nakhonthai/ESP32APRS_Audio/README.md

## Arduino core for the ESP32, ESP32-C3, ESP32-C6 and ESP32-S3

# ESP32APRS Audio(Speaker/Mic) Project

ESP32APRS Audio is a Internet Gateway(IGate)/Digital Repeater(DiGi)/Tracker/Weather(WX)/Telemetry(TLM) with AFSK/GFSK TNC Built in that is implemented for Espressif ESP32 processor.

## Feature

* Supported hardware: ESP32DR Simple,ESP32DR,D.I.Y Other
* Supported RF Module: SA8x8/FRS VHF/UHF/350 model
* Support APRS internet gateway (IGATE)
* Support APRS digital repeater (DIGI)
* Support APRS tracker (TRACKER)
* Support APRS Weather (WX)
* Support APRS telemetry (TLM)
* Support APRS Message (MSG)
* Support GNSS External mod select UART0-2 and TCP Client
* Support TNC External mod select UART0-2 and Yaesu packet
* Support APRS IGATE/DIGI/WX/Telemetry with fix position for move position from GNSS
* Using ESP-Arduino development on Visual studio code + Platform IO
* Implementing software modem, decoding and encoding
* Support monitor display information and statistices
* Support Wi-Fi multi station or WiFi Access point
* support Web Service config and control system
* support filter packet rx/tx on igate,digi,display
* support audio filter BPF,HPF
* support VPN wireguard
* support global time zone
* support web service auth login
* support BLUETOOTH SPP/BLE
* support PPPoS (PPP Over Serial GSM network)
* support MQTT
* support AT-Command config/ctl by channel UART,MSG,Bluetooth
* support Automatic REBOOT by interval time
* display received and transmit packet on the LED and display OLED or led color strip
* Multiple modems: credit coding from project [vp-digi](https://github.com/sq8vps/vp-digi)
  * 1200bps AFSK Bell 202 1200/2200Hz (VHF standard)
  * 300bps AFSK Bell 103 1600/1800Hz (HF standard)
  * 9600bps GFSK G3RUH (For ESP32-S3)
  * 1200bps AFSK V.23
* Analog-digital busy channel detection (data carrier detection)
* AX.25 coder/decoder
* FX.25 (AX.25 with error correction) coder/decoder, fully compatible with [Direwolf](https://github.com/wb2osz/direwolf) and [UZ7HO Soundmodem](http://uz7.ho.ua/packetradio.htm)

## Hardware screen short
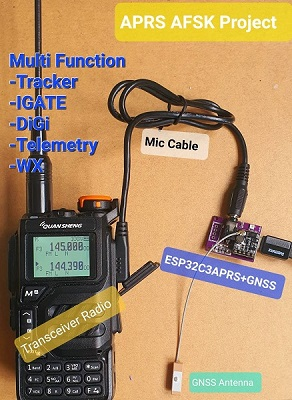
[picture p1: image/ESP32C3APRS_Radio.jpg]
esp32c3aprs_radio
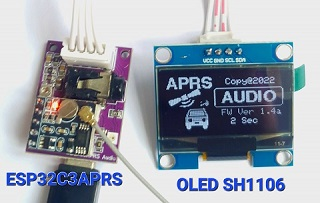
[picture p2: image/ESP32C3APRS_OLED.jpg]
esp32c3aprs_oled
 
esp32dr_simple esp32dr_sa868
esp32dr_sa868_pcb

## Hardware mod
esp32dr_sql 

## Web service screen short
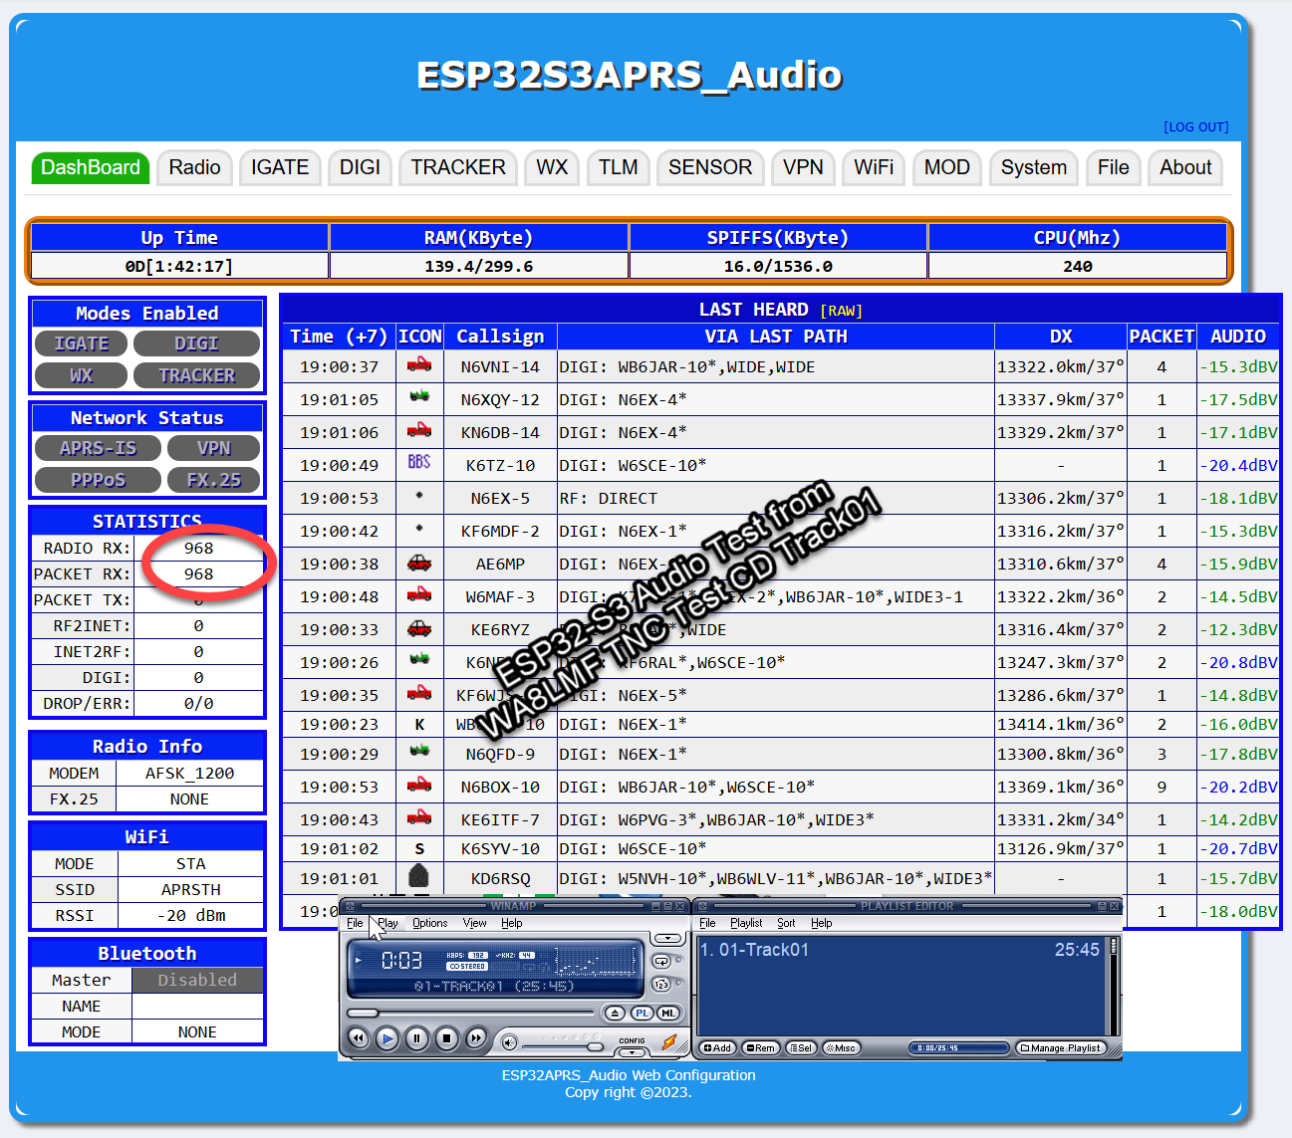
[picture p3: image/ESP32S3_CDTest.png]
ESP32S3_CDTest
 screen_dashboard screen_igate \
screen_mod

## ESP32DR_SA868
Share project [here](https://oshwlab.com/APRSTH/esp32sa818) \
Schematic [here](doc/ESP32DR_SA868/ESP32DR_SA868_sch.pdf) \
PCB Gerber [hare](doc/ESP32DR_SA868/ESP32DR_SA868_Gerber.zip)

## ESP32DR Simple

esp32dr_simple_3d

ESP32DR Simple Circut is small interface board for connecting to a transceiver.

* PCB size is 64x58mm
* PCB Single size
* RJ11 6 Pin out to Radio

### Fix Audio input/output port
|ESP32 Core|ADC(Speaker)|DAC(Mic)|
|---|:---:|---|
|ESP32|GPIO36|GPIO26|
|ESP32-C3|GPIO0|GPIO1|
|ESP32-S3|GPIO1|GPIO2|

### Schematic
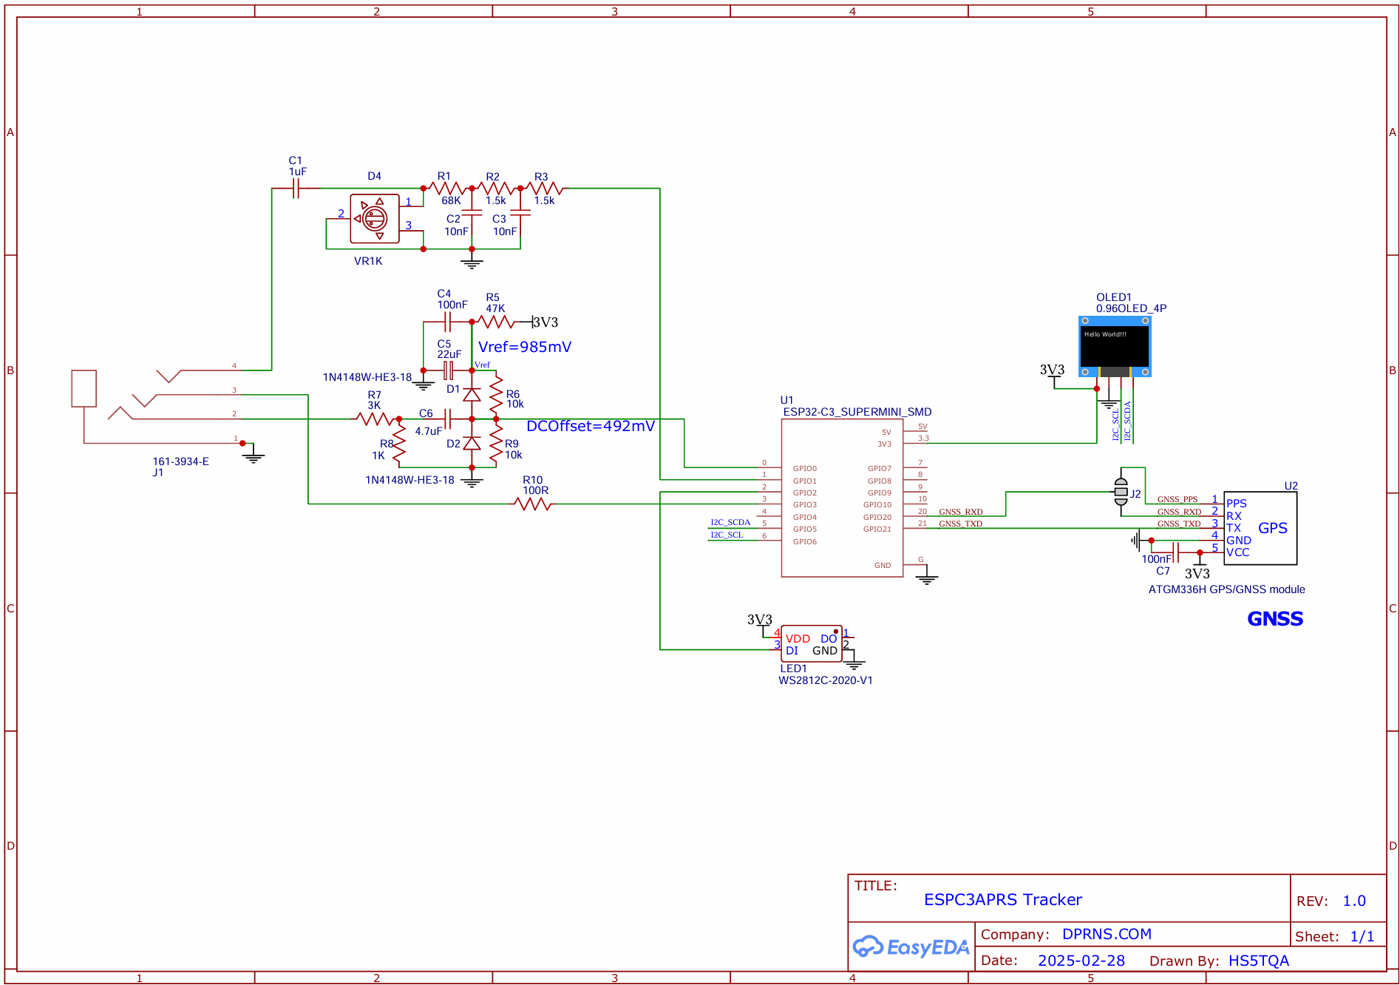
[picture p4: image/Schematic_ESPC3_APRS.png]
ESP32C3APRS


ESP32DR_Simple

### CAD data
 
The gerber data is [here](doc/Gerber_ESP32DR_Simple.zip)

The PCB film positive is [here](doc/PCB_Bottom.pdf)

The PCB film negative is [here](doc/PCB_Bottom_Invert.pdf)

The PCB Layout is [here](doc/PCB_Layout.pdf)

The ESP32DR_Simple Schematic PDF is [here](doc/ESP32DR_Simple_Schematic.pdf)

The ESP32C3APRS Schematic PDF is [here](doc/Schematic_ESPC3_APRS.pdf)

### BOM list  

|Reference|Value|Description|
|---|:---:|---|
|U1|ESP32 DEVKIT|DOIT ESP32 DEVKIT (โมดูล ESP32)|
|RP2|1K|VR 3362W (R ปรับค่าเสียงออก)|
|RP1|10K|VR 3362W (R ปรับค่าเสียงเข้า)|
|RJ11|RJ11-6P6C|แจ๊คโมดูล RJ11 แบบ 6ขา|
|R13,R12,R11,R5,R3,R9|1K|R 1K 1/4W (ค่าสี: น้ำตาล ดำ แดง)|
|R7,R18,R19|100R|R 100R  1/4W (ค่าสี: น้ำตาล ดำ ดำ)|
|R6,R2,R1|10K|R 10k  1/4W  (ค่าสี: น้ำตาล ดำ ส้ม)|
|R4|3K|R 3k 1/4W (ค่าสี: ส้ม ดำ แดง)|
|R10|33K|R 33K 1/4W (ค่าสี: ส้ม ส้ม ส้ม)|
|Q1|2N3904|ทรานซิสเตอร์ NPN (TO-92)|
|LED3|LED 3.5mm|สีเหลือง แสดงส่งสัญญาณ TX|
|LED2|LED 3.5mm|สีเขียว แสดงรับสัญญาณ RX|
|LED1|LED 3.5mm|สีแดง แสดงไฟเข้าทำงาน|
|L1|L or JMP|L Isolate or Jumper|
|C11|100uF/6.3V|ตัวเก็บประจุแบบอิเล็กโทรไลติก|
|C4,C5|100nF|ตัวเก็บประจุแบบเซรามิกมัลติเลเยอร์|
|C6|470uF/10V|ตัวเก็บประจุแบบอิเล็กโทรไลติก|
|C1,C3,C10|100nF หรือ 0.1uF|ตัวเก็บประจุแบบโพลีโพรไพลีน|
|C2|10nF หรือ 0.01uF|ตัวเก็บประจุแบบโพลีโพรไพลีน|
|D2,D1|1N4148|ไดโอด หรือใช้ C 0.01uF แทนได้|

*R18 and R19 ไม่ใส่ก็ได้.  
*D2,D1 เปลี่ยนเป็นตัวเก็บประจุแบบเซรามิกมัลติเลเยอร์ค่า 10nF แทนได้ 
*หากใช้ต่อกับวิทยุรับส่งเข้าขาไมค์นอก ให้เปลี่ยน R4 เป็น 100K

จัดซื้อชุดคิทผ่าน Shopee ได้ที่ [คลิ๊ก](https://shopee.co.th/product/45191268/13373396785)

The Howto DIY is [here](doc/ESP32DR_DIY-Thai.pdf)

### Mounting drawing

mounting

### Transceiver connection

Solder jumper is needed depending on a transceiver.

ESP32DR_Pinout

|Manufacture|RJ11-1 (+VIN)|RJ11-2 (SPK)|RJ11-3 (PTT)|RJ11-4 (GND)|RJ11-5 (MIC)|RJ11-6 (SQL)|
|---|---|---|---|---|---|---|
|Alinco DR-135(DB9)|-|2|7|5|9|1|
|IC2200(RJ45)|-|SP|4|5|6|-|
|FT-2800(RJ11)|-|SP|1|3|2|-|
|HT Mic Cable|-|SPK|PTT|GND|MIC|-|

for Alinco DR-135(DB9)

Alinco

for ICOM IC2200(RJ45)

IC2200

for Yaesu FT-2800(RJ11)

FT2800

for Handheld

Handheld

HT-RX

## ESP32APRS_Audio firmware installation (do it first time, next time via the web browser)
- 1.Connect the USB cable to the ESP32 Module.
- 2.Download firmware and open the program ESP32 DOWNLOAD TOOL, set it in the firmware upload program, set the firmware to ESP32_Vxx.bin, location 0x10000 and partitions.bin at 0x8000 and bootloader.bin at 0x1000 and boot.bin at 0xe000, if not loaded, connect GPIO0 cable to GND, press START button finished, press power button or reset (red) again.
- 3.Then go to WiFi AP SSID: ESP32APRS_Audio and open a browser to the website. http://192.168.4.1 password: aprsthnetwork Can be fixed Or turn on your Wi-Fi router.
- 4.Push **BOOT** button long >100ms to TX Position and >10Sec to Factory Default

ESP32Tool

## ESP32 Flash Download Tools
https://www.espressif.com/en/support/download/other-tools

## PlatformIO Quick Start

1. Install [Visual Studio Code](https://code.visualstudio.com/) and [Python](https://www.python.org/)
2. Search for the `PlatformIO` plugin in the `VisualStudioCode` extension and install it.
3. After the installation is complete, you need to restart `VisualStudioCode`
4. After restarting `VisualStudioCode`, select `File` in the upper left corner of `VisualStudioCode` -> `Open Folder` -> select the `ESP32APRS` directory
5. Click on the `platformio.ini` file, and in the `platformio` column, cancel the sample line that needs to be used, please make sure that only one line is valid
6. Click the (✔) symbol in the lower left corner to compile
7. Connect the board to the computer USB
8. Click (→) to upload firmware and reboot again
9. After reboot display monitor and reconfig

## APRS Server service

- APRS SERVER of T2THAI at [aprs.dprns.com:14580](http://aprs.dprns.com:14501), CBAPRS at [aprs.dprns.com:24580](http://aprs.dprns.com:24501)
- APRS SERVER of T2THAI ampr host at [aprs.hs5tqa.ampr.org:14580](http://aprs.hs5tqa.ampr.org:14501)
- APRS MAP SERVICE [http://aprs.dprns.com](http://aprs.dprns.com)

## Developer/Support Information

- Author:	Mr.Somkiat Nakhonthai
- Callsign:	HS5TQA,Atten,Nakhonthai
- Country:	Bangkok,Thailand
- Github:	[https://github.com/nakhonthai](https://github.com/nakhonthai)
- Youtube:	[https://www.youtube.com/@HS5TQA](https://www.youtube.com/@HS5TQA)
- TikTok:   [https://www.tiktok.com/@hs5tqa](https://www.tiktok.com/@hs5tqa)
- Facebook:	[https://www.facebook.com/atten](https://www.facebook.com/atten)
- Telegram: [https://t.me/APRSTH](https://t.me/APRSTH)
- TelegramID: @HS5TQA
- WeChatID: HS5TQA

## Donate

To support the development of ESP32APRS you can make us a donation using [github sponsors](https://github.com/sponsors/nakhonthai). \
If you want to donate some hardware to facilitate APRS porting and development, [contact us](https://www.facebook.com/atten). \
 

## ESP32 Flash Download Tools
https://www.espressif.com/en/support/download/other-tools

## Credits & Reference

- ESP32TNC project by amedes [ESP32TNC](https://github.com/amedes/ESP32TNC)
- APRS Library by markqvist [LibAPRS](https://github.com/markqvist/LibAPRS)
- vp-digi project by sq8vps [vp-digi](https://github.com/sq8vps/vp-digi)

## HITH
This project implement by APRS text (TNC2 Raw) only,It not support null string(0x00) in the package.
