nakhonthai/ESP32APRS_Audio/(threads)

Thread 3 (2023-09-07):

Multi-line packets are forwarded by the igate, allowing command injection attacks

hessu, 2023-09-07:
https://github.com/nakhonthai/ESP32IGate/blob/b1386e0716aec2434063c5d0689d838af088dd84/src/igate.cpp#L83

APRS packets are only supposed to contain a single line of data. If a packet containing multiple lines of data (with some CR LF sequences in there), this igate now forwards all of those lines to the APRS-IS server. It generates the packet header for the first line it sends, but the additional lines will be forwarded unmodified, without header of any sort, and may contain additional headers, or anything else.

The second line in the received packet could just as well be an APRS-IS server command, such as `#filter p/N ` which would suddenly cause the igate to receive a lot of packets from the APRS-IS server.

From https://github.com/hessu/aprsc/blob/main/doc/IGATE-HINTS.md:

> Please do not modify packet data. Do not trim spaces from the end, do not remove non-ASCII bytes such as 0x1C or 0x00. Just send everything on the first line, up to the newline (either first CR or LF character seen in packet).

Stop sending at the first CR **or** LF character in the packet, and send a CR LF sequence at the end of that line.

Thanks!

nakhonthai, 2023-10-12:
Thanks you.

hessu, 2023-10-16:
Hello,

This ticket has been closed without fixing the issue? The bug needs to be fixed to make the igate work correctly. Thanks1

erstec, 2023-10-16:
@nakhonthai
It should be same fix as here https://github.com/erstec/APRS-ESP/pull/49/files

nakhonthai, 2023-10-17:
I understand the problem as Hessu said, regarding CR, LF and Binary in frames.
But I don't think it's due to my project.Please provide information about problems in aprsc log caused by this project.

Because the TNC and igate code are combined together, the TNC section has CRC checks in the AX.25 protocol and the APRS info data is text only, with no assci or binary.
Therefore, no CR,LF or Binary occurs in the frame package received from RF. It still follows the rules of AX.25 and APRS protocol.

The problems mentioned I found this a lot in other igate projects.
In practice, no erroneous packets should be sent onto the Internet network.
There is a serial communication uart error between TNC and IGATE.
The TNC is made using an Arduino board (ATmega328), because the arduiono uses a crystal frequency of 8Mhz/16Mhz,This causes serial communication uart errors, where 9600bps has an error of 0.2% or 115200bps has an error of 8.5% ,See other errors You can find it in the data sheet in the table 19-12 of ATmega328.

However, I will include this bug in my code. To prevent mistakes and to provide a basis for others to develop further.

nakhonthai, 2023-10-17:
> Hello,
>
> This ticket has been closed without fixing the issue? The bug needs to be fixed to make the igate work correctly. Thanks!

I will upload again affter open shared ESP32APRS _T-TWR Plus project.

hessu, 2023-10-17:
@nakhonthai Please reopen the bug until the bug is fixed, so that it's easier to track it? Also, so that it is clearer to everyone that the bug is still present.

hessu, 2023-10-17:
> But I don't think it's due to my project.Please provide information about problems in aprsc log caused by this project.
>
> Because the TNC and igate code are combined together, the TNC section has CRC checks in the AX.25 protocol and the APRS info data is text only, with no assci or binary. Therefore, no CR,LF or Binary occurs in the frame package received from RF. It still follows the rules of AX.25 and APRS protocol.

The underlying problem is that the AX.25 protocol allows any station to transmit a packet which contains many lines of data, with CR / LF sequences in them.

On the other hand, the APRS protocol (not a great protocol as such) consists of one-line packets. Likewise the APRS-IS network deals with one-line packets.

If an igate forwards a packet of multiple lines from RF to APRS-IS, any station on RF may inject commands to the APRS-IS server, effectively making a DOS attack, or other confusion. This may be done intentionally or accidentally, or due to packet corruption (which is quite common, actually).

For example, a station may send the following two-line packet on RF:

```
N0CALL-9>APRS:>valid APRS packet here<CR><LF>
#filter p/A/N/K/W
```

Your igate will forward the second line, unmodified, to the APRS-IS server. The server will  treat it as an individual packet or command, and will not know it is somehow attached or related to the first line, because the CR LF sequence is the delimiter between two packets, according to the APRS-IS.  The APRS-IS server will start sending all packets sourced by US callsigns to your igate, which might be choked or confused by the large amount of traffic.

The fix is to not send anything beyond the first CR or LF, and to always terminate with a CR LF when sending to APRS-IS.

https://github.com/hessu/aprsc/blob/main/doc/IGATE-HINTS.md#packets-modified-by-igates

Thread 5 (2023-11-01):

Feature Request: daughter card or optional space for an sa818

derekmurawsky, 2023-11-01:
This is a great project. I think it would be awesome to extend the board or create a daughter card for it which could take an [SA818](https://www.nicerf.com/item/1w-embedded-walkie-talkie-module-sa818) (or similar) to make an all-in-one APRS digipeter/igate. I could also see a similar daughter card for a LoRa radio, which seems to be gaining popularity in amateur radio circles.
I'd love to help with something like this, but my embedded hardware/software skills are limited. Happy to support with testing, though.

nakhonthai, 2023-11-03:
I'm thinking of creating a new project ESP32APRS for All-in-One.

derekmurawsky, 2023-11-04:
I'd be happy to provide input and testing... Even code, though I'm not the best there. I believe there is a need for a true, simple, open source hardware APRS tracker/digi/igate and I suspect the esp32 would be able to handle it all.

erstec, 2023-11-04:
> I'd be happy to provide input and testing... Even code, though I'm not the best there. I believe there is a need for a true, simple, open source hardware APRS tracker/digi/igate and I suspect the esp32 would be able to handle it all.

Ir handles already, several devices are constantly online with ESP32 for last year+ https://github.com/erstec/APRS-ESP
More, it have official APRS TOCALL

nakhonthai, 2023-11-13:
I'm update in the Version 1.0 ,you can add and mod GPIO of RF Modules.

derekmurawsky, 2023-11-13:
Awesome!

Closed 2023-11-13.

Thread 7 (2023-12-26):

Decoding level info on esp32

f4goh, 2023-12-26:
Hello,
I have the simple circuit connected to a yaesu Ft-7900 on data packet din 6.
the fsk signal on GPIO36 VP are 50mVpp. It seems too low.
When i put the speaker output, that's works.
What is the minimum level in Gpio36 to decode FSK ?
the txing are working well.
73

nakhonthai, 2024-01-01:
You can see ADC Attenuation.
Mininum 0dB at 100mV-950mV(50mVpp-457mVpp) and DC Offset at 950mV/2 (Vdc at GPIO36)
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

Thread 8 (2024-01-05):

Using external TNC

9M2IBR, 2024-01-05:
Im using VPdigi external TNC and connected to ESP32 uart2 but its doest work.

nakhonthai, 2024-01-16:
I'll test kiss mode it again.

SQ7MHX, 2024-02-11:
Hello,
I facing the same issue with vp digi. I would ask if there is any update about it.
Best regards,

Thread 10 (2024-01-11):

Parts list

Szetya, 2024-01-11:
Hi!

Very nice project. I would like to build it. If possible, could you put a parts list of the SA868 version in the documentation?
Thank you very much!

nakhonthai, 2024-01-16:
look at in the schematic.
https://github.com/nakhonthai/ESP32IGate/tree/master/doc/ESP32DR_SA868

Closed 2024-01-16.

Thread 12 (2024-01-21):

1.1D tx ptt problem

TA1FM, 2024-01-21:
I was using v0.9, I installed v1.1D, the TX LED does not light up and it does not switch the radio to TX. There was no such problem in v0.9.

cabralcr, 2024-01-24:
Here the ptt is working normally

nakhonthai, 2024-01-26:
Check in MOD Tab of GPIO and active pinout.

TA1FM, 2024-01-26:
I made the esp32 igate circuit in v08, I connected it to an external handheld radio, I did not use a module like SA668, tx led and ptt were working fine, when I installed v1.1D on the same system, tx led and ptt did not work.
Even though I made the PTT GPIO settings in the MOD tab in the interface, it does not work. I tried many of the settings in the RADIO tab, but it still did not work. I could not figure out why. When I go back to the old v08 or v09 software, it works without any problems.
I follow your work with pleasure, thank you for your interest.
TA1FM
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

nakhonthai, 2024-01-30:
If SQL pin signal not used, it to  fix  SQL  GPIO = -1

TA1FM, 2024-01-30:
I'm sorry to take your valuable time, but when I set SQL GPIO to "-1", esp32 keeps resetting during TX.
https://photos.app.goo.gl/8rRFmnzmNKU61nzv5

nakhonthai, 2024-01-31:
I've fixed this in the version 1.2b, please update firmware again.

TA1FM, 2024-01-31:
I installed V1.2b, but during TX, ESP resets again. If I turn off the INET2RF switch, there is no problem as only igate.

TA1FM, 2024-03-04:
There is no problem in the software without an OLED screen, but in the software with an OLED screen, the problem was solved when I added 2 pull-up 4k7 resistors to the data paths of the screen.

Closed 2024-03-04.

Thread 13 (2024-01-24):

Losing TX packet

cabralcr, 2024-01-24:
I noticed that the eps32 transmits but at times my radio does not decode the frames, and sometimes it normally decodes someone else. Is there a way to calibrate it to adjust the tx?

nakhonthai, 2024-01-26:
In the tab Dashboard you can see table LAST HEARD [RAW], and click [RAW]
You customize volume audio at -15dBv
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

cabralcr, 2024-01-28:
I'm losing TX packets on my Radio Yaesu FT5D, it shows on the esp32igate panel but on my radio I'm experiencing loss. There are some that decode others that don't.

nakhonthai, 2024-01-30:
Update firmware version 1.2a again.

Thread 14 (2024-01-28):

Delayed packet deliver

Ciumaros, 2024-01-28:
At Fw 1.2, in my case, I notice an problem when transmitting packets, the esp32-s puts transceiver in tx but doez not deliver packets until  20 to 30 seconds have passed. this behaver flods the network and stresses the transceiver alot.

cabralcr, 2024-01-29:
This is also happening to me, I end up losing packages.

nakhonthai, 2024-01-30:
OK, It is expected that there will be a TX delay.
Fix in next version.

Thread 17 (2024-02-01):

Feature Request: transmit an emergency beacon

nicolassolop, 2024-02-01:
Hello, let me tell you that I think your project is great and very useful.

With a group of friends we go out to the mountains frequently and it would be ideal to be able to carry an APRS tracker.

Something important for us would be to have the possibility of transmitting an emergency beacon in case of having a problem.

We thought it would be an option to be able to press a button for a few seconds and have this trigger an emergency beacon.

What do you think about the idea?

nakhonthai, 2024-02-01:
Thank you for the advice.
I already have this idea. It is sending urgent information for emergencies. or notify various statuses in real time.

nicolassolop, 2024-02-07:
Yes, that would be very usefull for a lot of people. Would be great to have this in future releases

Thread 19 (2024-02-02):

Bug: V1.2b - IGate -> RF causes ESP32 to reset.

M0XZS, 2024-02-02:
Since moving from V1.1 to 1.2, I have noticed that the ESP starts to reset when the INET to RF is turned on in the IGGate.

I am using an external radio (with RF shielding) - nothing changed other than the firmware, and it looks like the transmitter does into an extended transmission with no APRS modulation, and then the ESP32 resets.

I did a Diff on the V1.1 and V1.4b changes, and I can not see any reason this would happen.

M0XZS, 2024-02-02:
I put the debugging on and found this just before the reset:

[I][esp32-hal-i2c.c:1138] i2cProcQueue(): Bus busy, reinit
[W][esp32-hal-i2c.c:1419] i2cCheckLineState(): invalid state sda(21)=0, scl(22)=1
[D][esp32-hal-i2c.c:1427] i2cCheckLineState(): Recovered after 1 Cycles
[I][esp32-hal-i2c.c:1138] i2cProcQueue(): Bus busy, reinit
[W][esp32-hal-i2c.c:1419] i2cCheckLineState(): invalid state sda(21)=0, scl(22)=1
[D][esp32-hal-i2c.c:1427] i2cCheckLineState(): Recovered after 1 Cycles
[I][esp32-hal-i2c.c:1138] i2cProcQueue(): Bus busy, reinit
E (176382) task_wdt: Task watchdog got triggered. The following tasks did not reset the watchdog in time:
E (176382) task_wdt:  - IDLE0 (CPU 0)
E (176382) task_wdt: Tasks currently running:
E (176382) task_wdt: CPU 0: taskAPRS
E (176382) task_wdt: CPU 1: IDLE1
E (176382) task_wdt: Aborting.
abort() was called at PC 0x4018d32c on core 0

M0XZS, 2024-02-02:
Returning Task 1 to priority 1 seems to fix the problem:

    // Task 1
    xTaskCreatePinnedToCore(
        taskAPRS,        /* Function to implement the task */
        "taskAPRS",      /* Name of the task */
        8192,            /* Stack size in words */
        NULL,            /* Task input parameter */
        1,               /* Priority of the task */
        &taskAPRSHandle, /* Task handle. */
        0);              /* Core where the task should run */

M0XZS, 2024-02-02:
This did improve it but did not fix it.

M0XZS, 2024-02-05:
This seems to be the problem, but not sure why yet:

[I][esp32-hal-i2c.c:1138] i2cProcQueue(): Bus busy, reinit
[I][esp32-hal-i2c.c:1138] i2cProcQueue(): Bus busy, reinit
[I][esp32-hal-i2c.c:1138] i2cProcQueue(): Bus busy, reinit
[I][esp32-hal-i2c.c:1138] i2cProcQueue(): Bus busy, reinit
[I][esp32-hal-i2c.c:1138] i2cProcQueue(): Bus busy, reinit
[I][esp32-hal-i2c.c:1138] i2cProcQueue(): Bus busy, reinit

and it gets into a loop.

TA1FM, 2024-02-29:
Hello, can you explain how you solved the problem in more detail, we would like to benefit from it. Can you also add the corrected fiemware.bin file, thank you.
TA1FM

Thread 20 (2024-02-06):

ESP32 keep resseting after configuring GPS TCP

mariano80, 2024-02-06:
Hi my friend! I installed this fw on my esp32 to test and is a great development. Thanks a lot for share with the community.

I tryed to configure my phone to thethe gps signal so esp32igate but when i configure the app and the esp32 connect it keeps rebooting. I tryed to enter in the /gnss or int he dashboard but didnt see anything. In my phone I see theip os esp trying to connect and then see it rebooting.

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

If you need any more info or testing let me know.

Regards,
LW2DHT

Thread 21 (2024-02-17):

Version 1.2d restarting

cabralcr, 2024-02-17:
I updated to version 1.2d and when it connects to wifi it starts doing a reboot loop.
Note: I already tested it on two esp32s and the same problem continued.
Any solution?

cabralcr, 2024-02-18:
Version 1.1 is ok, does not restart.

cabralcr, 2024-03-09:
Anyone else having this problem?

I'm installing version 1.2d directly through the software, do I have to install a previous version and then install it via the web? Any tips please! Grateful

Thread 22 (2024-03-18):

version 12d becomes unresponsive after a few days

nicolassolop, 2024-03-18:
The current version becomes unresponsive after a few days and needs to be restarted. It would be interesting to add a functionality that allows it to restart automatically every few hours and thus avoid these situations.

F4HUO, 2024-04-04:
I faced the same issue with version 1.2. With version 1.3 it is the same with but with a higher occurency.
I can try to provide more info if required, just let me know.

F4HUO, 2024-04-09:
@nicolassolop I noticed that removing the oled screen is improving a lot the stability.

Thread 23 (2024-03-21):

Crashed after open openning "System" web-page try

circool, 2024-03-21:
hi once (first time) i open system page, but newer again.

rewrite, reboot, eeprom erasing not help.
```
E (68892) task_wdt: Task watchdog got triggered. The following tasks did not reset the watchdog in time:
E (68892) task_wdt:  - async_tcp (CPU 1)
E (68892) task_wdt: Tasks currently running:
E (68892) task_wdt: CPU 0: IDLE0
E (68892) task_wdt: CPU 1: IDLE1
E (68892) task_wdt: Aborting.
abort() was called at PC 0x4017ca74 on core 0

ELF file SHA256: 0000000000000000

Backtrace: 0x40088da0:0x3ffbf9f0 0x4008901d:0x3ffbfa10 0x4017ca74:0x3ffbfa30 0x40087449:0x3ffbfa50 0x40199d4f:0x3ffbca50 0x4017e403:0x3ffbca70 0x4008b8f5:0x3ffbca90 0x4008a06e:0x3ffbcab0
  #0  0x40088da0:0x3ffbf9f0 in invoke_abort at /home/runner/work/esp32-arduino-lib-builder/esp32-arduino-lib-builder/esp-idf/components/esp32/panic.c:715
  #1  0x4008901d:0x3ffbfa10 in abort at /home/runner/work/esp32-arduino-lib-builder/esp32-arduino-lib-builder/esp-idf/components/esp32/panic.c:715
  #2  0x4017ca74:0x3ffbfa30 in task_wdt_isr at /home/runner/work/esp32-arduino-lib-builder/esp32-arduino-lib-builder/esp-idf/components/esp32/task_wdt.c:252
  #3  0x40087449:0x3ffbfa50 in _xt_lowint1 at /home/runner/work/esp32-arduino-lib-builder/esp32-arduino-lib-builder/esp-idf/components/freertos/xtensa_vectors.S:1154
  #4  0x40199d4f:0x3ffbca50 in esp_pm_impl_waiti at /home/runner/work/esp32-arduino-lib-builder/esp32-arduino-lib-builder/esp-idf/components/esp32/pm_esp32.c:492
  #5  0x4017e403:0x3ffbca70 in esp_vApplicationIdleHook at /home/runner/work/esp32-arduino-lib-builder/esp32-arduino-lib-builder/esp-idf/components/esp32/freertos_hooks.c:108
  #6  0x4008b8f5:0x3ffbca90 in prvIdleTask at /home/runner/work/esp32-arduino-lib-builder/esp32-arduino-lib-builder/esp-idf/components/freertos/tasks.c:3507
  #7  0x4008a06e:0x3ffbcab0 in vPortTaskWrapper at /home/runner/work/esp32-arduino-lib-builder/esp32-arduino-lib-builder/esp-idf/components/freertos/port.c:355 (discriminator 1)

Rebooting...
ets Jul 29 2019 12:21:46

rst:0xc (SW_CPU_RESET),boot:0x13 (SPI_FAST_FLASH_BOOT)
configsip: 0, SPIWP:0xee
clk_drv:0x00,q_drv:0x00,d_drv:0x00,cs0_drv:0x00,hd_drv:0x00,wp_drv:0x00
mode:DIO, clock div:1
load:0x3fff0018,len:4
load:0x3fff001c,len:1044
load:0x40078000,len:10124
load:0x40080400,len:5856
entry 0x400806a8

Start ESP32IGate V1.2
```

circool, 2024-03-23:
after several re-flashing the problem disappeared

Thread 25 (2024-03-29):

input pin

alejandro-atala, 2024-03-29:
Where in the program is it to define the audio input pin? I have an esp 32 that on pin 2 VP, it's the Enable and it doesn't work for me, I need to change it

Closed 2024-03-31.

Thread 26 (2024-03-31):

No decode

alejandro-atala, 2024-03-31:
The Igate works.  But it only decodes the packets that I send from aprsdroid via radio or directly to the board.  All the other trackers I have with Arduino (indyTrack) and even a Vaisala RS41 probe do not decode them, turn on the RX LED but do not show them on the board.  What could it be that it doesn't decode certain trackers?  I tried different audio levels and it's still the same.  Since I have an Igate with a Raspberry and it decodes any type of trackers.

Thread 28 (2024-05-01):

Nuclear Radiation

Vitaliy86, 2024-05-01:
Nuclear Radiation levels if available. The X is the type indicator. We chose "X" for radiation.

http://aprs.org/aprs12/weather-new.txt

nakhonthai, 2024-05-19:
Thank for infomation.
Re design protocol for weather.

// c...s...g...t...r...p...P...h..b.....L...S..m...M...w...W....v...o...O...x....F....T....
#define WX_NONE 0
#define WX_WIND_DIR (1 << 0)       // c Wind Direction (in degrees)
#define WX_WIND_SPD (1 << 1)       // s Wind Speed (mhp)
#define WX_WIND_GUST (1 << 2)      // g Wind Gust	(peak wind speed in mph in the last 5 minutes)
#define WX_TEMP (1 << 3)           // t Temperature (Fahenheit)
#define WX_RAIN (1 << 4)           // r Rain collector (in hundredths of an inch) last hour
#define WX_RAIN24HR (1 << 5)       // p Rain collector (in hundredths of an inch) Last 24 Hr
#define WX_RAIN_GMT (1 << 6)       // P Rain collector (in hundredths of an inch) Sine Midnight (GMT+0)
#define WX_HUMIDITY (1 << 7)       // h Humidity
#define WX_BARO (1 << 8)           // b Barometric Pressure (in thenths of millibars/tenths of hPascal)
#define WX_LUMINOSITY (1 << 9)     // L,l Luminosity (in watts per square meter) L=0-999,l=1000-9999
#define WX_SNOW (1 << 10)          // S Snowfall (in inches) in the last 24 hours
#define WX_SOIL_TEMP (1 << 11)     // m Soil temperature (Fahenheit)
#define WX_SOIL_MOISTURE (1 << 12) // M Soil Moisture (0-40%VWC)
#define WX_WATER_TEMP (1 << 13)    // w Water (Fahenheit)
#define WX_WATER_TDS (1 << 14)     // W Water TDS(Total Dissolved Solids) 0-1000ppm
#define WX_WATER_LEVEL (1 << 15)   // v Water Level (in hundredths of an inch)
#define WX_PM25 (1 << 16)          // o Ordure PM 2.5 0~1000μg/m³
#define WX_PM100 (1 << 17)         // O Ordure PM 10 ,0~1000μg/m³
#define WX_CO2 (1 << 18)           // X,x Co2 (PPM) x=0-9999,X=010000-999999
#define WX_CH2O (1<<19)             //F,f Formaldehyde(CH2O) F=0-9999,f,1000-2000 μg/m³
#define WX_TVOC (1<<20)             // T

Thread 36 (2024-10-30):

Add log to serial output of the esp32

mprilepok, 2024-10-30:
Please add log  to serial output of the esp32. the log should help to detect problems o decoding messages.

5Breeze, 2025-01-07:
```
#ifdef CORE_DEBUG_LEVEL
    config.uart0_enable = true;
    config.uart0_baudrate = 921600;
    config.uart0_rx_gpio = 3;
    config.uart0_tx_gpio = 1;
    config.uart0_rts_gpio = -1;
```
I found a macro definition for enabling debug, which might be useful to you.

Thread 37 (2024-11-10):

Core  1 panic'ed (LoadProhibited)

workino, 2024-11-10:
Hello,
when i'm trying to use the igate and enable the int2rf the esp is resetting after some spots with the error:

[D][main.cpp:1338] pkgListUpdate(): New: pkgList_idx=15
Guru Meditation Error: Core  1 panic'ed (LoadProhibited). Exception was unhandled.
Core 1 register dump:
PC      : 0x4000c547  PS      : 0x00060730  A0      : 0x800e21c4  A1      : 0x3ffd0090
A2      : 0x00000000  A3      : 0x0000006c  A4      : 0x00000007  A5      : 0x00000003
A6      : 0x00000009  A7      : 0x3ffd00cc  A8      : 0x00000001  A9      : 0x00000001
A10     : 0x00000000  A11     : 0x3ffd016b  A12     : 0x00000001  A13     : 0x00000001
A14     : 0x3ffd0030  A15     : 0x3ffd013f  SAR     : 0x0000001d  EXCCAUSE: 0x0000001c
EXCVADDR: 0x00000000  LBEG    : 0x4000c2e0  LEND    : 0x4000c2f6  LCOUNT  : 0xffffffff

ELF file SHA256: 0000000000000000

Backtrace: 0x4000c547:0x3ffd0090 0x400e21c1:0x3ffd00b0 0x400e2bd6:0x3ffd00f0 0x400e3292:0x3ffd0190 0x400e6642:0x3ffd01c0 0x400d5a2d:0x3ffd0860 0x400db00a:0x3ffd08a0 0x4008a91a:0x3ffd0be0

Rebooting...

I deployed the image via visualstudiocode and via esp32 flash tool. Both case same error.

Is it possible to fix it?
I'm the only one having this error?

Regards

workino, 2024-11-12:
Problem Found and fixed.
Is in the management of the WX part in the parse_aprs.cpp file

Closed 2024-11-12.

Thread 39 (2025-02-03):

Hello! Now Baofeng has released a new walkie talkie model called 5RH POR with APRS function, but this gateway cannot resolve it. May I ask how I can search for coding rules or find the reason? Thank you!

574379523, 2025-02-03:
Hello! Now Baofeng has released a new walkie talkie model called 5RH POR with APRS function, but this gateway cannot resolve it. May I ask how I can search for coding rules or find the reason? Thank you!

nakhonthai, 2025-03-23:
Baofeng 5RH is APRS function, compatible with YAESU (transmit only)

574379523, 2025-03-23:
 
 
您好，我最近正在休假中，无法亲自回复您的邮件。我将在假期结束后，尽快给您回复。

Thread 43 (2025-04-01):

Time reset issue after power failure

maoxiansen, 2025-04-01:
Each time you disconnect the power supply, the time in the system settings will return to the default

nakhonthai, 2025-08-25:
Time automatic set from GPS or internet.

Closed 2025-08-25.

Thread 44 (2025-04-15):

ESP32IGate V1.3 compile errors

stefann63, 2025-04-15:
Downloaded the latest V1.3 and got only 4 errors.

[platformio]
;default_envs = esp32c3
;default_envs = esp32c6
default_envs = esp32-sh1106
;default_envs = esp32s3-sh1106

[env]
;[env:esp32doit-devkit-v1]
;platform = https://github.com/pioarduino/platform-espressif32/releases/download/51.03.07/platform-espressif32.zip
;platform = https://github.com/pioarduino/platform-espressif32/releases/download/stable/platform-espressif32.zip
platform = https://github.com/pioarduino/platform-espressif32/releases/download/54.03.20-rc1/platform-espressif32.zip
;platform = espressif32@6.9.0

C:/Users/stefan/.platformio/packages/framework-arduinoespressif32/libraries/NetworkClientSecure/src/ssl_client.cpp:281:31: error: too many arguments to function 'int mbedtls_pk_parse_key(mbedtls_pk_context*, const unsigned char*, size_t, const unsigned char*, size_t)'
C:/Users/stefan/.platformio/packages/framework-arduinoespressif32/libraries/NetworkClientSecure/src/ssl_client.cpp:585:3: error: 'mbedtls_sha256_starts' was not declared in this scope; did you mean 'mbedtls_sha256_starts_ret'?
C:/Users/stefan/.platformio/packages/framework-arduinoespressif32/libraries/NetworkClientSecure/src/ssl_client.cpp:586:3: error: 'mbedtls_sha256_update' was not declared in this scope; did you mean 'mbedtls_sha256_update_ret'?
C:/Users/stefan/.platformio/packages/framework-arduinoespressif32/libraries/NetworkClientSecure/src/ssl_client.cpp:587:3: error: 'mbedtls_sha256_finish' was not declared in this scope; did you mean 'mbedtls_sha256_init'?

zkf0100007, 2025-06-30:
you need to change 4 places in ssl_client.cpp
1.
ret = mbedtls_pk_parse_key(&ssl_client->client_key, (const unsigned char *)cli_key, strlen(cli_key) + 1, NULL, 0, mbedtls_ctr_drbg_random, &ctr_drbg);
to
ret = mbedtls_pk_parse_key(&ssl_client->client_key, (const unsigned char *)cli_key, strlen(cli_key) + 1, NULL, 0);
2.
mbedtls_sha256_starts
to
mbedtls_sha256_starts_ret
3.
mbedtls_sha256_update
to
mbedtls_sha256_update_ret
4.
mbedtls_sha256_finish
to
mbedtls_sha256_finish_ret

Thread 45 (2025-04-19):

Unable to receive normally, is pull-down resistance necessary?

verymoe, 2025-04-19:
I saw in the management backend that the ADC dc offset target value is 625mV, but the actual value is 830mV. I set the ADC attenuation to 11dB, which theoretically covers my input range, but the receive still doesn't work.

I saw a pull-down resistor used for the spk pin in the wiring tutorial. Is this necessary?

(I am not an electronics major, please forgive me if there is any misunderstanding)

verymoe, 2025-04-19:
Supplement: I use Baofeng UV 5R as transceiver
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

Closed 2025-04-22.

Thread 46 (2025-05-09):

v1.4 missing ax25.h and crc.h

Sinager, 2025-05-09:
Hi,
I'm trying to compile 1.4 running VSCode on Linux with target ESP32-C3.

Compile fails with the following error:

_lib/LibAPRS_ESP32/AX25.cpp:22:10: fatal error: ax25.h: No such file or directory
   22 | #include "ax25.h"
      |          ^~~~~~~~
compilation terminated._

This one is due to Linux being case sensitive: included files are in capital letters (AX25 iso ax25) and you can get around by creating copies / renaming / symlinking with the correct name.

32 | #include "esp32/rom/crc.h"
      |          ^~~~~~~~~~~~~~~~~
compilation terminated.

But didn't find a proper file for this one.

73
Stefano IZ0MJE
JN61fu - Rome Italy

Closed 2025-08-25.

Thread 47 (2025-05-10):

Reboot after login

nicolassolop, 2025-05-10:
Hello! When I log into the console and touch one or two screens, the DigiPeater restarts. If it's left running without logging into the console, this can go days without happening.

When I log in and interact with the menu, it restarts. I'm using the latest version of the software.

nakhonthai, 2025-07-04:
Check the power supply and Wi-Fi signal strength.

Thread 48 (2025-06-30):

How to set passcode

zkf0100007, 2025-06-30:
I could not find where to set the passcode during web GUI.
Could anyone help me ?
Thanks!

zkf0100007, 2025-06-30:
solved.
The passcode was generated in ESP32.

nakhonthai, 2025-07-04:
Automatic generated passcode.

zkf0100007, 2025-07-07:
Got it.
Thanks for your reply!

Thread 52 (2025-08-27):

version 15.a dont save setting after few reboots.

roca-linux, 2025-08-27:
process of settings goes well and it work for a time until you have to reboot it libe using the reboot butto, in the GUI or a factory reboot like unplug the cable. suddenly it lost all the settings. using wroom

nakhonthai, 2025-09-08:
Fix update V1.5b

Thread 54 (2025-09-08):

ESP32C3 release firmware has problems

YuYanDev, 2025-09-08:
The standard firmware package doesn't include the ESP32C3 firmware. So I chose the 8MB firmware package (it seems there's no 8MB version for the ESP32C3?).

After the flash was complete (the flashing tool indicated success), I didn't find any APRS Wi-Fi hotspots.

To this end, I tried checking the serial port information, which was printed as follows:

```
ESP-ROM:esp32c3-api1-20210207
Build:Feb  7 2021
rst:0x7 (TG0WDT_SYS_RST),boot:0xd (SPI_FAST_FLASH_BOOT)
Saved PC:0x40047ed2
Invalid chip id. Expected 5 read 9. Bootloader for wrong chip?
ets_main.c 333
Build:Feb  7 2021
rst:0x15 (USB_UART_CHIP_RESET),boot:0xd (SPI_FAST_FLASH_BOOT)
Saved PC:0x40047ed2
Invalid chip id. Expected 5 read 9. Bootloader for wrong chip?
ets_main.c 333
```

There seems to be a problem with the released firmware. Maybe the bootloader is not universal?
Hope you can solve this problem. Thank you.

YuYanDev, 2025-09-08:
After I successfully flashed using Platformio, I could access the wifi and enter the configuration backend. However, there was a problem with the firmware and the configuration could not be updated successfully. The interface reported an error.

nakhonthai, 2025-09-08:
Firmware ESP32-C3 at https://github.com/nakhonthai/ESP32APRS_Audio/releases/download/V1.5/ESP32C3_V15b.zip
Check address for bootloader,boot_app,partition and firmware

YuYanDev, 2025-09-08:
It works ! thank you

Closed 2025-09-08.

Thread 55 (2025-09-09):

SA868 VHF // ESP-WROOM-32 setup mod

ltiisidii, 2025-09-09:
What would be the correct configuration for an SA868 VHF with an ESP-WROOM-32, using the board from this project (https://oshwlab.com/APRSTH/esp32sa818)? In one of the images I see (but I’m not sure how to determine which is the correct value I should configure):

RX GPIO: 14

TX GPIO: 13

PD GPIO: 27 active: HIGH

H/L GPIO: 12 active: LOW

SQL GPIO: 33 active: LOW

PTT GPIO: 32 active: HIGH

I am using the ESP32_V15b.zip firmware.

eb2bra-crypto, 2025-10-06:
> The DC-Offset voltage must be half of the ADC attenuation range.

@nakhonthai Thank yo uvery much for your reply, but that is the topic.....
