nakhonthai/ESP32APRS_Audio/doc/Schematic_ESPC3_APRS.pdf

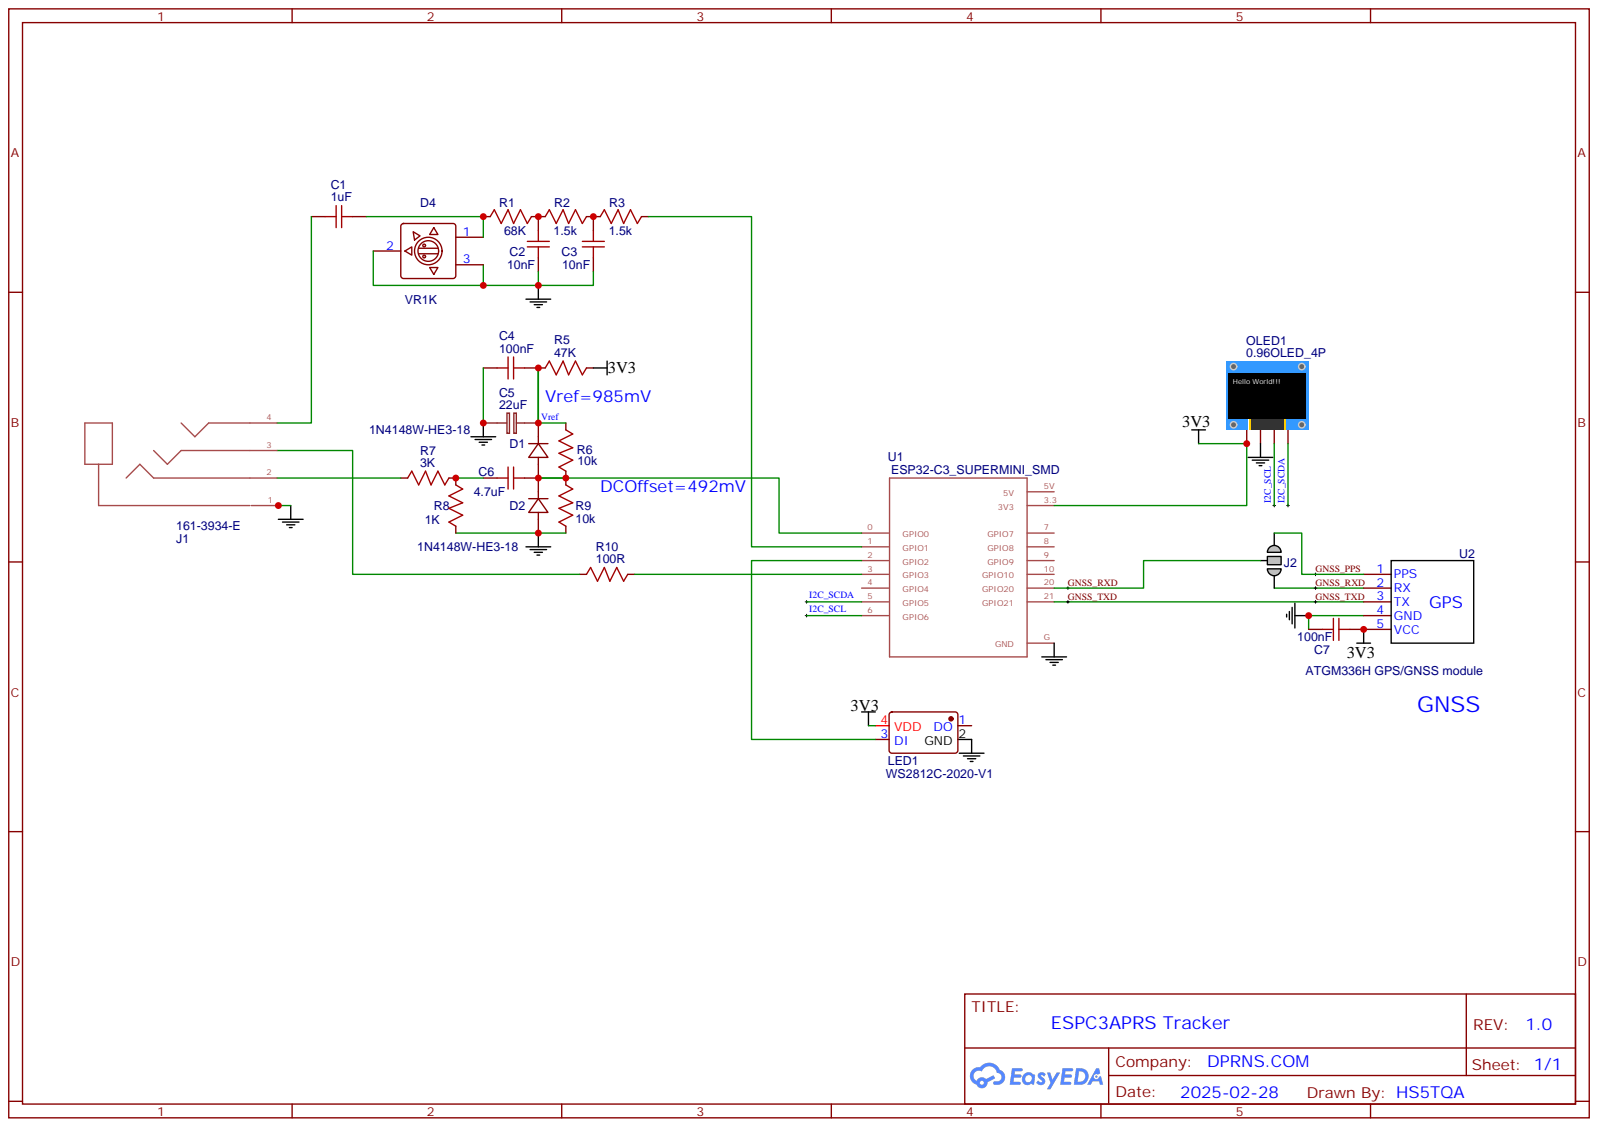
[picture p5: page 1]
