nakhonthai/ESP32APRS_Audio/src/main.cpp

/*
 Name:		ESP32 APRS Internet Gateway
 Created:	1-Nov-2021 14:27:23
 Author:	HS5TQA/Atten
 Support IS: host:aprs.dprns.com port:14580
 Support IS monitor: http://aprs.dprns.com:14501
 Support in LINE Group APRS Only
*/

#include <Arduino.h>
#include <AsyncTCP.h>
#include <esp_task_wdt.h>
#include "main.h"
#include <LibAPRSesp.h>
#include <limits.h>
#include <KISS.h>
#include "webservice.h"
#include <WiFiUdp.h>
#include "ESP32Ping.h"
#include <WiFi.h>
#include <WiFiMulti.h>
#include <WiFiClient.h>
#include "cppQueue.h"
#include "digirepeater.h"
#include "igate.h"
#include "message.h"
#include "wireguardif.h"
#include "wireguard.h"
#include "driver/pcnt.h"
#include "esp_wifi.h"

#include <TinyGPS++.h>
#include <pbuf.h>
#include <parse_aprs.h>

#include <Fonts/FreeSansBold9pt7b.h>
#include <Fonts/FreeSerifItalic9pt7b.h>
#ifndef GUI_LCD
#include <Fonts/Seven_Segment24pt7b.h>
#endif

#include "wireguard_vpn.h"
#include <WiFiUdp.h>

#include <WiFiClientSecure.h>

#include <SoftwareSerial.h>
// SoftwareSerial ss(-1, -1);

#include <ModbusMaster.h>

#include "handleATCommand.h"

#include "sensor.h"

#include <rom/spi_flash.h>
#include "FS.h"
#include <LITTLEFS.h>

#include <time.h>

#ifdef MQTT
#include <PubSubClient.h>
#endif

#include "AFSK.h"

#ifdef PPPOS
#include <PPP.h>
#define PPP_MODEM_APN "internet"
#define PPP_MODEM_PIN "0000" // or NULL
#define PPP_MODEM_RST_DELAY 500
#define PPP_MODEM_RST 13
#define PPP_MODEM_RST_LOW true // active LOW
#define PPP_MODEM_TX 12
#define PPP_MODEM_RX 11
#define PPP_MODEM_RTS -1
#define PPP_MODEM_CTS -1
#define PPP_MODEM_FC ESP_MODEM_FLOW_CONTROL_NONE
#define PPP_MODEM_MODEL PPP_MODEM_SIM800
#endif

#ifdef TTGO_TWR
#include <XPowersLib.h>
#define PMU_I2C_SDA (42)
#define PMU_I2C_SCL (41)
#define PMU_IRQ (40)
XPowersAXP2101 PMU;
#endif

#ifdef GUI_LCD
#include <gui_lcd.h>
#include <Adafruit_GFX.h>
#include <Adafruit_I2CDevice.h>

#define SCREEN_WIDTH 128 // OLED display width, in pixels
#define SCREEN_HEIGHT 64 // OLED display height, in pixels

// Declaration for an SSD1306 display connected to I2C (SDA, SCL pins)
#include <Adafruit_SH1106.h>
#define OLED_RESET -1
#define SCREEN_ADDRESS 0x3C ///< See datasheet for Address; 0x3D for 128x64, 0x3C for 128x32
Adafruit_SH1106 display(OLED_RESET);
TaskHandle_t mainDisplayHandle;
#endif

#define CONFIG_I2C_ENABLE_DEBUG_LOG 0
#define EEPROM_SIZE 4096

#if ESP_IDF_VERSION < ESP_IDF_VERSION_VAL(5, 2, 0)
#ifdef __XTENSA__
#define BOOT_PIN 9
#else
#define BOOT_PIN 0
#endif
#endif

#include <Wire.h>
#ifndef __XTENSA__
TwoWire Wire1 = TwoWire(1);
#endif
#ifdef OLED
#include <Adafruit_GFX.h>
#include <Adafruit_I2CDevice.h>

#if defined(SSD1306_72x40)
#define SCREEN_WIDTH 72  // OLED display width, in pixels
#define SCREEN_HEIGHT 40 // OLED display height, in pixels
#else
#define SCREEN_WIDTH 128 // OLED display width, in pixels
#define SCREEN_HEIGHT 64 // OLED display height, in pixels
#endif

// Declaration for an SSD1306 display connected to I2C (SDA, SCL pins)
#ifdef SH1106
#include <Adafruit_SH1106.h>
#define OLED_RESET -1
#define SCREEN_ADDRESS 0x3C ///< See datasheet for Address; 0x3D for 128x64, 0x3C for 128x32
Adafruit_SH1106 display(OLED_RESET);
#else
#include <Adafruit_SSD1306.h>
#define OLED_RESET -1
#ifdef SSD1306_72x40
#define SSD1306_NO_SPLASH
#define SCREEN_ADDRESS 0x3C
Adafruit_SSD1306 display(SCREEN_WIDTH, SCREEN_HEIGHT, &Wire, OLED_RESET);
#else
#define SCREEN_ADDRESS 0x3C //(0x3C for 32-pixel-tall displays, 0x3D for all others).
Adafruit_SSD1306 display(SCREEN_WIDTH, SCREEN_HEIGHT, &Wire, OLED_RESET);
#endif

#endif

#endif

#define FORMAT_LITTLEFS_IF_FAILED true
extern fs::LITTLEFSFS LITTLEFS;

bool i2c_busy = false;

struct pbuf_t aprs;
ParseAPRS aprsParse;

TinyGPSPlus gps;

// instantiate ModbusMaster object
ModbusMaster modbus;

// #ifdef __XTENSA__
// #define BOOT_PIN 0
// #else
// #define BOOT_PIN 9
// #endif

#define VBAT_PIN 35
// #define WIRE 4
//  #define POWER_PIN 12
//  #define PULLDOWN_PIN 27
//  #define SQL_PIN 33

// #define MODEM_PWRKEY 5
// #define MODEM_TX 17
// #define MODEM_RX 16
#include <Adafruit_NeoPixel.h>
Adafruit_NeoPixel *strip = NULL;

#ifdef STRIP_PIN
#define LED_TX -1
#define LED_RX -1
// portMUX_TYPE ledMux = portMUX_INITIALIZER_UNLOCKED;
void IRAM_ATTR LED_Status(uint8_t r, uint8_t g, uint8_t b)
{
    // portENTER_CRITICAL_ISR(&ledMux);          // ISR start
    strip->setPixelColor(0, strip->Color(r, g, b));
    strip->show();
    // portEXIT_CRITICAL_ISR(&ledMux);
}
#else
#define LED_TX 4
#define LED_RX 2
void LED_Status(uint8_t r, uint8_t g, uint8_t b)
{
    // portENTER_CRITICAL_ISR(&ledMux);          // ISR start
    if (LED_TX > -1)
    {
        if (r > 0)
            digitalWrite(LED_TX, HIGH);
        else
            digitalWrite(LED_TX, LOW);
    }
    if (LED_RX > -1)
    {
        if (g > 0)
            digitalWrite(LED_RX, HIGH);
        else
            digitalWrite(LED_RX, LOW);
    }
    // portEXIT_CRITICAL_ISR(&ledMux);
}
#endif

#define PPP_APN "internet"
#define PPP_USER ""
#define PPP_PASS ""

const char *str_status[] = {
    "IDLE_STATUS",
    "NO_SSID_AVAIL",
    "SCAN_COMPLETED",
    "CONNECTED",
    "CONNECT_FAILED",
    "CONNECTION_LOST",
    "DISCONNECTED"};

WiFiMulti wifiMulti;

time_t systemUptime = 0;
time_t wifiUptime = 0;

uint8_t Sleep_Activate = 0;
unsigned long StandByTick = 0;

bool lastHeard_Flag = 0;

boolean KISS = false;
bool aprsUpdate = false;

long timeSleep = 0;

boolean gotPacket = false;
AX25Msg incomingPacket;

bool lastPkg = false;
bool afskSync = false;
float dBV = 0;
int mVrms = 0;
float rssi = 0;
float snr = 0;
float freqErr = 0;

extern volatile int8_t adcEn;
extern volatile int8_t dacEn;
extern volatile bool pttOff;
extern volatile uint32_t adcIsrCount;
extern volatile int fifoSampleCount;
//extern volatile uint32_t frameDecodeCount;

long timeNetwork, timeAprs, timeGui;
long autoResetTimeout = 0;

// cppQueue PacketBuffer(sizeof(AX25Msg), 5, IMPLEMENTATION); // Instantiate queue
#ifdef OLED
cppQueue dispBuffer(300, 5, IMPLEMENTATION);
cppQueue queTxDisp(sizeof(txDisp), 5, IMPLEMENTATION); // Instantiate queue

void pushTxDisp(uint8_t ch, const char *name, char *info)
{
    if (!config.tx_display)
        return;

    txDisp pkg;

    pkg.tx_ch = ch;
    strcpy(pkg.name, name);
    strcpy(pkg.info, info);
    queTxDisp.push(&pkg); // ใส่แพ็จเก็จจาก TNC ลงคิวบัพเฟอร์
}
#endif

statusType status;
RTC_DATA_ATTR igateTLMType igateTLM;
RTC_DATA_ATTR dataTLMType systemTLM;
txQueueType *txQueue;

RTC_DATA_ATTR double LastLat, LastLng;
RTC_DATA_ATTR time_t lastTimeStamp;
RTC_DATA_ATTR uint32_t COUNTER0_RAW;
RTC_DATA_ATTR uint32_t COUNTER1_RAW;

extern RTC_DATA_ATTR uint8_t digiCount;

String RF_VERSION;

Configuration config;

pkgListType *pkgList;

TelemetryType *Telemetry;

RTC_DATA_ATTR double VBat;
RTC_DATA_ATTR bool VBat_Flag = false;
RTC_DATA_ATTR double TempNTC;

RTC_NOINIT_ATTR uint16_t TLM_SEQ;
RTC_NOINIT_ATTR uint16_t IGATE_TLM_SEQ;
RTC_NOINIT_ATTR uint16_t DIGI_TLM_SEQ;

TaskHandle_t taskNetworkHandle;
TaskHandle_t taskAPRSHandle;
TaskHandle_t taskAPRSPollHandle;
TaskHandle_t taskSerialHandle;
TaskHandle_t taskGPSHandle;
TaskHandle_t taskSensorHandle;

unsigned long timerNetwork, timerNetwork_old;
unsigned long timerAPRS, timerAPRS_old;
unsigned long timerGPS, timerGPS_old;
unsigned long timerSerial, timerSerial_old;

// SoftwareSerial SerialRF;
EspSoftwareSerial::UART SerialRF;

bool firstGpsTime = true;
time_t startTime = 0;

#ifdef BLUETOOTH
#if !defined(CONFIG_IDF_TARGET_ESP32)
#define CONFIG_BT_NIMBLE_MEM_ALLOC_MODE_EXTERNAL 1
#include <NuSerial.hpp>
#include <NimBLEDevice.h>
#else
#include "BluetoothSerial.h"
BluetoothSerial SerialBT;
#endif
#endif

// Set your Static IP address for wifi AP
IPAddress local_IP(192, 168, 4, 1);
IPAddress gateway(192, 168, 4, 254);
IPAddress subnet(255, 255, 255, 0);

IPAddress vpn_IP(192, 168, 44, 195);

int pkgTNC_count = 0;

xQueueHandle pcnt_evt_queue;              // A queue to handle pulse counter events
pcnt_isr_handle_t user_isr_handle = NULL; // user's ISR service handle

/* A sample structure to pass events from the PCNT
 * interrupt handler to the main program.
 */
typedef struct
{
    int unit;                // the PCNT unit that originated an interrupt
    uint32_t status;         // information on the event type that caused the interrupt
    unsigned long timeStamp; // The time the event occured
} pcnt_evt_t;

unsigned long upTimeStamp = 0;
void convertSecondsToDHMS(char *dmhs, unsigned long totalSeconds)
{
    // Calculate days, hours, minutes, and seconds
    unsigned int days = totalSeconds / 86400;           // 86400 seconds in a day
    unsigned int hours = (totalSeconds % 86400) / 3600; // 3600 seconds in an hour
    unsigned int minutes = (totalSeconds % 3600) / 60;  // 60 seconds in a minute
    unsigned int seconds = totalSeconds % 60;

    sprintf(dmhs, "%dD[%d:%d:%d]", days, hours, minutes, seconds);
    // Print the result in D:H:M:S format
    // Serial.print("Time: ");
    // Serial.print(days);
    // Serial.print("D ");
    // Serial.print(hours);
    // Serial.print("H ");
    // Serial.print(minutes);
    // Serial.print("M ");
    // Serial.print(seconds);
    // Serial.println("S");
}

#ifdef TTGO_TWR
void setupPower()
{
  bool result = false;
  int c = 0;
  while (result == false)
  {
    log_d("PMU is not online...");
    delay(500);
    result = PMU.begin(Wire, AXP2101_SLAVE_ADDRESS, config.i2c_sda_pin, config.i2c_sck_pin);
    if (result)
      break;
    c++;
    if (c > 10)
      return;
  }

  // Set the minimum common working voltage of the PMU VBUS input,
  // below this value will turn off the PMU
  PMU.setVbusVoltageLimit(XPOWERS_AXP2101_VBUS_VOL_LIM_3V88);

  // Set the maximum current of the PMU VBUS input,
  // higher than this value will turn off the PMU
  PMU.setVbusCurrentLimit(XPOWERS_AXP2101_VBUS_CUR_LIM_2000MA);

  // Get the VSYS shutdown voltage
  uint16_t vol = PMU.getSysPowerDownVoltage();
  log_d("->  getSysPowerDownVoltage:%u\n", vol);

  // Set VSY off voltage as 2600mV , Adjustment range 2600mV ~ 3300mV
  PMU.setSysPowerDownVoltage(2600);

  //! DC1 ESP32S3 Core VDD , Don't change
  // PMU.setDC1Voltage(3300);

  //! DC3 Radio & Pixels VDD , Don't change
  PMU.setDC3Voltage(3400);

  //! ALDO2 MICRO TF Card VDD, Don't change
  PMU.setALDO2Voltage(3300);

  //! ALDO4 GNSS VDD, Don't change
  PMU.setALDO4Voltage(3300);

  //! BLDO1 MIC VDD, Don't change
  PMU.setBLDO1Voltage(3300);

  //! The following supply voltages can be controlled by the user
  // DC5 IMAX=2A
  // 1200mV
  // 1400~3700mV,100mV/step,24steps
  PMU.setDC5Voltage(3500);

  // ALDO1 IMAX=300mA
  // 500~3500mV, 100mV/step,31steps
  PMU.setALDO1Voltage(3300);

  // ALDO3 IMAX=300mA
  // 500~3500mV, 100mV/step,31steps
  PMU.setALDO3Voltage(3300);

  // BLDO2 IMAX=300mA
  // 500~3500mV, 100mV/step,31steps
  PMU.setBLDO2Voltage(3300);

  //! END

  // Turn on the power that needs to be used
  //! DC1 ESP32S3 Core VDD , Don't change
  // PMU.enableDC3();

  //! External pin power supply
  PMU.enableDC5();
  PMU.enableALDO1();
  PMU.enableALDO3(); //AudioSwitchEn (V2.1)
  PMU.enableBLDO2();

  //! ALDO2 MICRO TF Card VDD
  PMU.enableALDO2();

  //! ALDO4 GNSS VDD
  PMU.enableALDO4();

  //! BLDO1 MIC VDD
  PMU.enableBLDO1();

  //! DC3 Radio & Pixels VDD
  PMU.enableDC3();

  // power off when not in use
  PMU.disableDC2();
  PMU.disableDC4();
  PMU.disableCPUSLDO();
  PMU.disableDLDO1(); //DownloadSwitchEn (V2.1)
  PMU.disableDLDO2();

  log_d("DCDC=======================================================================");
  log_d("DC1  : %s   Voltage:%u mV \n", PMU.isEnableDC1() ? "+" : "-", PMU.getDC1Voltage());
  log_d("DC2  : %s   Voltage:%u mV \n", PMU.isEnableDC2() ? "+" : "-", PMU.getDC2Voltage());
  log_d("DC3  : %s   Voltage:%u mV \n", PMU.isEnableDC3() ? "+" : "-", PMU.getDC3Voltage());
  log_d("DC4  : %s   Voltage:%u mV \n", PMU.isEnableDC4() ? "+" : "-", PMU.getDC4Voltage());
  log_d("DC5  : %s   Voltage:%u mV \n", PMU.isEnableDC5() ? "+" : "-", PMU.getDC5Voltage());
  log_d("ALDO=======================================================================");
  log_d("ALDO1: %s   Voltage:%u mV\n", PMU.isEnableALDO1() ? "+" : "-", PMU.getALDO1Voltage());
  log_d("ALDO2: %s   Voltage:%u mV\n", PMU.isEnableALDO2() ? "+" : "-", PMU.getALDO2Voltage());
  log_d("ALDO3: %s   Voltage:%u mV\n", PMU.isEnableALDO3() ? "+" : "-", PMU.getALDO3Voltage());
  log_d("ALDO4: %s   Voltage:%u mV\n", PMU.isEnableALDO4() ? "+" : "-", PMU.getALDO4Voltage());
  log_d("BLDO=======================================================================");
  log_d("BLDO1: %s   Voltage:%u mV\n", PMU.isEnableBLDO1() ? "+" : "-", PMU.getBLDO1Voltage());
  log_d("BLDO2: %s   Voltage:%u mV\n", PMU.isEnableBLDO2() ? "+" : "-", PMU.getBLDO2Voltage());
  log_d("===========================================================================");

  // Set the time of pressing the button to turn off
  PMU.setPowerKeyPressOffTime(XPOWERS_POWEROFF_4S);
  uint8_t opt = PMU.getPowerKeyPressOffTime();
  log_d("PowerKeyPressOffTime:");
  switch (opt)
  {
  case XPOWERS_POWEROFF_4S:
    log_d("4 Second");
    break;
  case XPOWERS_POWEROFF_6S:
    log_d("6 Second");
    break;
  case XPOWERS_POWEROFF_8S:
    log_d("8 Second");
    break;
  case XPOWERS_POWEROFF_10S:
    log_d("10 Second");
    break;
  default:
    break;
  }
  // Set the button power-on press time
  PMU.setPowerKeyPressOnTime(XPOWERS_POWERON_128MS);
  opt = PMU.getPowerKeyPressOnTime();
  log_d("PowerKeyPressOnTime:");
  switch (opt)
  {
  case XPOWERS_POWERON_128MS:
    log_d("128 Ms");
    break;
  case XPOWERS_POWERON_512MS:
    log_d("512 Ms");
    break;
  case XPOWERS_POWERON_1S:
    log_d("1 Second");
    break;
  case XPOWERS_POWERON_2S:
    log_d("2 Second");
    break;
  default:
    break;
  }

  log_d("===========================================================================");
  // It is necessary to disable the detection function of the TS pin on the board
  // without the battery temperature detection function, otherwise it will cause abnormal charging
  PMU.disableTSPinMeasure();

  // Enable internal ADC detection
  PMU.enableBattDetection();
  PMU.enableVbusVoltageMeasure();
  PMU.enableBattVoltageMeasure();
  PMU.enableSystemVoltageMeasure();

  /*
    The default setting is CHGLED is automatically controlled by the PMU.
  - XPOWERS_CHG_LED_OFF,
  - XPOWERS_CHG_LED_BLINK_1HZ,
  - XPOWERS_CHG_LED_BLINK_4HZ,
  - XPOWERS_CHG_LED_ON,
  - XPOWERS_CHG_LED_CTRL_CHG,
  * */
  PMU.setChargingLedMode(XPOWERS_CHG_LED_BLINK_1HZ);

  // Force add pull-up
  pinMode(PMU_IRQ, INPUT_PULLUP);
  // attachInterrupt(PMU_IRQ, setFlag, FALLING);

  // Disable all interrupts
  PMU.disableIRQ(XPOWERS_AXP2101_ALL_IRQ);
  // Clear all interrupt flags
  PMU.clearIrqStatus();
  // Enable the required interrupt function
  PMU.enableIRQ(
      XPOWERS_AXP2101_BAT_INSERT_IRQ | XPOWERS_AXP2101_BAT_REMOVE_IRQ |    // BATTERY
      XPOWERS_AXP2101_VBUS_INSERT_IRQ | XPOWERS_AXP2101_VBUS_REMOVE_IRQ |  // VBUS
      XPOWERS_AXP2101_PKEY_SHORT_IRQ | XPOWERS_AXP2101_PKEY_LONG_IRQ |     // POWER KEY
      XPOWERS_AXP2101_BAT_CHG_DONE_IRQ | XPOWERS_AXP2101_BAT_CHG_START_IRQ // CHARGE
  );

  // Set the precharge charging current
  PMU.setPrechargeCurr(XPOWERS_AXP2101_PRECHARGE_150MA);

  // Set constant current charge current limit
  //! Using inferior USB cables and adapters will not reach the maximum charging current.
  //! Please pay attention to add a suitable heat sink above the PMU when setting the charging current to 1A
  PMU.setChargerConstantCurr(XPOWERS_AXP2101_CHG_CUR_1000MA);

  // Set stop charging termination current
  PMU.setChargerTerminationCurr(XPOWERS_AXP2101_CHG_ITERM_150MA);

  // Set charge cut-off voltage
  PMU.setChargeTargetVoltage(XPOWERS_AXP2101_CHG_VOL_4V2);

  // Disable the PMU long press shutdown function
  // PMU.disableLongPressShutdown();
  PMU.enableLongPressShutdown();

  // Get charging target current
  const uint16_t currTable[] = {
      0, 0, 0, 0, 100, 125, 150, 175, 200, 300, 400, 500, 600, 700, 800, 900, 1000};
  uint8_t val = PMU.getChargerConstantCurr();
  log_d("Val = %d", val);
  log_d("Setting Charge Target Current : %d", currTable[val]);

  // Get charging target voltage
  const uint16_t tableVoltage[] = {
      0, 4000, 4100, 4200, 4350, 4400, 255};
  val = PMU.getChargeTargetVoltage();
  log_d("Setting Charge Target Voltage : %d", tableVoltage[val]);
}
#endif

/* Decode what PCNT's unit originated an interrupt
 * and pass this information together with the event type
 * and timestamp to the main program using a queue.
 */
// static void pcnt_intr_handler(void *arg)
// {
//     unsigned long currentMillis = millis(); // Time at instant ISR was called
//     uint32_t intr_status = 0xFFFF; //PCNT.int_st.val;
//     int i = 0;
//     pcnt_evt_t evt;
//     portBASE_TYPE HPTaskAwoken = pdFALSE;

//     for (i = 0; i < PCNT_UNIT_MAX; i++)
//     {
//         if (intr_status & (BIT(i)))
//         {
//             evt.unit = i;
//             /* Save the PCNT event type that caused an interrupt
//                to pass it to the main program */
//             evt.status = PCNT.status_unit[i].val;
//             evt.timeStamp = currentMillis;
//             PCNT.int_clr.val = BIT(i);
//             xQueueSendFromISR(pcnt_evt_queue, &evt, &HPTaskAwoken);
//             if (HPTaskAwoken == pdTRUE)
//             {
//                 portYIELD_FROM_ISR();
//             }
//         }
//     }
// }

/* Initialize PCNT functions for one channel:
 *  - configure and initialize PCNT with pos-edge counting
 *  - set up the input filter
 *  - set up the counter events to watch
 * Variables:
 * UNIT - Pulse Counter #, INPUT_SIG - Signal Input Pin, INPUT_CTRL - Control Input Pin,
 * Channel - Unit input channel, H_LIM - High Limit, L_LIM - Low Limit,
 * THRESH1 - configurable limit 1, THRESH0 - configurable limit 2,
 */
// void pcnt_init_channel(pcnt_unit_t PCNT_UNIT, int PCNT_INPUT_SIG_IO, bool ACTIVE = false, int PCNT_INPUT_CTRL_IO = PCNT_PIN_NOT_USED, pcnt_channel_t PCNT_CHANNEL = PCNT_CHANNEL_0, int PCNT_H_LIM_VAL = 65535, int PCNT_L_LIM_VAL = 0, int PCNT_THRESH1_VAL = 50, int PCNT_THRESH0_VAL = -50)
// {
//     /* Prepare configuration for the PCNT unit */
//     pcnt_config_t pcnt_config;
//     // Set PCNT input signal and control GPIOs
//     pcnt_config.pulse_gpio_num = PCNT_INPUT_SIG_IO;
//     pcnt_config.ctrl_gpio_num = PCNT_INPUT_CTRL_IO;
//     pcnt_config.channel = PCNT_CHANNEL;
//     pcnt_config.unit = PCNT_UNIT;
//     // What to do on the positive / negative edge of pulse input?
//     if (ACTIVE)
//     {
//         pcnt_config.pos_mode = PCNT_COUNT_INC; // Count up on the positive edge
//         pcnt_config.neg_mode = PCNT_COUNT_DIS; // Keep the counter value on the negative edge
//     }
//     else
//     {
//         pcnt_config.neg_mode = PCNT_COUNT_INC; // Count up on the positive edge
//         pcnt_config.pos_mode = PCNT_COUNT_DIS; // Keep the counter value on the negative edge
//     }
//     // What to do when control input is low or high?
//     pcnt_config.lctrl_mode = PCNT_MODE_REVERSE; // Reverse counting direction if low
//     pcnt_config.hctrl_mode = PCNT_MODE_KEEP;    // Keep the primary counter mode if high
//     // Set the maximum and minimum limit values to watch
//     pcnt_config.counter_h_lim = PCNT_H_LIM_VAL;
//     pcnt_config.counter_l_lim = PCNT_L_LIM_VAL;

//     /* Initialize PCNT unit */
//     pcnt_unit_config(&pcnt_config);
//     /* Configure and enable the input filter */
//     // pcnt_set_filter_value(PCNT_UNIT, 100);
//     // pcnt_filter_enable(PCNT_UNIT);

//     /* Set threshold 0 and 1 values and enable events to watch */
//     // pcnt_set_event_value(PCNT_UNIT, PCNT_EVT_THRES_1, PCNT_THRESH1_VAL);
//     // pcnt_event_enable(PCNT_UNIT, PCNT_EVT_THRES_1);
//     // pcnt_set_event_value(PCNT_UNIT, PCNT_EVT_THRES_0, PCNT_THRESH0_VAL);
//     // pcnt_event_enable(PCNT_UNIT, PCNT_EVT_THRES_0);
//     /* Enable events on zero, maximum and minimum limit values */
//     pcnt_event_enable(PCNT_UNIT, PCNT_EVT_ZERO);
//     pcnt_event_enable(PCNT_UNIT, PCNT_EVT_H_LIM);

//     /* Initialize PCNT's counter */
//     pcnt_counter_pause(PCNT_UNIT);
//     pcnt_counter_clear(PCNT_UNIT);
//     /* Register ISR handler and enable interrupts for PCNT unit */
//     // pcnt_isr_register(pcnt_intr_handler, NULL, 0, &user_isr_handle);
//     // pcnt_intr_enable(PCNT_UNIT);

//     /* Everything is set up, now go to counting */
//     pcnt_counter_resume(PCNT_UNIT);
//     // pcnt_counter_resume(PCNT_UNIT_1);
// }

/* Count RPM Function - takes first timestamp and last timestamp,
number of pulses, and pulses per revolution */
// int countRPM(int firstTime, int lastTime, int pulseTotal, int pulsePerRev)
// {
//     int timeDelta = (lastTime - firstTime); // lastTime - firstTime
//     if (timeDelta <= 0)
//     { // This means we've gotten something wrong
//         return -1;
//     }
//     return ((60000 * (pulseTotal / pulsePerRev)) / timeDelta);
// }

char EVENT_TX_POSITION = 0;
unsigned char SB_SPEED = 0, SB_SPEED_OLD = 0;
int16_t SB_HEADING = 0;
uint16_t tx_interval = 0, igate_tx_interval, digi_tx_interval; // How often we transmit, in seconds
unsigned int tx_counter, igate_tx_counter, digi_tx_counter;    // Incremented every second
int16_t last_heading, heading_change;                          // Keep track of corner pegging
uint16_t trk_interval = 15;

void smartbeacon(void)
{
    // Adaptive beacon rate
    if (SB_SPEED >= config.trk_hspeed)
    {
        tx_interval = (uint16_t)config.trk_maxinterval;
    }
    else
    {
        if (SB_SPEED <= config.trk_lspeed)
        {
            // Speed is below lower limit - use minimum rate
            tx_interval = (uint16_t)config.trk_slowinterval;
        }
        else
        {
            // In between, do SmartBeaconing calculations
            if (SB_SPEED <= 0)
                SB_SPEED = 1;
            tx_interval = (trk_interval * config.trk_hspeed) / SB_SPEED;
            if (tx_interval < 5)
                tx_interval = 5;
            if (tx_interval > config.trk_maxinterval)
                tx_interval = (uint16_t)config.trk_maxinterval;

            // Corner pegging - note that we use two-degree units
            if (last_heading > SB_HEADING)
                heading_change = last_heading - SB_HEADING;
            else
                heading_change = SB_HEADING - last_heading;
            if (heading_change > 90)
                heading_change = 180 - heading_change;
            if (heading_change > config.trk_minangle)
            {
                // Make sure last heading is updated during turns to avoid immedate xmit
                if ((tx_counter > config.trk_mininterval) && (SB_SPEED > 1))
                {
                    EVENT_TX_POSITION = 3;
                }
                else
                {
                    // last_heading = SB_HEADING;
                    tx_interval = config.trk_mininterval;
                }
            }
        }
    }
}

// (2^31 / 180) / 380926 semicircles per Base 91 unit
static unsigned long b91val[4] = {23601572L, 259358L, 2851L, 32L};
// Constants for converting lat/lon to semicircles
static long valtable[] = {1193046471L, 119304647L, 11930465L, 1988411L, 198841L, 19884L, 1988L, 199L, 20L, 2L};

// Takes degrees and fractional minutes and returns 2^31/180 degrees
// West and South values are negative
long semicircles(char *degstr, char hemi)
{
    char dgt = 0, *p;
    long ltemp = 0;
    if (degstr[4] == '.')
        dgt++; // Skip hundreds place if we know we're doing latitude
    p = degstr;
    for (; dgt < 10; p++)
    {
        if (*p == '.')
            continue;
        if (!isdigit(*p))
            break;
        ltemp += (*p & 0x0f) * valtable[dgt];
        dgt++;
    }
    if (hemi)
        return -ltemp;
    return ltemp;
}

// Converts semicircles to Base 91 units (must be properly biased first)
// Non-reentrant use of ltemp, but we only call this function in one place
void base91encode(long ltemp, char *s)
{
    // (2^31 / 180) / 380926 semicircles per Base 91 unit
    unsigned char c;

    for (c = 0; c < 4; c++)
    {
        s[c] = '!';
        while (ltemp >= b91val[c])
        {
            // reset_watchdog;
            ltemp -= b91val[c];
            s[c]++;
        }
    }
}

void telemetry_base91(char *cdata, char *output, size_t outputsize)
{
    int x, d1, d2;
    int i = 0;
    // Returns first token
    char *token = strtok(cdata, ",");
    output[i++] = '|';
    // Keep printing tokens while one of the
    // delimiters present in str[].
    while (token != NULL)
    {
        // printf(" % s\n", token);
        x = atoi(token);
        if (x > 8280)
            x = 8280;
        if (x < 0)
            x = 0;
        d1 = int(x / 91);
        d2 = x % 91;
        output[i++] = d1 + 33;
        output[i++] = d2 + 33;
        token = strtok(NULL, ",");
    }
    output[i++] = '|';
    outputsize = i;
}

/// Degrees to radians.
#define DEG2RAD(x) (x / 360 * 2 * PI)
/// Radians to degrees.
#define RAD2DEG(x) (x * (180 / PI))

double direction(double lon0, double lat0, double lon1, double lat1)
{
    double direction;

    /* Convert degrees into radians. */
    lon0 = DEG2RAD(lon0);
    lat0 = DEG2RAD(lat0);
    lon1 = DEG2RAD(lon1);
    lat1 = DEG2RAD(lat1);

    /* Direction from Aviation Formulary V1.42 by Ed Williams by way of
     * http://mathforum.org/library/drmath/view/55417.html */
    direction = atan2(sin(lon1 - lon0) * cos(lat1), cos(lat0) * sin(lat1) - sin(lat0) * cos(lat1) * cos(lon1 - lon0));
    if (direction < 0)
    {
        /* Make direction positive. */
        direction += 2 * PI;
    }

    return RAD2DEG(direction);
}

double distance(double lon0, double lat0, double lon1, double lat1)
{
    double dlon;
    double dlat;
    double a, c;
    /* Convert degrees into radians. */
    lon0 = DEG2RAD(lon0);
    lat0 = DEG2RAD(lat0);
    lon1 = DEG2RAD(lon1);
    lat1 = DEG2RAD(lat1);

    /* Use the haversine formula for distance calculation
     * http://mathforum.org/library/drmath/view/51879.html */
    dlon = lon1 - lon0;
    dlat = lat1 - lat0;
    a = pow(sin(dlat / 2), 2) + cos(lat0) * cos(lat1) * pow(sin(dlon / 2), 2);
    c = 2 * atan2(sqrt(a), sqrt(1 - a));

    return c * 6366.71; /* in kilometers */
}

void deg2lat(char *dmm, double deg)
{
    char sign;
    if (deg > 0.0F)
    {
        sign = 'N';
    }
    else
    {
        sign = 'S';
        deg *= -1;
    }

    uint id = (uint)floor(deg);
    uint im = (uint)((deg - (double)id) * 60);
    uint imm = (uint)round((((deg - (double)id) * 60) - (double)im) * 100);
    sprintf(dmm, "%02d%02d.%02d%c", id, im, imm, sign);
}

void deg2lon(char *dmm, double deg)
{
    char sign;
    if (deg > 0.0F)
    {
        sign = 'E';
    }
    else
    {
        sign = 'W';
        deg *= -1;
    }
    uint id = (uint)floor(deg);
    uint im = (uint)((deg - (double)id) * 60);
    uint imm = (uint)round((((deg - (double)id) * 60) - (double)im) * 100);
    sprintf(dmm, "%03d%02d.%02d%c", id, im, imm, sign);
}

String deg2lat(double deg)
{
    char sign;
    if (deg > 0.0F)
    {
        sign = 'N';
    }
    else
    {
        sign = 'S';
        deg *= -1;
    }

    uint id = (uint)floor(deg);
    uint im = (uint)((deg - (double)id) * 60);
    uint imm = (uint)round((((deg - (double)id) * 60) - (double)im) * 100);
    char dmm[10];
    sprintf(dmm, "%02d%02d.%02d%c", id, im, imm, sign);
    return String(dmm);
}

String deg2lon(double deg)
{
    char sign;
    if (deg > 0.0F)
    {
        sign = 'E';
    }
    else
    {
        sign = 'W';
        deg *= -1;
    }
    uint id = (uint)floor(deg);
    uint im = (uint)((deg - (double)id) * 60);
    uint imm = (uint)round((((deg - (double)id) * 60) - (double)im) * 100);
    char dmm[10];
    sprintf(dmm, "%03d%02d.%02d%c", id, im, imm, sign);
    return String(dmm);
}

time_t setGpsTime()
{
    time_t time;
    tmElements_t timeinfo;
    if (gps.time.isValid())
    {
        timeinfo.Year = (gps.date.year()) - 1970;
        timeinfo.Month = gps.date.month();
        timeinfo.Day = gps.date.day();
        timeinfo.Hour = gps.time.hour();
        timeinfo.Minute = gps.time.minute();
        timeinfo.Second = gps.time.second();
        time_t timeStamp = makeTime(timeinfo);
        time = timeStamp + config.timeZone * SECS_PER_HOUR;
        setTime(time);
        // setTime(timeinfo.Hour,timeinfo.Minute,timeinfo.Second,timeinfo.Day, timeinfo.Month, timeinfo.Year);
        return time;
    }
    return 0;
}

time_t getGpsTime()
{
    time_t time;
    tmElements_t timeinfo;
    if (gps.time.isValid())
    {
        timeinfo.Year = (gps.date.year()) - 1970;
        timeinfo.Month = gps.date.month();
        timeinfo.Day = gps.date.day();
        timeinfo.Hour = gps.time.hour();
        timeinfo.Minute = gps.time.minute();
        timeinfo.Second = gps.time.second();
        time_t timeStamp = makeTime(timeinfo);
        time = timeStamp + config.timeZone * SECS_PER_HOUR;
        return time;
    }
    return 0;
}

String getValue(String data, char separator, int index)
{
    int found = 0;
    int strIndex[] = {0, -1};
    int maxIndex = data.length();

    for (int i = 0; i <= maxIndex && found <= index; i++)
    {
        if (data.charAt(i) == separator || i == maxIndex)
        {
            found++;
            strIndex[0] = strIndex[1] + 1;
            strIndex[1] = (i == maxIndex) ? i + 1 : i;
        }
    }
    return found > index ? data.substring(strIndex[0], strIndex[1]) : "";
} // END

boolean isValidNumber(String str)
{
    for (int i = 0; i < str.length(); i++)
    {
        if (isDigit(str.charAt(i)))
            return true;
    }
    return false;
}

uint8_t checkSum(uint8_t *ptr, size_t count)
{
    uint8_t lrc, tmp;
    uint16_t i;
    lrc = 0;
    for (i = 0; i < count; i++)
    {
        tmp = *ptr++;
        lrc = lrc ^ tmp;
    }
    return lrc;
}

// void saveEEPROM()
// {
//     uint8_t chkSum = 0;
//     byte *ptr;
//     ptr = (byte *)&config;
//     EEPROM.writeBytes(1, ptr, sizeof(Configuration));
//     chkSum = checkSum(ptr, sizeof(Configuration));
//     EEPROM.write(0, chkSum);
//     EEPROM.commit();
// #ifdef DEBUG
//     Serial.print("Save EEPROM ChkSUM=");
//     Serial.println(chkSum, HEX);
// #endif
// }
#ifdef LOG_FILE
void logTracker(double lat, double lon, double speed, double course)
{
    char data[200];
    char datetime[30];
    char dfName[30];
    bool header = false;
    double dist;
    time_t nowTime;

    if (gps.time.isValid())
    {
        time_t timeGps = getGpsTime(); // Local gps time
        time(&nowTime);
        int tdiff = abs(timeGps - nowTime);
        if (timeGps > 1700000000 && tdiff > 2) // && timeGps < 2347462800)
        {
            nowTime = timeGps;
            setTime(nowTime);
            time_t rtc = nowTime - (time_t)(config.timeZone * (float)SECS_PER_HOUR);
            timeval tv = {rtc, 0};
            timezone tz = {(int)(config.timeZone * (float)SECS_PER_HOUR), 0};
            settimeofday(&tv, &tz);
        }
    }
    else
    {
        time(&nowTime);
    }

    String col;
    struct tm tmstruct;
    getLocalTime(&tmstruct, 100);
    sprintf(dfName, "/trk_%02d%d.csv", (tmstruct.tm_mon) + 1, (tmstruct.tm_year) + 1900);

    if (lastTimeStamp == 0)
        lastTimeStamp = nowTime;
    time_t tdiff = nowTime - lastTimeStamp;
    double nowLat = gps.location.lat();
    double nowLng = gps.location.lng();
    double spd = gps.speed.kmph();

    // dist = distance(LastLng, LastLat, nowLng, nowLat);

    if (spd < 5)
    {

        dist = gps.distanceBetween(LastLng, LastLat, nowLng, nowLat);
        course = direction(LastLng, LastLat, nowLng, nowLat);
        if (dist > 50.0F)
            dist = 0;
        if (tdiff > 10 && (nowTime > lastTimeStamp))
            speed = dist / ((double)tdiff / 3600);
        else
            speed = 0.0F;

        if (speed > 5)
        {
            speed = gps.speed.kmph();
            course = gps.course.deg();
        }
    }
    LastLat = nowLat;
    LastLng = nowLng;
    lastTimeStamp = nowTime;
    // if (!waterTempFlag)
    // 		{
    // ds18b20.setWaitForConversion(false); // makes it async
    // ds18b20.requestTemperatures();
    // ds18b20.setWaitForConversion(true);
    // waterTemperature = ds18b20.getTempCByIndex(0);
    // if (waterTemperature > 0)
    // 	waterTempFlag = true;
    //}

    if (!LITTLEFS.exists(dfName))
    {
        header = true;
    }

    File f = LITTLEFS.open(dfName, "a");
#ifdef DEBUG
    log_d("====== Writing to data file =========");
    log_d("Open File %s", dfName);
#endif
    if (!f)
    {
#ifdef DEBUG
        log_d("Data file open failed");
#endif
    }
    else
    {
        if (header)
        {
            // col = "\"dd/mm/yyyy h:m\",\"Weight Origin(Kg)\",\"Weight(Kg)\",\"Water Drain(L)\",\"Water Height(mm)\",\"Temperature(C)\",\"Raw\"";
            col = "dd/mm/yyyy h:m:s";
            col += ",Latitude";
            col += ",Longitude";
            col += ",Speed(kph)";
            col += ",Course(°)";
            for (int i = 0; i < 5; i++)
            {
                if (config.trk_tlm_sensor[i] > 0)
                {
                    col += "," + String(config.trk_tlm_PARM[i]) + "(" + String(config.trk_tlm_UNIT[i]) + ")";
                }
            }
            f.println(col);
        }
        sprintf(datetime, "%d-%02d-%02d %02d:%02d:%02d", (tmstruct.tm_year) + 1900, (tmstruct.tm_mon) + 1, tmstruct.tm_mday, tmstruct.tm_hour, tmstruct.tm_min, tmstruct.tm_sec);
        sprintf(data, "%s,%0.5f,%0.5f,%0.2f,%d", datetime, lat, lon, speed, (int)course);
        for (int s = 0; s < 5; s++)
        {
            if (config.trk_tlm_sensor[s] == 0)
            {
                continue;
                // strcat(tlm_data, "0");
            }
            else
            {
                strcat(data, ",");
                int sen_idx = config.trk_tlm_sensor[s] - 1;
                double val = 0;
                if (sen[sen_idx].visable)
                {
                    if (config.trk_tlm_avg[s] && (sen[sen_idx].timeAvg > 0))
                        val = sen[sen_idx].average;
                    else
                        val = sen[sen_idx].sample;
                }
                strcat(data, String(val, 2).c_str());
            }
        }
        f.println(data);
        f.close();
#ifdef DEBUG
        log_d("Data file updated");
#endif
    }
}

void logIGate(double lat, double lon, double speed, double course)
{
    char data[200];
    char datetime[30];
    char dfName[30];
    bool header = false;
    double dist;
    time_t nowTime;

    if (gps.time.isValid())
    {
        time_t timeGps = getGpsTime(); // Local gps time
        time(&nowTime);
        int tdiff = abs(timeGps - nowTime);
        if (timeGps > 1700000000 && tdiff > 2) // && timeGps < 2347462800)
        {
            nowTime = timeGps;
            setTime(nowTime);
            time_t rtc = nowTime - (time_t)(config.timeZone * (float)SECS_PER_HOUR);
            timeval tv = {rtc, 0};
            timezone tz = {(int)(config.timeZone * (float)SECS_PER_HOUR), 0};
            settimeofday(&tv, &tz);
        }
    }
    else
    {
        time(&nowTime);
    }

    String col;
    struct tm tmstruct;
    getLocalTime(&tmstruct, 100);
    sprintf(dfName, "/igate_%02d%d.csv", (tmstruct.tm_mon) + 1, (tmstruct.tm_year) + 1900);

    if (lastTimeStamp == 0)
        lastTimeStamp = nowTime;
    time_t tdiff = nowTime - lastTimeStamp;
    double nowLat = gps.location.lat();
    double nowLng = gps.location.lng();
    double spd = gps.speed.kmph();

    // dist = distance(LastLng, LastLat, nowLng, nowLat);

    if (spd < 5)
    {

        dist = gps.distanceBetween(LastLng, LastLat, nowLng, nowLat);
        course = direction(LastLng, LastLat, nowLng, nowLat);
        if (dist > 50.0F)
            dist = 0;
        if (tdiff > 10 && (nowTime > lastTimeStamp))
            speed = dist / ((double)tdiff / 3600);
        else
            speed = 0.0F;

        if (speed > 5)
        {
            speed = gps.speed.kmph();
            course = gps.course.deg();
        }
    }
    LastLat = nowLat;
    LastLng = nowLng;
    lastTimeStamp = nowTime;

    if (!LITTLEFS.exists(dfName))
    {
        header = true;
    }

    File f = LITTLEFS.open(dfName, "a");
#ifdef DEBUG
    log_d("====== Writing to data file =========");
    log_d("Open File %s", dfName);
#endif
    if (!f)
    {
#ifdef DEBUG
        log_d("Data file open failed");
#endif
    }
    else
    {
        if (header)
        {
            // col = "\"dd/mm/yyyy h:m\",\"Weight Origin(Kg)\",\"Weight(Kg)\",\"Water Drain(L)\",\"Water Height(mm)\",\"Temperature(C)\",\"Raw\"";
            col = "dd/mm/yyyy h:m:s";
            col += ",Latitude";
            col += ",Longitude";
            col += ",Speed(kph)";
            col += ",Course(°)";
            for (int i = 0; i < 5; i++)
            {
                if (config.igate_tlm_sensor[i] > 0)
                {
                    col += "," + String(config.igate_tlm_PARM[i]) + "(" + String(config.igate_tlm_UNIT[i]) + ")";
                }
            }
            f.println(col);
        }
        sprintf(datetime, "%d-%02d-%02d %02d:%02d:%02d", (tmstruct.tm_year) + 1900, (tmstruct.tm_mon) + 1, tmstruct.tm_mday, tmstruct.tm_hour, tmstruct.tm_min, tmstruct.tm_sec);
        sprintf(data, "%s,%0.5f,%0.5f,%0.2f,%d", datetime, lat, lon, speed, (int)course);
        for (int s = 0; s < 5; s++)
        {
            if (config.igate_tlm_sensor[s] == 0)
            {
                continue;
                // strcat(tlm_data, "0");
            }
            else
            {
                strcat(data, ",");
                int sen_idx = config.igate_tlm_sensor[s] - 1;
                double val = 0;
                if (sen[sen_idx].visable)
                {
                    if (config.igate_tlm_avg[s] && (sen[sen_idx].timeAvg > 0))
                        val = sen[sen_idx].average;
                    else
                        val = sen[sen_idx].sample;
                }
                strcat(data, String(val, 2).c_str());
            }
        }
        f.println(data);
        f.close();
#ifdef DEBUG
        log_d("Data file updated");
#endif
    }
}

void logDigi(double lat, double lon, double speed, double course)
{
    char data[200];
    char datetime[30];
    char dfName[30];
    bool header = false;
    double dist;
    time_t nowTime;

    if (gps.time.isValid())
    {
        time_t timeGps = getGpsTime(); // Local gps time
        time(&nowTime);
        int tdiff = abs(timeGps - nowTime);
        if (timeGps > 1700000000 && tdiff > 2) // && timeGps < 2347462800)
        {
            nowTime = timeGps;
            setTime(nowTime);
            time_t rtc = nowTime - (time_t)(config.timeZone * (float)SECS_PER_HOUR);
            timeval tv = {rtc, 0};
            timezone tz = {(int)(config.timeZone * (float)SECS_PER_HOUR), 0};
            settimeofday(&tv, &tz);
        }
    }
    else
    {
        time(&nowTime);
    }

    String col;
    struct tm tmstruct;
    getLocalTime(&tmstruct, 100);
    sprintf(dfName, "/digi_%02d%d.csv", (tmstruct.tm_mon) + 1, (tmstruct.tm_year) + 1900);

    if (lastTimeStamp == 0)
        lastTimeStamp = nowTime;
    time_t tdiff = nowTime - lastTimeStamp;
    double nowLat = gps.location.lat();
    double nowLng = gps.location.lng();
    double spd = gps.speed.kmph();

    // dist = distance(LastLng, LastLat, nowLng, nowLat);

    if (spd < 5)
    {

        dist = gps.distanceBetween(LastLng, LastLat, nowLng, nowLat);
        course = direction(LastLng, LastLat, nowLng, nowLat);
        if (dist > 50.0F)
            dist = 0;
        if (tdiff > 10 && (nowTime > lastTimeStamp))
            speed = dist / ((double)tdiff / 3600);
        else
            speed = 0.0F;

        if (speed > 5)
        {
            speed = gps.speed.kmph();
            course = gps.course.deg();
        }
    }
    LastLat = nowLat;
    LastLng = nowLng;
    lastTimeStamp = nowTime;

    if (!LITTLEFS.exists(dfName))
    {
        header = true;
    }

    File f = LITTLEFS.open(dfName, "a");
#ifdef DEBUG
    log_d("====== Writing to data file =========");
    log_d("Open File %s", dfName);
#endif
    if (!f)
    {
#ifdef DEBUG
        log_d("Data file open failed");
#endif
    }
    else
    {
        if (header)
        {
            // col = "\"dd/mm/yyyy h:m\",\"Weight Origin(Kg)\",\"Weight(Kg)\",\"Water Drain(L)\",\"Water Height(mm)\",\"Temperature(C)\",\"Raw\"";
            col = "dd/mm/yyyy h:m:s";
            col += ",Latitude";
            col += ",Longitude";
            col += ",Speed(kph)";
            col += ",Course(°)";
            for (int i = 0; i < 5; i++)
            {
                if (config.digi_tlm_sensor[i] > 0)
                {
                    col += "," + String(config.digi_tlm_PARM[i]) + "(" + String(config.digi_tlm_UNIT[i]) + ")";
                }
            }
            f.println(col);
        }
        sprintf(datetime, "%d-%02d-%02d %02d:%02d:%02d", (tmstruct.tm_year) + 1900, (tmstruct.tm_mon) + 1, tmstruct.tm_mday, tmstruct.tm_hour, tmstruct.tm_min, tmstruct.tm_sec);
        sprintf(data, "%s,%0.5f,%0.5f,%0.2f,%d", datetime, lat, lon, speed, (int)course);
        for (int s = 0; s < 5; s++)
        {
            if (config.digi_tlm_sensor[s] == 0)
            {
                continue;
                // strcat(tlm_data, "0");
            }
            else
            {
                strcat(data, ",");
                int sen_idx = config.digi_tlm_sensor[s] - 1;
                double val = 0;
                if (sen[sen_idx].visable)
                {
                    if (config.digi_tlm_avg[s] && (sen[sen_idx].timeAvg > 0))
                        val = sen[sen_idx].average;
                    else
                        val = sen[sen_idx].sample;
                }
                strcat(data, String(val, 2).c_str());
            }
        }
        f.println(data);
        f.close();
#ifdef DEBUG
        log_d("Data file updated");
#endif
    }
}

void logWeather(double lat, double lon, double speed, double course)
{
    char data[500];
    char datetime[30];
    char dfName[30];
    bool header = false;
    double dist;
    time_t nowTime;

    if (gps.time.isValid())
    {
        time_t timeGps = getGpsTime(); // Local gps time
        time(&nowTime);
        int tdiff = abs(timeGps - nowTime);
        if (timeGps > 1700000000 && tdiff > 2) // && timeGps < 2347462800)
        {
            nowTime = timeGps;
            setTime(nowTime);
            time_t rtc = nowTime - (time_t)(config.timeZone * (float)SECS_PER_HOUR);
            timeval tv = {rtc, 0};
            timezone tz = {(int)(config.timeZone * (float)SECS_PER_HOUR), 0};
            settimeofday(&tv, &tz);
        }
    }
    else
    {
        time(&nowTime);
    }

    String col;
    struct tm tmstruct;
    getLocalTime(&tmstruct, 100);
    sprintf(dfName, "/wx_%02d%d.csv", (tmstruct.tm_mon) + 1, (tmstruct.tm_year) + 1900);

    if (lastTimeStamp == 0)
        lastTimeStamp = nowTime;
    time_t tdiff = nowTime - lastTimeStamp;
    double nowLat = gps.location.lat();
    double nowLng = gps.location.lng();
    double spd = gps.speed.kmph();

    // dist = distance(LastLng, LastLat, nowLng, nowLat);

    if (spd < 5)
    {

        dist = gps.distanceBetween(LastLng, LastLat, nowLng, nowLat);
        course = direction(LastLng, LastLat, nowLng, nowLat);
        if (dist > 50.0F)
            dist = 0;
        if (tdiff > 10 && (nowTime > lastTimeStamp))
            speed = dist / ((double)tdiff / 3600);
        else
            speed = 0.0F;

        if (speed > 5)
        {
            speed = gps.speed.kmph();
            course = gps.course.deg();
        }
    }
    LastLat = nowLat;
    LastLng = nowLng;
    lastTimeStamp = nowTime;

    if (!LITTLEFS.exists(dfName))
    {
        header = true;
    }

    File f = LITTLEFS.open(dfName, "a");
#ifdef DEBUG
    log_d("====== Writing to data file =========");
    log_d("Open File %s", dfName);
#endif
    if (!f)
    {
#ifdef DEBUG
        log_d("Data file open failed");
#endif
    }
    else
    {
        if (header)
        {
            // col = "\"dd/mm/yyyy h:m\",\"Weight Origin(Kg)\",\"Weight(Kg)\",\"Water Drain(L)\",\"Water Height(mm)\",\"Temperature(C)\",\"Raw\"";
            col = "dd/mm/yyyy h:m:s";
            col += ",Latitude";
            col += ",Longitude";
            col += ",Speed(kph)";
            col += ",Course(°)";
            for (int s = 0; s < WX_SENSOR_NUM; s++)
            {
                int senIdx = config.wx_sensor_ch[s];
                if ((config.wx_sensor_enable[s] == 0) || (senIdx == 0))
                {
                    continue;
                }
                else
                {
                    senIdx -= 1;
                    col += "," + String(String(WX_SENSOR[s])) + "(" + String(config.sensor[senIdx].unit) + ")";
                }
            }
            f.println(col);
        }
        sprintf(datetime, "%d-%02d-%02d %02d:%02d:%02d", (tmstruct.tm_year) + 1900, (tmstruct.tm_mon) + 1, tmstruct.tm_mday, tmstruct.tm_hour, tmstruct.tm_min, tmstruct.tm_sec);
        sprintf(data, "%s,%0.5f,%0.5f,%0.2f,%d", datetime, lat, lon, speed, (int)course);
        for (int s = 0; s < WX_SENSOR_NUM; s++)
        {
            int senIdx = config.wx_sensor_ch[s];
            if ((config.wx_sensor_enable[s] == 0) || (senIdx == 0))
            {
                continue;
            }
            else
            {
                strcat(data, ",");
                senIdx -= 1;
                double val = 0;
                if (sen[senIdx].visable)
                {
                    if ((config.wx_sensor_avg[s] && (config.sensor[senIdx].averagerate <= config.sensor[senIdx].samplerate)) || (sen[senIdx].timeAvg == 0))
                        val = sen[senIdx].sample;
                    else
                        val = sen[senIdx].average;
                }
                strcat(data, String(val, 2).c_str());
            }
        }
        f.println(data);
        f.close();
#ifdef DEBUG
        log_d("Data file updated");
#endif
    }
}
#endif

void defaultConfig()
{
    log_d("Default configure mode!");
    #ifdef __XTENSA__
    config.cpuFreq = 240;
    #else
    config.cpuFreq = 160;
    #endif
    config.synctime = true;
    config.timeZone = 7;
    config.tx_timeslot = 2000; // ms

    config.wifi_mode = WIFI_AP_STA_FIX;
    config.wifi_power = 74; // WIFI_POWER_18.5dBm
    config.wifi_ap_ch = 6;
    config.wifi_sta[0].enable = true;
    sprintf(config.wifi_sta[0].wifi_ssid, "APRSTH");
    sprintf(config.wifi_sta[0].wifi_pass, "aprsthnetwork");
    for (int i = 1; i < 5; i++)
    {
        config.wifi_sta[i].enable = false;
        config.wifi_sta[i].wifi_ssid[0] = 0;
        config.wifi_sta[i].wifi_pass[0] = 0;
    }
    sprintf(config.wifi_ap_ssid, "ESP32APRS_Audio");
    sprintf(config.wifi_ap_pass, "aprsthnetwork");

    // Blutooth
    config.bt_slave = false;
    config.bt_master = false;
    config.bt_mode = 1; // 0-None,1-TNC2RAW,2-KISS
    config.bt_power = 3;
    sprintf(config.bt_name, "ESP32APRS_Audio");
    config.bt_pin = 0;
#if !defined(CONFIG_IDF_TARGET_ESP32)
    // Bluetooth BLE
    sprintf(config.bt_uuid, "00000001-ba2a-46c9-ae49-01b0961f68bb");
    sprintf(config.bt_uuid_rx, "00000002-ba2a-46c9-ae49-01b0961f68bb");
    sprintf(config.bt_uuid_tx, "00000003-ba2a-46c9-ae49-01b0961f68bb");
#endif

    //--RF Module
    config.rf_en = false;
    config.rf_type = RF_SA868_VHF;
    config.freq_rx = 144.3900;
    config.freq_tx = 144.3900;
    config.offset_rx = 0;
    config.offset_tx = 0;
    config.tone_rx = 0;
    config.tone_tx = 0;
    config.band = 0;
    config.sql_level = 1;
    config.rf_power = LOW;
    config.volume = 6;
    config.mic = 8;
    config.modem_type = 1;

    config.adc_atten = 0;

#ifdef ESP32C3_MINI
    config.rf_tx_gpio = -1;
    config.rf_rx_gpio = -1;
    config.rf_sql_gpio = -1;
    config.rf_pd_gpio = -1;
    config.rf_pwr_gpio = -1;
    config.rf_ptt_gpio = 3;
    config.rf_sql_active = 0;
    config.rf_pd_active = 1;
    config.rf_pwr_active = 1;
    config.rf_ptt_active = 0;
#elif defined(TTGO_TWR)
    config.rf_en = true;
    config.rf_tx_gpio = 39;
    config.rf_rx_gpio = 48;
    config.rf_sql_gpio = -1;
    config.rf_pd_gpio = 40;
    config.rf_pwr_gpio = 38;
    config.rf_ptt_gpio = 41;
    config.rf_sql_active = 0;
    config.rf_pd_active = 1;
    config.rf_pwr_active = 1;
    config.rf_ptt_active = 0;
    config.adc_atten = 4;
    config.fx25_mode = 2;
#elif defined(CONFIG_IDF_TARGET_ESP32S3)
    config.rf_tx_gpio = 17;
    config.rf_rx_gpio = 18;
    config.rf_sql_gpio = -1;
    config.rf_pd_gpio = 4;
    config.rf_pwr_gpio = -1;
    config.rf_ptt_gpio = 5;
    config.rf_sql_active = 0;
    config.rf_pd_active = 1;
    config.rf_pwr_active = 1;
    config.rf_ptt_active = 1;
#else
    config.rf_tx_gpio = 13;
    config.rf_rx_gpio = 14;
    config.rf_sql_gpio = -1;
    config.rf_pd_gpio = 27;
    config.rf_pwr_gpio = -1;
    config.rf_ptt_gpio = 32;
    config.rf_sql_active = 0;
    config.rf_pd_active = 1;
    config.rf_pwr_active = 1;
    config.rf_ptt_active = 1;
#endif
    
    config.adc_dc_offset = 600;
    config.rf_baudrate = 9600;

    config.audio_hpf = false;
    config.audio_lpf = false;
    config.preamble = 3;
    sprintf(config.ntp_host, "aprs.nakhonthai.net");

    // IGATE
    config.igate_bcn = false;
    config.igate_en = false;
    config.rf2inet = true;
    config.inet2rf = false;
    config.igate_loc2rf = false;
    config.igate_loc2inet = true;
    config.rf2inetFilter = 0xFFFF; // All
    config.inet2rfFilter = config.digiFilter = FILTER_OBJECT | FILTER_ITEM | FILTER_MESSAGE | FILTER_MICE | FILTER_POSITION | FILTER_WX;
    //--APRS-IS
    config.aprs_ssid = 1;
    config.aprs_port = 14580;
    sprintf(config.aprs_mycall, "NOCALL");
    sprintf(config.aprs_host, "aprs.nakhonthai.net");
    memset(config.aprs_passcode, 0, sizeof(config.aprs_passcode));
    sprintf(config.aprs_moniCall, "%s-%d", config.aprs_mycall, config.aprs_ssid);
    sprintf(config.aprs_filter, "m/10");
    //--Position
    config.igate_gps = false;
    config.igate_lat = 13.7555;
    config.igate_lon = 100.4930;
    config.igate_alt = 0;
    config.igate_interval = 600;
    sprintf(config.igate_symbol, "A&");
    memset(config.igate_object, 0, sizeof(config.igate_object));
    memset(config.igate_phg, 0, sizeof(config.igate_phg));
    config.igate_path = 8;
    sprintf(config.igate_comment, "");
    sprintf(config.igate_status, "https://github.com/nakhonthai/ESP32APRS_Audio");
    config.igate_sts_interval = 1800;

    // DIGI REPEATER
    config.digi_en = false;
    config.digi_auto = false;
    config.digi_loc2rf = true;
    config.digi_loc2inet = false;
    config.digi_ssid = 3;
    config.digi_timestamp = false;
    sprintf(config.digi_mycall, "NOCALL");
    config.digi_path = 8;
    //--Position
    config.digi_gps = false;
    config.digi_lat = 13.7555;
    config.digi_lon = 100.4930;
    config.digi_alt = 0;
    config.digi_interval = 600;
    config.igate_timestamp = false;
    config.digi_delay = 0;
    config.digiFilter = FILTER_OBJECT | FILTER_ITEM | FILTER_MESSAGE | FILTER_MICE | FILTER_POSITION | FILTER_WX;

    sprintf(config.digi_symbol, "A#");
    memset(config.digi_phg, 0, sizeof(config.digi_phg));
    sprintf(config.digi_comment, "");
    sprintf(config.digi_status, "https://github.com/nakhonthai/ESP32APRS_Audio");
    config.digi_sts_interval = 1800;

    // Tracker
    config.trk_en = false;
    config.trk_loc2rf = true;
    config.trk_loc2inet = false;
    config.trk_rssi = false;
    config.trk_sat = false;
    config.trk_dx = false;
    config.trk_ssid = 7;
    config.trk_timestamp = false;
    sprintf(config.trk_mycall, "NOCALL");
    config.trk_path = 2;

    //--Position
    config.trk_gps = false;
    config.trk_lat = 13.7555;
    config.trk_lon = 100.4930;
    config.trk_alt = 0;
    config.trk_interval = 600;
    // Smart beacon
    config.trk_smartbeacon = true;
    config.trk_compress = true;
    config.trk_altitude = true;
    config.trk_log = true;
    config.trk_hspeed = 120;
    config.trk_lspeed = 5;
    config.trk_maxinterval = 30;
    config.trk_mininterval = 5;
    config.trk_minangle = 25;
    config.trk_slowinterval = 600;

    sprintf(config.trk_symbol, "/[");
    sprintf(config.trk_symmove, "/>");
    sprintf(config.trk_symstop, "\\>");
    // sprintf(config.trk_btext, "");
    sprintf(config.trk_mycall, "NOCALL");
    sprintf(config.trk_comment, "");
    memset(config.trk_item, 0, sizeof(config.trk_item));
    sprintf(config.trk_status, "https://github.com/nakhonthai/ESP32APRS_Audio");
    config.trk_sts_interval = 1800;

    // WX
    config.wx_en = false;
    config.wx_2rf = true;
    config.wx_2inet = true;
    // config.wx_channel = 0;
    config.wx_ssid = 13;
    sprintf(config.wx_mycall, "NOCALL");
    config.wx_path = 8;
    sprintf(config.wx_comment, "WX MODE");
    memset(config.wx_object, 0, sizeof(config.wx_object));
    config.wx_gps = false;
    config.wx_lat = 13.7555;
    config.wx_lon = 100.4930;
    config.wx_alt = 0;
    config.wx_interval = 600;
    config.wx_flage = 0;

    // Telemetry_0
    config.tlm0_en = false;
    config.tlm0_2rf = true;
    config.tlm0_2inet = true;
    config.tlm0_ssid = 0;
    sprintf(config.tlm0_mycall, "NOCALL");
    config.tlm0_path = 0;
    config.tlm0_data_interval = 600;
    config.tlm0_info_interval = 3600;
    sprintf(config.tlm0_PARM[0], "RF->INET");
    sprintf(config.tlm0_PARM[1], "INET->RF");
    sprintf(config.tlm0_PARM[2], "Repeater");
    sprintf(config.tlm0_PARM[3], "AllCount");
    sprintf(config.tlm0_PARM[4], "AllDrop");
    sprintf(config.tlm0_PARM[5], "IGATE");
    sprintf(config.tlm0_PARM[6], "DIGI");
    sprintf(config.tlm0_PARM[7], "WX");
    sprintf(config.tlm0_PARM[8], "SAT");
    sprintf(config.tlm0_PARM[9], "INET");
    sprintf(config.tlm0_PARM[10], "VPN");
    sprintf(config.tlm0_PARM[11], "4G");
    sprintf(config.tlm0_PARM[12], "FX.25");

    for (int i = 0; i < 5; i++)
    {
        sprintf(config.tlm0_UNIT[i], "Pkts");
        config.tlm0_EQNS[i][0] = 0; // a av2 + bv + c
        config.tlm0_EQNS[i][1] = 1; // b
        config.tlm0_EQNS[i][2] = 0; // c
    }
    sprintf(config.tlm0_UNIT[5], "En");
    sprintf(config.tlm0_UNIT[6], "En");
    sprintf(config.tlm0_UNIT[7], "En");
    sprintf(config.tlm0_UNIT[8], "En");
    sprintf(config.tlm0_UNIT[9], "ON");
    sprintf(config.tlm0_UNIT[10], "ON");
    sprintf(config.tlm0_UNIT[11], "ON");
    sprintf(config.tlm0_UNIT[12], "ON");
    config.tlm0_BITS_Active = 0xFF;
    config.tml0_data_channel[0] = 2;
    config.tml0_data_channel[1] = 3;
    config.tml0_data_channel[2] = 4;
    config.tml0_data_channel[3] = 1;
    config.tml0_data_channel[4] = 5;
    config.tml0_data_channel[5] = 1;
    config.tml0_data_channel[6] = 2;
    config.tml0_data_channel[7] = 3;
    config.tml0_data_channel[8] = 4;
    config.tml0_data_channel[9] = 5;
    config.tml0_data_channel[10] = 6;
    config.tml0_data_channel[11] = 7;
    config.tml0_data_channel[12] = 8;
    sprintf(config.tlm0_comment, "SYSTEM STATUS");

// memset(config.wx_type, 0, sizeof(config.wx_type));

// OLED DISPLAY
#ifdef OLED
    config.oled_enable = true;
#else
    config.oled_enable = false;
#endif

#ifdef GUI_LCD
config.oled_enable = true;
#endif

    config.oled_timeout = 60;
    config.dim = 0;
    config.contrast = 0;
    config.startup = 0;

    // Display
    config.disp_brightness = 250;
    config.disp_flip = false;
    config.dispDelay = 3; // Popup display 3 sec
    config.dispRF = true;
    config.dispINET = false;
    config.filterDistant = 0;
    config.dispFilter = FILTER_OBJECT | FILTER_ITEM | FILTER_MESSAGE | FILTER_MICE | FILTER_POSITION | FILTER_WX | FILTER_STATUS | FILTER_BUOY | FILTER_QUERY;
    config.h_up = true;
    config.tx_display = true;
    config.rx_display = true;

    // afsk,TNC
    sprintf(config.ntp_host, "ntp.nakhonthai.net");

    sprintf(config.path[0], "WIDE1-1");
    sprintf(config.path[1], "WIDE1-1,WIDE2-1");
    sprintf(config.path[2], "TRACK3-3");
    sprintf(config.path[3], "RS0ISS");

    // VPN Wireguard
    config.vpn = false;
    config.wg_port = 51820;
    sprintf(config.wg_peer_address, "vpn.nakhonthai.net");
    sprintf(config.wg_local_address, "192.168.1.2");
    sprintf(config.wg_netmask_address, "255.255.255.0");
    sprintf(config.wg_gw_address, "192.168.1.1");
    sprintf(config.wg_public_key, "");
    sprintf(config.wg_private_key, "");

    sprintf(config.http_username, "admin");
    sprintf(config.http_password, "admin");

    // config.gnss_baudrate = 9600;
    #ifdef TTGO_TWR
    config.gnss_enable = true;
    config.gnss_channel = 2;
    #else
    config.gnss_enable = false;
    #endif
    // config.gnss_tx_gpio = 19;
    // config.gnss_rx_gpio = 18;
    // config.gnss_pps_gpio = -1;
    config.gnss_tcp_port = 8080;
    sprintf(config.gnss_tcp_host, "192.168.0.1");
    memset(config.gnss_at_command, 0, sizeof(config.gnss_at_command));

    config.sensor[0].enable = false;
    config.sensor[0].port = 0;
    config.sensor[0].address = 2;
    config.sensor[0].samplerate = 10;
    config.sensor[0].averagerate = 600;
    config.sensor[0].eqns[0] = 0; // a
    config.sensor[0].eqns[1] = 1; // b
    config.sensor[0].eqns[2] = 0; // c
    config.sensor[0].type = SENSOR_TEMPERATURE;
    sprintf(config.sensor[0].parm, "Temperature");
    sprintf(config.sensor[0].unit, "°C");

    config.sensor[1].enable = false;
    config.sensor[1].port = 0;
    config.sensor[1].address = 2;
    config.sensor[1].samplerate = 10;
    config.sensor[1].averagerate = 600;
    config.sensor[1].eqns[0] = 0; // a
    config.sensor[1].eqns[1] = 1; // b
    config.sensor[1].eqns[2] = 0; // c
    config.sensor[1].type = SENSOR_HUMIDITY;
    sprintf(config.sensor[1].parm, "Humidity");
    sprintf(config.sensor[1].unit, "%%RH");

    config.sensor[2].enable = false;
    config.sensor[2].port = 0;
    config.sensor[2].address = 2;
    config.sensor[2].samplerate = 10;
    config.sensor[2].averagerate = 600;
    config.sensor[2].eqns[0] = 0; // a
    config.sensor[2].eqns[1] = 1; // b
    config.sensor[2].eqns[2] = 0; // c
    config.sensor[2].type = SENSOR_PM25;
    sprintf(config.sensor[2].parm, "PM2.5");
    sprintf(config.sensor[2].unit, "μg/m³");

    config.sensor[3].enable = false;
    config.sensor[3].port = 0;
    config.sensor[3].address = 2;
    config.sensor[3].samplerate = 10;
    config.sensor[3].averagerate = 600;
    config.sensor[3].eqns[0] = 0; // a
    config.sensor[3].eqns[1] = 1; // b
    config.sensor[3].eqns[2] = 0; // c
    config.sensor[3].type = SENSOR_PM100;
    sprintf(config.sensor[3].parm, "PM10.0");
    sprintf(config.sensor[3].unit, "μg/m³");

    config.sensor[4].enable = false;
    config.sensor[4].port = 0;
    config.sensor[4].address = 2;
    config.sensor[4].samplerate = 10;
    config.sensor[4].averagerate = 600;
    config.sensor[4].eqns[0] = 0; // a
    config.sensor[4].eqns[1] = 1; // b
    config.sensor[4].eqns[2] = 0; // c
    config.sensor[4].type = SENSOR_CO2;
    sprintf(config.sensor[4].parm, "CO2");
    sprintf(config.sensor[4].unit, "ppm");

    config.sensor[5].enable = false;
    config.sensor[5].port = 0;
    config.sensor[5].address = 2;
    config.sensor[5].samplerate = 10;
    config.sensor[5].averagerate = 600;
    config.sensor[5].eqns[0] = 0; // a
    config.sensor[5].eqns[1] = 1; // b
    config.sensor[5].eqns[2] = 0; // c
    config.sensor[5].type = SENSOR_CH2O;
    sprintf(config.sensor[5].parm, "CH2O");
    sprintf(config.sensor[5].unit, "μg/m³");

    config.sensor[6].enable = false;
    config.sensor[6].port = 0;
    config.sensor[6].address = 2;
    config.sensor[6].samplerate = 10;
    config.sensor[6].averagerate = 600;
    config.sensor[6].eqns[0] = 0; // a
    config.sensor[6].eqns[1] = 1; // b
    config.sensor[6].eqns[2] = 0; // c
    config.sensor[6].type = SENSOR_TVOC;
    sprintf(config.sensor[6].parm, "TVOC");
    sprintf(config.sensor[6].unit, "μg/m³");

    config.sensor[7].enable = false;
    config.sensor[7].port = 0;
    config.sensor[7].address = 2;
    config.sensor[7].samplerate = 10;
    config.sensor[7].averagerate = 600;
    config.sensor[7].eqns[0] = 0; // a
    config.sensor[7].eqns[1] = 1; // b
    config.sensor[7].eqns[2] = 0; // c
    config.sensor[7].type = SENSOR_PRESSURE;
    sprintf(config.sensor[7].parm, "Pressure");
    sprintf(config.sensor[7].unit, "hPa(mBar)");

    config.sensor[8].enable = false;
    config.sensor[8].port = 0;
    config.sensor[8].address = 2;
    config.sensor[8].samplerate = 10;
    config.sensor[8].averagerate = 600;
    config.sensor[8].eqns[0] = 0;   // a
    config.sensor[8].eqns[1] = 0.2; // b
    config.sensor[8].eqns[2] = 0;   // c
    config.sensor[8].type = SENSOR_RAIN;
    sprintf(config.sensor[8].parm, "Rain");
    sprintf(config.sensor[8].unit, "mm.");

    config.sensor[9].enable = false;
    config.sensor[9].port = 0;
    config.sensor[9].address = 2;
    config.sensor[9].samplerate = 10;
    config.sensor[9].averagerate = 600;
    config.sensor[9].eqns[0] = 0; // a
    config.sensor[9].eqns[1] = 1; // b
    config.sensor[9].eqns[2] = 0; // c
    config.sensor[9].type = SENSOR_WIND_SPD;
    sprintf(config.sensor[9].parm, "Wind Speed");
    sprintf(config.sensor[9].unit, "kPh");

// #ifdef CORE_DEBUG_LEVEL
//     config.uart0_enable = false;
//     config.uart0_baudrate = 115200;
//     config.uart0_rx_gpio = 20;
//     config.uart0_tx_gpio = 21;
//     config.uart0_rts_gpio = -1;
#if defined(TTGO_TWR)
    config.uart0_enable = false;
    config.uart0_baudrate = 115200;
    config.uart0_rx_gpio = 44;
    config.uart0_tx_gpio = 43;
    config.uart0_rts_gpio = -1;
#elif defined(CONFIG_IDF_TARGET_ESP32S3)
    config.uart0_enable = false;
    config.uart0_baudrate = 115200;
    config.uart0_rx_gpio = 44;
    config.uart0_tx_gpio = 43;
    config.uart0_rts_gpio = -1;
#else
    config.uart0_enable = false;
    config.uart0_baudrate = 9600;
    config.uart0_rx_gpio = 3;
    config.uart0_tx_gpio = 1;
    config.uart0_rts_gpio = -1;
#endif

#ifdef ESP32C3_MINI
    config.uart1_enable = false;
    config.uart1_baudrate = 9600;
    config.uart1_rx_gpio = 21;
    config.uart1_tx_gpio = 20;
    config.uart1_rts_gpio = -1;
#elif defined(TTGO_TWR)
    config.uart1_enable = true;
    config.uart1_baudrate = 9600;
    config.uart1_rx_gpio = 5;
    config.uart1_tx_gpio = 6;
    config.uart1_rts_gpio = -1;    
#elif defined(CONFIG_IDF_TARGET_ESP32S3)
    config.uart1_enable = false;
    config.uart1_baudrate = 9600;
    config.uart1_rx_gpio = 18;
    config.uart1_tx_gpio = 17;
    config.uart1_rts_gpio = -1;
#else
    config.uart1_enable = false;
    config.uart1_baudrate = 9600;
    config.uart1_rx_gpio = 18;
    config.uart1_tx_gpio = 19;
    config.uart1_rts_gpio = -1;
#endif

    // config.uart2_enable = false;
    // config.uart2_baudrate = 9600;
    // config.uart2_rx_gpio = 16;
    // config.uart2_tx_gpio = 17;
    // config.uart2_rts_gpio = -1;

    config.modbus_enable = false;
    config.modbus_de_gpio = -1;
    config.modbus_address = 0;
    config.modbus_channel = 0;

    config.onewire_enable = false;
    config.onewire_gpio = -1;

    config.pwr_en = false;
    config.pwr_mode = MODE_A;        // A=Continue,B=Wait for receive,C=Send and sleep
    config.pwr_sleep_interval = 600; // sec
    config.pwr_stanby_delay = 30;   // sec
    config.pwr_sleep_activate = ACTIVATE_TRACKER | ACTIVATE_WIFI;
    config.pwr_gpio = -1;
    config.pwr_active = 1;

    for (int i = 0; i < 5; i++)
    {
        config.trk_tlm_avg[i] = false;
        config.trk_tlm_sensor[i] = 0;
        config.trk_tlm_precision[i] = 0;
        config.trk_tlm_offset[i] = 0;
        memset(config.trk_tlm_UNIT[i], 0, 8);
        memset(config.trk_tlm_PARM[i], 0, 10);
        config.trk_tlm_EQNS[i][0] = 0; // a av2 + bv + c
        config.trk_tlm_EQNS[i][1] = 1; // b
        config.trk_tlm_EQNS[i][2] = 0; // c
    }

    for (int i = 0; i < 5; i++)
    {
        config.digi_tlm_avg[i] = false;
        config.digi_tlm_sensor[i] = 0;
        config.digi_tlm_precision[i] = 0;
        config.digi_tlm_offset[i] = 0;
        memset(config.digi_tlm_UNIT[i], 0, 8);
        memset(config.digi_tlm_PARM[i], 0, 10);
        config.digi_tlm_EQNS[i][0] = 0; // a av2 + bv + c
        config.digi_tlm_EQNS[i][1] = 1; // b
        config.digi_tlm_EQNS[i][2] = 0; // c
    }

    for (int i = 0; i < 5; i++)
    {
        config.igate_tlm_avg[i] = false;
        config.igate_tlm_sensor[i] = 0;
        config.igate_tlm_precision[i] = 0;
        config.igate_tlm_offset[i] = 0;
        memset(config.igate_tlm_UNIT[i], 0, 8);
        memset(config.igate_tlm_PARM[i], 0, 10);
        config.igate_tlm_EQNS[i][0] = 0; // a av2 + bv + c
        config.igate_tlm_EQNS[i][1] = 1; // b
        config.igate_tlm_EQNS[i][2] = 0; // c
    }

    for (int i = 0; i < WX_SENSOR_NUM; i++)
    {
        config.wx_sensor_enable[i] = false;
        config.wx_sensor_avg[i] = true;
        config.wx_sensor_ch[i] = 0;
    }

#ifdef OLED
#ifdef ESP32C3_MINI
    config.i2c_enable = true;
    config.i2c_sda_pin = 5;
    config.i2c_sck_pin = 6;
#elif defined(CONFIG_IDF_TARGET_ESP32S3)
    config.i2c_enable = true;
    config.i2c_sda_pin = 42;
    config.i2c_sck_pin = 41;
#else
    config.i2c_enable = true;
    config.i2c_sda_pin = 21;
    config.i2c_sck_pin = 22;
#endif
#elif defined(GUI_LCD)
    config.i2c_enable = true;
    config.i2c_sda_pin = 8;
    config.i2c_sck_pin = 9;
#else
    config.i2c_enable = false;
    config.i2c_sda_pin = -1;
    config.i2c_sck_pin = -1;
#endif
    config.i2c_freq = 400000;
    config.i2c1_enable = false;
    config.i2c1_sda_pin = -1;
    config.i2c1_sck_pin = -1;
    config.i2c1_freq = 100000;

    config.counter0_enable = false;
    config.counter0_active = 0;
    config.counter0_gpio = -1;

    config.counter1_enable = false;
    config.counter1_active = 0;
    config.counter1_gpio = -1;

    config.ext_tnc_enable = false;
    config.ext_tnc_channel = 0;
    config.ext_tnc_mode = 2;

    sprintf(config.path[0], "TRACE2-2");
    sprintf(config.path[1], "WIDE1-1");
    sprintf(config.path[2], "WIDE1-1,WIDE2-1");
    sprintf(config.path[3], "RFONLY");

    config.msg_enable = true;
    config.msg_encrypt = false;
    config.msg_rf = true;
    config.msg_inet = true;
    config.msg_retry = 3;
    config.msg_interval = 30; // second
    config.msg_path = 9;
    sprintf(config.msg_key, "8EC8233E91D59B0164C24E771BA66307");
    sprintf(config.msg_mycall, "NOCALL");

    config.log = 0;
#ifdef MQTT
    config.en_mqtt = false;
    sprintf(config.mqtt_host, "mqtt.nakhonthai.net");
    char strCID[13];
    uint64_t chipid = ESP.getEfuseMac();
    sprintf(strCID, "%04X%08X", (uint16_t)(chipid >> 32), (uint32_t)chipid);
    sprintf(config.mqtt_topic, "/%s/TX", strCID);
    sprintf(config.mqtt_subscribe, "/%s/RX", strCID);
    config.mqtt_user[0] = 0;
    config.mqtt_pass[0] = 0;
    config.mqtt_port = 1883;
#endif

    config.ppp_enable = false;
    sprintf(config.ppp_apn, "internet");
    sprintf(config.ppp_pin, "0000");
    config.ppp_serial = 0;
    config.ppp_serial_baudrate = 115200;
    config.ppp_rx_gpio = -1;
    config.ppp_tx_gpio = -1;
    config.ppp_rst_gpio = -1;
    config.ppp_rts_gpio = -1;
    config.ppp_rst_active = 0;
    config.ppp_dtr_gpio = -1;
    config.ppp_cts_gpio = -1;
    config.ppp_ri_gpio = -1;
    config.ppp_rst_delay = 1000;
    config.ppp_pwr_gpio = -1;
    config.ppp_pwr_active = 1;

    config.trk_mice_type = 7;
    config.trk_tlm_interval = 0;
    config.digi_tlm_interval = 0;
    config.igate_tlm_interval = 0;
    config.wx_tlm_interval = 0;
    sprintf(config.host_name, "ESP32APRS_Audio");

    config.fx25_mode = 2; // Used modem mode FX.25 RX+TX
}

unsigned long NTP_Timeout;
unsigned long pingTimeout;

SemaphoreHandle_t psramMutex = NULL;

bool psramLock(TickType_t timeout = portMAX_DELAY)
    {
    if(psramMutex == NULL)
    {
        return true;
    }
    if(xSemaphoreTake(psramMutex, timeout) == pdTRUE)
    {
        return true;
    }
    log_e("psramMutex timeout!");
    return false;
}

void psramUnlock()
{
    if(psramMutex != NULL)
    {
        xSemaphoreGive(psramMutex);
    }
}

const char *lastTitle = "LAST HEARD";

int tlmList_Find(char *call)
{
    int i;
    for (i = 0; i < TLMLISTSIZE; i++)
    {
        if (strstr(Telemetry[i].callsign, call) != NULL)
            return i;
    }
    return -1;
}

int tlmListOld()
{
    int i, ret = 0;
    time_t minimum = Telemetry[0].time;
    for (i = 1; i < TLMLISTSIZE; i++)
    {
        if (Telemetry[i].time < minimum)
        {
            minimum = Telemetry[i].time;
            ret = i;
        }
        if (Telemetry[i].time > now())
            Telemetry[i].time = 0;
    }
    return ret;
}

int pkgList_Find(char *call)
{
    int i;
    for (i = 0; i < PKGLISTSIZE; i++)
    {
        if (strstr(pkgList[(int)i].calsign, call) != NULL)
            return i;
    }
    return -1;
}

int pkgList_Find(char *call, uint16_t type)
{
    int i;
    for (i = 0; i < PKGLISTSIZE; i++)
    {
        if (pkgList[i].type == type)
        {
            if (strstr(pkgList[i].calsign, call) != NULL)
            {
                return i;
            }
        }
    }
    return -1;
}

int pkgList_Find(char *call, char *object, uint16_t type)
{
    int i;
    for (i = 0; i < PKGLISTSIZE; i++)
    {
        if (pkgList[i].type == type)
        {
            if (strnstr(pkgList[i].calsign, call, strlen(call)) != NULL)
            {
                if (strnstr(pkgList[i].object, object, strlen(object)) != NULL)
                    return i;
            }
        }
    }
    return -1;
}

int pkgListOld()
{
    int i, ret = -1;
    time_t minimum = time(NULL) + 86400; // pkgList[0].time;
    for (i = 0; i < PKGLISTSIZE; i++)
    {
        if (pkgList[(int)i].time < minimum)
        {
            minimum = pkgList[(int)i].time;
            ret = i;
        }
    }
    return ret;
}

void sort(pkgListType a[], int size)
{
    pkgListType t;
    char *ptr1;
    char *ptr2;
    char *ptr3;
    ptr1 = (char *)&t;
    psramLock();
    for (int i = 0; i < (size - 1); i++)
    {
        for (int o = 0; o < (size - (i + 1)); o++)
        {
            if (a[o].time < a[o + 1].time)
            {
                ptr2 = (char *)&a[o];
                ptr3 = (char *)&a[o + 1];
                memcpy(ptr1, ptr2, sizeof(pkgListType));
                memcpy(ptr2, ptr3, sizeof(pkgListType));
                memcpy(ptr3, ptr1, sizeof(pkgListType));
            }
        }
    }
    psramUnlock();
}

void sortPkgDesc(pkgListType a[], int size)
{
    pkgListType t;
    char *ptr1;
    char *ptr2;
    char *ptr3;
    ptr1 = (char *)&t;
    psramLock();
    for (int i = 0; i < (size - 1); i++)
    {
        for (int o = 0; o < (size - (i + 1)); o++)
        {
            if (a[o].pkg < a[o + 1].pkg)
            {
                ptr2 = (char *)&a[o];
                ptr3 = (char *)&a[o + 1];
                memcpy(ptr1, ptr2, sizeof(pkgListType));
                memcpy(ptr2, ptr3, sizeof(pkgListType));
                memcpy(ptr3, ptr1, sizeof(pkgListType));
            }
        }
    }
    psramUnlock();
}
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
void loop()
{
    if (millis() > timeTask)
    {
        timeTask = millis() + 10000;
        unsigned long upT = (millis() / 1000) - upTimeStamp;
        convertSecondsToDHMS(nmea, upT);
        log_d("Task process APRS=%iuS\t NETWORK=%iuS\t GPS=%iuS\t SERIAL=%iuS\n", timerAPRS, timerNetwork, timerGPS, timerSerial);
        log_d("upTime %s Free heap: %s KB \tWiFi:%s ,RSSI:%s dBm", nmea, String((float)ESP.getFreeHeap() / 1000, 1).c_str(), String(WiFi.SSID()).c_str(), String(WiFi.RSSI()).c_str());
    }

    vTaskDelay(10 / portTICK_PERIOD_MS);

    // if (digitalRead(BOOT_PIN) == LOW)
    // {
    //     btn_count++;
    //     if (btn_count > 1000) // Push BOOT 10sec
    //     {
    //         digitalWrite(LED_RX_PIN, HIGH);
    //         digitalWrite(LED_TX_PIN, HIGH);
    //     }
    // }
    // else
    // {
    //     if (btn_count > 0)
    //     {
    //         // Serial.printf("btn_count=%dms\n", btn_count * 10);
    //         if (btn_count > 1000) // Push BOOT 10sec to Factory Default
    //         {
    //             // digitalWrite(LED_RX, LOW);
    //             // digitalWrite(LED_TX, LOW);
    //             defaultConfig();
    //             log_d("SYSTEM REBOOT NOW!");
    //             esp_restart();
    //         }
    //         else
    //         {
    //             showDisp = true;
    //             timeSec = timeHalfSec = millis();
    //             // if (oledSleepTimeout > 0)
    //             //{
    //             curTab++;
    //             if (curTab > 3)
    //                 curTab = 0;
    //             //}
    //         }
    //         btn_count = 0;
    //     }
    // }
    #ifdef OLED
    if (digitalRead(BOOT_PIN) == LOW)
    {
        btn_count++;
        if (btn_count > 200) // Push BOOT >2sec
        {
            btn_count = 0;
            if (curTab == 0)
            {
                showDisp = true;
                timeSec = timeHalfSec = millis();
                if (gps_mode)
                    gps_mode = false;
                else
                    gps_mode = true;
                msgBox("GPS SWAP");
                while (digitalRead(BOOT_PIN) == LOW)
                {
                    delay(100);
                }
            }
            else if (curTab == 4) // System display
            {
                msgBox("POWER OFF");
                while (digitalRead(BOOT_PIN) == LOW)
                {
                    delay(100);
                }
                // PowerOff();
                esp_deep_sleep_start();
            }
            else if (curTab == 6) // Wifi display
            {
                if (manualWiFi)
                {
                    manualWiFi = false;
                    msgBox("WiFi OFF");
                    vTaskSuspend(taskNetworkHandle);
                    WiFi.disconnect(true); // Disconnect from the network
                    WiFi.persistent(false);
                    WiFi.mode(WIFI_OFF); // Switch WiFi off
                }
                else
                {
                    manualWiFi = true;
                    msgBox("WiFi ON");
                    vTaskResume(taskNetworkHandle);
                }
                while (digitalRead(BOOT_PIN) == LOW)
                {
                    delay(100);
                }
            }
            else if (curTab == 1) // Status display
            {
                msgBox("MANUAL TX");
                while (digitalRead(BOOT_PIN) == LOW)
                {
                    delay(100);
                }
                EVENT_TX_POSITION = 6;
                tx_interval = config.trk_interval;
            }
        }
        else
        {
        }
    }
    else
    {
        if (btn_count > 0)
        {
            log_d("btn_count=%d", btn_count);
            if (btn_count > 25) // Push BOOT 10sec to Factory Default
            {
                // digitalWrite(LED_RX, LOW);
                // digitalWrite(LED_TX, LOW);
                // defaultConfig();
                // log_d("SYSTEM REBOOT NOW!");
                // esp_restart();
            }
            else
            {
                StandByTick = millis() + (config.pwr_stanby_delay * 1000);
                if (save_mode)
                    save_act = true;
                showDisp = true;
                timeSec = timeHalfSec = millis();
                // if (oledSleepTimeout > 0)
                //{
                curTab++;
                if (curTab > 7)
                    curTab = 0;
                //}
                log_d("curTab=%d", curTab);
            }
        }
        btn_count = 0;
    }

    // Popup Display
    if (config.oled_enable == true)
    {
        if (dispBuffer.getCount() > 0)
        {
            if (millis() > timeHalfSec)
            {
                char tnc2[300];
                dispBuffer.pop(&tnc2);
                dispWindow(String(tnc2), 0, false);
                timeHalfSec = millis() + (config.dispDelay * 1000);
                oledSleepTimeout = millis() + (config.oled_timeout * 1000);
            }
        }
        else
        {
            if (!getTransmit())
            {
                if (queTxDisp.getCount() > 0)
                { // have tx info display
                    txDisp txs;
                    if (queTxDisp.pop(&txs))
                    {
                        dispTxWindow(txs);
                        delay(1000);
                        // if (menuSel == 0)
                        //     curTabOld = curTab + 1;
                    }
                }
            }

            // Sleep display
            if (millis() > timeHalfSec)
            {
                if (millis() > timeSec && timeHalfSec > 0)
                {
                    timeSec = millis() + 10000;
                    showDisp = true;
                    // timeHalfSec = 0;
                    // oledSleepTimeout = millis() + (config.oled_timeout * 1000);
                }
                else
                {
                    if (millis() > oledSleepTimeout && oledSleepTimeout > 0)
                    {
                        showDisp = false;
                        timeHalfSec = 0;
                        oledSleepTimeout = 0;
                        i2c_busy = true;
                        display.clearDisplay();
                        display.display();
                        i2c_busy = false;
                    }
                }
            }
        }

        if (showDisp)
        {
            showDisp = false;
            timeHalfSec = millis();
            // oledSleepTimeout = millis() + (config.oled_timeout * 1000);
            switch (curTab)
            {
            case 1:
                statisticsDisp();
                timeSec = millis() + 10000;
                break;
            case 2:
                pkgLastDisp();
                timeSec = millis() + 10000;
                break;
            case 3:
                pkgCountDisp();
                timeSec = millis() + 10000;
                break;
            case 4:
                systemDisp();
                timeSec = millis() + 10000;
                break;
            case 5:
                radioDisp();
                timeSec = millis() + 10000;
                break;
            case 6:
                wifiDisp();
                timeSec = millis() + 10000;
                break;
            case 7:
                sensorDisp();
                timeSec = millis() + 10000;
                break;
            case 0:
                gpsDisp();
                timeSec = millis() + 1000;
            }
        }
    }
#endif

    // Tick one secound
    if (millis() > timeCheck)
    {
        // esp_task_wdt_reset();
        timeCheck = millis() + 1000;
        #ifdef TTGO_TWR
        VBat = (float)PMU.getBattVoltage() / 1000;
        VBat_Flag = true;
        #endif

        // Automatic Restart when heap memory not enough
        #ifdef __XTENSA__
        if (ESP.getFreeHeap() < 50000)
        #else
        if (ESP.getFreeHeap() < 70000)
        #endif
        {
            if (++heapCount > 5)
            {
                heapCount = 0;
                vTaskSuspendAll();
                WiFi.disconnect(true); // Disconnect from the network
                WiFi.persistent(false);
                WiFi.mode(WIFI_OFF); // Switch WiFi off
                //PowerOff();
                esp_restart();
            }
        }
        else
        {
            if (heapCount > 0)
                heapCount--;
        }
        // Serial.println(String(ESP.getFreeHeap()));

        if ((config.reset_timeout > 0) && (millis() > autoResetTimeout))
        {
            autoResetTimeout = millis() + (config.reset_timeout * 60000);
            log_d("Auto Reset System");
            vTaskSuspendAll();
            WiFi.disconnect(true); // Disconnect from the network
            WiFi.persistent(false);
            WiFi.mode(WIFI_OFF); // Switch WiFi off
            // PowerOff();
            esp_restart();
        }
    }
}

String sendIsAckMsg(String toCallSign, int msgId)
{
    char str[300];
    char call[11];
    int i;
    memset(&call[0], 0, 11);
    sprintf(call, "%s-%d", config.aprs_mycall, config.aprs_ssid);
    strcpy(&call[0], toCallSign.c_str());
    i = strlen(call);
    for (; i < 9; i++)
        call[i] = 0x20;
    memset(&str[0], 0, 300);

    sprintf(str, "%s-%d>APE32A%s::%s:ack%d", config.aprs_mycall, config.aprs_ssid, VERSION, call, msgId);
    //	client.println(str);
    return String(str);
}

void sendIsPkg(char *raw)
{
    char str[300];
    sprintf(str, "%s-%d>APE32A%s:%s", config.aprs_mycall, config.aprs_ssid, VERSION, raw);
    // client.println(str);
    String tnc2Raw = String(str);
    if (aprsClient.connected())
        aprsClient.println(tnc2Raw); // Send packet to Inet
    if (config.digi_en)
        pkgTxPush(str, strlen(str), 0, RF_CHANNEL);
}

void sendIsPkgMsg(char *raw)
{
    char str[300];
    char call[11];
    int i;
    memset(&call[0], 0, 11);
    if (config.aprs_ssid == 0)
        sprintf(call, "%s", config.aprs_mycall);
    else
        sprintf(call, "%s-%d", config.aprs_mycall, config.aprs_ssid);
    i = strlen(call);
    for (; i < 9; i++)
        call[i] = 0x20;

    if (config.aprs_ssid == 0)
        sprintf(str, "%s>APE32A::%s:%s", config.aprs_mycall, call, raw);
    else
        sprintf(str, "%s-%d>APE32A::%s:%s", config.aprs_mycall, config.aprs_ssid, call, raw);

    String tnc2Raw = String(str);
    if (aprsClient.connected())
        aprsClient.println(tnc2Raw); // Send packet to Inet
}

void sendTelemetry_0(char *raw, bool header)
{
    char str[300];
    char call[11];
    int i;
    memset(&call[0], 0, 11);
        if (config.tlm0_ssid == 0)
            sprintf(call, "%s", config.tlm0_mycall);
        else
            sprintf(call, "%s-%d", config.tlm0_mycall, config.tlm0_ssid);
    i = strlen(call);
    for (; i < 9; i++)
        call[i] = 0x20;

    if (header)
    {
        if (config.tlm0_ssid == 0)
        {
            if (config.tlm0_path < 5)
            {
                if (config.tlm0_path > 0)
                    sprintf(str, "%s>APE32A-%d::%s:%s ", config.tlm0_mycall, config.tlm0_path, call, raw);
                else
                    sprintf(str, "%s>APE32A::%s:%s ", config.tlm0_mycall, call, raw);
            }
            else
            {
                sprintf(str, "%s>APE32A,%s::%s:%s ", config.tlm0_mycall, getPath(config.tlm0_path).c_str(), call, raw);
            }
        }
        else
        {
            if (config.tlm0_path < 5)
            {
                if (config.tlm0_path > 0)
                    sprintf(str, "%s-%d>APE32A-%d::%s:%s ", config.tlm0_mycall, config.tlm0_ssid, config.tlm0_path, call, raw);
                else
                    sprintf(str, "%s-%d>APE32A::%s:%s ", config.tlm0_mycall, config.tlm0_ssid, call, raw);
            }
            else
            {
                sprintf(str, "%s-%d>APE32A,%s::%s:%s ", config.tlm0_mycall, config.tlm0_ssid, getPath(config.tlm0_path).c_str(), call, raw);
            }
        }
    }
    else
    {
        if (config.tlm0_ssid == 0)
        {
            if (config.tlm0_path < 5)
            {
                if (config.tlm0_path > 0)
                    sprintf(str, "%s>APE32A-%d:%s", config.tlm0_mycall, config.tlm0_path, raw);
                else
                    sprintf(str, "%s>APE32A:%s", config.tlm0_mycall, raw);
            }
            else
            {
                sprintf(str, "%s>APE32A,%s:%s", config.tlm0_mycall, getPath(config.tlm0_path).c_str(), raw);
            }
        }
        else
        {
            if (config.tlm0_path < 5)
            {
                if (config.tlm0_path > 0)
                    sprintf(str, "%s-%d>APE32A-%d:%s", config.tlm0_mycall, config.tlm0_ssid, config.tlm0_path, raw);
                else
                    sprintf(str, "%s-%d>APE32A:%s", config.tlm0_mycall, config.tlm0_ssid, raw);
            }
            else
            {
                sprintf(str, "%s-%d>APE32A,%s:%s", config.tlm0_mycall, config.tlm0_ssid, getPath(config.tlm0_path).c_str(), raw);
            }
        }
    }

    uint8_t SendMode = 0;
    if (config.tlm0_2rf)
        SendMode |= RF_CHANNEL;
    if (config.tlm0_2inet)
        SendMode |= INET_CHANNEL;
    pkgTxPush(str, strlen(str), 0, SendMode);

#if 1
    if (config.tlm0_2rf)
    { // TLM SEND TO RF
        SendMode |= RF_CHANNEL;
        // char *rawP = (char *)malloc(rawData.length());
        //  rawData.toCharArray(rawP, rawData.length());
        // memcpy(rawP, rawData.c_str(), rawData.length());
        pkgTxPush(str, strlen(str), 0, RF_CHANNEL);
        // pushTxDisp(TXCH_RF, "TX DIGI POS", sts);
        // free(rawP);
    }
    if (config.tlm0_2inet)
    { // TLM SEND TO APRS-IS

        if (aprsClient.connected())
        {
            status.txCount++;
            aprsClient.printf("%s\r\n", str); // Send packet to Inet
            // pushTxDisp(TXCH_TCP, "TX DIGI POS", sts);
        }
    }
#endif
}

void sendTelemetry_trk(char *raw)
{
    char str[300];
    char call[11];
    int i;
    memset(&call[0], 0, 11);
    if (strlen(config.trk_item) > 3)
    {
        sprintf(call, "%s", config.trk_item);
    }
    else
    {
        if (config.trk_ssid == 0)
            sprintf(call, "%s", config.trk_mycall);
        else
            sprintf(call, "%s-%d", config.trk_mycall, config.trk_ssid);
    }
    i = strlen(call);
    for (; i < 9; i++)
        call[i] = 0x20;

    if (config.trk_ssid == 0)
    {
        if (config.trk_path < 5)
        {
            if (config.trk_path > 0)
                sprintf(str, "%s>APE32A-%d::%s:%s ", config.trk_mycall, config.trk_path, call, raw);
            else
                sprintf(str, "%s>APE32A::%s:%s ", config.trk_mycall, call, raw);
        }
        else
        {
            sprintf(str, "%s>APE32A,%s::%s:%s ", config.trk_mycall, getPath(config.trk_path).c_str(), call, raw);
        }
    }
    else
    {
        if (config.trk_path < 5)
        {
            if (config.trk_path > 0)
                sprintf(str, "%s-%d>APE32A-%d::%s:%s ", config.trk_mycall, config.trk_ssid, config.trk_path, call, raw);
            else
                sprintf(str, "%s-%d>APE32A::%s:%s ", config.trk_mycall, config.trk_ssid, call, raw);
        }
        else
        {
            sprintf(str, "%s-%d>APE32A,%s::%s:%s ", config.trk_mycall, config.trk_ssid, getPath(config.trk_path).c_str(), call, raw);
        }
    }

    uint8_t SendMode = 0;
    if (config.trk_loc2rf)
        SendMode |= RF_CHANNEL;
    if (config.trk_loc2inet)
        SendMode |= INET_CHANNEL;
    pkgTxPush(str, strlen(str), 1000, SendMode);

    // if (config.trk_loc2rf)
    // { // TLM SEND TO RF
    //     pkgTxPush(str, strlen(str), 0);
    // }
    // if (config.trk_loc2inet)
    // { // TLM SEND TO APRS-IS
    //     if (aprsClient.connected())
    //     {
    //         status.txCount++;
    //         aprsClient.printf("%s\r\n", str); // Send packet to Inet
    //         delay(2000);
    //     }
    // }
}

void sendTelemetry_igate(char *raw)
{
    char str[300];
    char call[11];
    int i;
    memset(&call[0], 0, 11);
    if (strlen(config.igate_object) > 3)
    {
        sprintf(call, "%s", config.igate_object);
    }
    else
    {
        if (config.aprs_ssid == 0)
            sprintf(call, "%s", config.aprs_mycall);
        else
            sprintf(call, "%s-%d", config.aprs_mycall, config.aprs_ssid);
    }
    i = strlen(call);
    for (; i < 9; i++)
        call[i] = 0x20;

    if (config.aprs_ssid == 0)
    {
        if (config.igate_path < 5)
        {
            if (config.igate_path > 0)
                sprintf(str, "%s>APE32A-%d::%s:%s ", config.aprs_mycall, config.igate_path, call, raw);
            else
                sprintf(str, "%s>APE32A::%s:%s ", config.aprs_mycall, call, raw);
        }
        else
        {
            sprintf(str, "%s>APE32A,%s::%s:%s ", config.aprs_mycall, getPath(config.igate_path).c_str(), call, raw);
        }
    }
    else
    {
        if (config.igate_path < 5)
        {
            if (config.igate_path > 0)
                sprintf(str, "%s-%d>APE32A-%d::%s:%s ", config.aprs_mycall, config.aprs_ssid, config.igate_path, call, raw);
            else
                sprintf(str, "%s-%d>APE32A::%s:%s ", config.aprs_mycall, config.aprs_ssid, call, raw);
        }
        else
        {
            sprintf(str, "%s-%d>APE32A,%s::%s:%s ", config.aprs_mycall, config.aprs_ssid, getPath(config.igate_path).c_str(), call, raw);
        }
    }

    uint8_t SendMode = 0;
    if (config.igate_loc2rf)
        SendMode |= RF_CHANNEL;
    if (config.igate_loc2inet)
        SendMode |= INET_CHANNEL;
    pkgTxPush(str, strlen(str), 0, SendMode);
    // if (config.igate_loc2rf)
    // { // TLM SEND TO RF
    //     pkgTxPush(str, strlen(str), 0);
    // }
    // if (config.igate_loc2inet)
    // { // TLM SEND TO APRS-IS
    //     if (aprsClient.connected())
    //     {
    //         status.txCount++;
    //         aprsClient.printf("%s\r\n", str); // Send packet to Inet
    //         delay(2000);
    //     }
    // }
}

void sendTelemetry_digi(char *raw)
{
    char str[300];
    char call[11];
    int i;
    memset(&call[0], 0, 11);

    if (config.digi_ssid == 0)
        sprintf(call, "%s", config.digi_mycall);
    else
        sprintf(call, "%s-%d", config.digi_mycall, config.digi_ssid);
    i = strlen(call);
    for (; i < 9; i++)
        call[i] = 0x20;

    if (config.digi_ssid == 0)
    {
        if (config.digi_path < 5)
        {
            if (config.digi_path > 0)
                sprintf(str, "%s>APE32A-%d::%s:%s ", config.digi_mycall, config.digi_path, call, raw);
            else
                sprintf(str, "%s>APE32A::%s:%s ", config.digi_mycall, call, raw);
        }
        else
        {
            sprintf(str, "%s>APE32A,%s::%s:%s ", config.digi_mycall, getPath(config.digi_path).c_str(), call, raw);
        }
    }
    else
    {
        if (config.digi_path < 5)
        {
            if (config.digi_path > 0)
                sprintf(str, "%s-%d>APE32A-%d::%s:%s ", config.digi_mycall, config.digi_ssid, config.digi_path, call, raw);
            else
                sprintf(str, "%s-%d>APE32A::%s:%s ", config.digi_mycall, config.digi_ssid, call, raw);
        }
        else
        {
            sprintf(str, "%s-%d>APE32A,%s::%s:%s ", config.digi_mycall, config.digi_ssid, getPath(config.digi_path).c_str(), call, raw);
        }
    }

    uint8_t SendMode = 0;
    if (config.digi_loc2rf)
        SendMode |= RF_CHANNEL;
    if (config.digi_loc2inet)
        SendMode |= INET_CHANNEL;
    pkgTxPush(str, strlen(str), 0, SendMode);
    // if (config.digi_loc2rf)
    // { // TLM SEND TO RF
    //     pkgTxPush(str, strlen(str), 0);
    // }
    // if (config.digi_loc2inet)
    // { // TLM SEND TO APRS-IS
    //     if (aprsClient.connected())
    //     {
    //         status.txCount++;
    //         aprsClient.printf("%s\r\n", str); // Send packet to Inet
    //         delay(2000);
    //     }
    // }
}

RTC_DATA_ATTR statusType statOld;
uint8_t getState(int ch)
{
    int val = 0;
    switch (ch)
    {
    case 0: // none
        val = 0;
        break;
    case 1: // allCount
        val = status.allCount - statOld.allCount;
        statOld.allCount = status.allCount;
        break;
    case 2: // rf2inet
        val = status.rf2inet - statOld.rf2inet;
        statOld.rf2inet = status.rf2inet;
        break;
    case 3: // inet2rf
        val = status.inet2rf - statOld.inet2rf;
        statOld.inet2rf = status.inet2rf;
        break;
    case 4: // digi
        val = status.digiCount - statOld.digiCount;
        statOld.digiCount = status.digiCount;
        break;
    case 5: // Drop
        val = status.dropCount - statOld.dropCount;
        statOld.dropCount = status.dropCount;
        break;
    }
    if (val < 0)
        val = 0;
    return val;
}

bool getBits(int ch)
{
    bool val = false;
    switch (ch)
    {
    case 0: // none
        val = 0;
        break;
    case 1: // IGATE Enable
        val = config.igate_en;
        break;
    case 2: // DIGI Enable
        val = config.digi_en;
        break;
    case 3: // WX Enable
        val = config.wx_en;
        break;
    case 4: // Sat Enable
        val = 0;
        break;
    case 5: // APRS-IS Status
        if (aprsClient.connected())
            val = 1;
        break;
    case 6: // VPN Status
        val = wireguard_active();
        break;
    case 7: // 4G LTE
        val = 0;
        break;
    case 8: // FX.25
        val = (config.fx25_mode > 0) ? 1 : 0;
        break;
    }
    return val;
}

void getTelemetry_0()
{
    systemTLM.A1 = getState(config.tml0_data_channel[0]);
    systemTLM.A2 = getState(config.tml0_data_channel[1]);
    systemTLM.A3 = getState(config.tml0_data_channel[2]);
    systemTLM.A4 = getState(config.tml0_data_channel[3]);
    systemTLM.A5 = getState(config.tml0_data_channel[4]);
    systemTLM.BITS = 0;
    if (getBits(config.tml0_data_channel[5]))
        systemTLM.BITS |= 0x01;
    if (getBits(config.tml0_data_channel[6]))
        systemTLM.BITS |= 0x02;
    if (getBits(config.tml0_data_channel[7]))
        systemTLM.BITS |= 0x04;
    if (getBits(config.tml0_data_channel[8]))
        systemTLM.BITS |= 0x08;
    if (getBits(config.tml0_data_channel[9]))
        systemTLM.BITS |= 0x10;
    if (getBits(config.tml0_data_channel[10]))
        systemTLM.BITS |= 0x20;
    if (getBits(config.tml0_data_channel[11]))
        systemTLM.BITS |= 0x40;
    if (getBits(config.tml0_data_channel[12]))
        systemTLM.BITS |= 0x80;
}

String getPath(int idx)
{
    String ret = "";
    switch (idx)
    {
    case 0: // OFF
        ret = "";
        break;
    case 1: // DST-TRACE1
    case 2: // DST-TRACE2
    case 3: // DST-TRACE3
    case 4: // DST-TRACE4
        ret = "DST" + String(idx);
        break;
    case 5: // TRACE1-1
        ret = "TRACE1-1";
        break;
    case 6:
        ret = "TRACE2-2";
        break;
    case 7:
        ret = "TRACE3-3";
        break;
    case 8:
        ret = "WIDE1-1";
        break;
    case 9:
        ret = "RFONLY";
        break;
    case 10:
        ret = "RELAY";
        break;
    case 11:
        ret = "GATE";
        break;
    case 12:
        ret = "ECHO";
        break;
    case 13: // UserDefine1
        ret = String(config.path[0]);
        break;
    case 14: // UserDefine2
        ret = String(config.path[1]);
        break;
    case 15: // UserDefine3
        ret = String(config.path[2]);
        break;
    case 16: // UserDefine4
        ret = String(config.path[3]);
        break;
    default:
        ret = "WIDE1-1";
        break;
    }
    return ret;
}

void GPS_INIT()
{
    // SerialGPS.begin(config.gnss_baudrate, SERIAL_8N1, config.gnss_rx_gpio, config.gnss_tx_gpio);
    //  SerialGPS.begin(config.gnss_baudrate, EspSoftwareSerial::SWSERIAL_8N1, config.gnss_rx_gpio, config.gnss_tx_gpio);
    // SerialGPS.flush();
    //  while (SerialGPS.available() > 0)
    //      SerialGPS.read();
}

WiFiClient gnssClient;
// WiFiClient tncClient;

extern AsyncWebSocket ws_gnss;
unsigned long gnssTimeInterval = 0;

void taskGPS(void *pvParameters)
{
    int c;
    log_d("GNSS Init");
    nmea_idx = 0;

    if (config.gnss_enable)
    {
        if ((config.gnss_channel > 0) && (config.gnss_channel < 4))
        {
            if (strstr("AT", config.gnss_at_command) != NULL)
            {
                if (config.gnss_channel == 1)
                {
                    Serial0.println(config.gnss_at_command);
                }
                else if (config.gnss_channel == 2)
                {
                    Serial1.println(config.gnss_at_command);
                }
                else if (config.gnss_channel == 3)
                {
                    // Serial2.println(config.gnss_at_command);
                }
            }
        }
    }
    for (;;)
    {
        timerGPS = micros() - timerGPS_old;
        vTaskDelay(10 / portTICK_PERIOD_MS);
        timerGPS_old = micros();

        if (config.gnss_enable)
        {
            if ((config.gnss_channel > 0) && (config.gnss_channel < 4))
            {
                do
                {
                    c = -1;
                    if (config.gnss_channel == 1)
                    {
                        if (Serial0.available()) c = Serial0.read();
                    }
                    else if (config.gnss_channel == 2)
                    {
                        if (Serial1.available()) c = Serial1.read();
                    }
#if SOC_UART_NUM > 2
                    else if (config.gnss_channel == 3)
                    {
                        if (Serial2.available()) c = Serial2.read();
                    }
#endif
                    if (c > -1)
                    {
                        gps.encode((char)c);
                        if (webServiceBegin == false)
                        {
                            if (nmea_idx > 99)
                            {
                                nmea_idx = 0;
                                memset(nmea, 0, sizeof(nmea));
                                // SerialGNSS->flush();
                            }
                            else
                            {
                                nmea[nmea_idx++] = (char)c;
                                if ((char)c == '\r' || (char)c == '\n')
                                {
                                    // nmea[nmea_idx] = 0;
                                    if (nmea_idx > 10)
                                    {
                                        // if (webServiceBegin == false)
                                        if (ws_gnss.enabled() && !ws_gnss.getClients().isEmpty())
                                        {
                                            // if (ws_gnss.availableForWriteAll())
                                            {
                                                handle_ws_gnss(nmea, nmea_idx);
                                            }
                                        }
                                        // log_d("[%d]:%s",nmea_idx,nmea);
                                    }
                                    nmea_idx = 0;
                                    memset(nmea, 0, sizeof(nmea));
                                    vTaskDelay(1 / portTICK_PERIOD_MS);
                                    break;
                                }
                            }
                        }
                        //}
                    }
                    else
                    {
                        break;
                    }
                } while (1);
            }
            else if (config.gnss_channel == 4)
            { // TCP
                if (WiFi.isConnected())
                {
                    if (!gnssClient.connected())
                    {
                        IPAddress ip;
                        ip.fromString(config.gnss_tcp_host);
                        gnssClient.connect(ip, config.gnss_tcp_port, 5000);
                        log_d("GNSS TCP ReConnect to %s:%d", config.gnss_tcp_host, config.gnss_tcp_port);
                        delay(5000);
                    }
                    else
                    {
                        while (gnssClient.available())
                        {
                            c = (char)gnssClient.read();
                            // Serial.print(c);
                            gps.encode(c);
                            if (webServiceBegin == false)
                            {
                                if (nmea_idx > 99)
                                {
                                    nmea_idx = 0;
                                    memset(nmea, 0, sizeof(nmea));
                                }
                                else
                                {
                                    nmea[nmea_idx++] = c;
                                    if (c == '\r' || c == '\n')
                                    {
                                        // nmea[nmea_idx] = 0;
                                        if (nmea_idx > 10)
                                        {
                                            // if (webServiceBegin == false)
                                            if (ws_gnss.enabled() && !ws_gnss.getClients().isEmpty())
                                            {
                                                handle_ws_gnss(nmea, nmea_idx);
                                            }
                                            // log_d("%s",nmea);
                                        }
                                        nmea_idx = 0;
                                        memset(nmea, 0, sizeof(nmea));
                                    }
                                }
                            }
                        }
                    }
                }
            }

            if (gps.time.isValid())
            {
                if (gps.time.isUpdated())
                {
                    if (gnssTimeInterval > millis())
                    {
                        gnssTimeInterval = millis() + 10000;
                        time_t nowTime;
                        time_t timeGps = getGpsTime(); // Local gps time
                        time(&nowTime);
                        int tdiff = abs(timeGps - nowTime);
                        if (timeGps > 1700000000 && tdiff > 2) // && timeGps < 2347462800)
                        {
                            setTime(timeGps);
                            time_t rtc = timeGps - (config.timeZone * SECS_PER_HOUR);
                            timeval tv = {rtc, 0};
                            timezone tz = {static_cast<int>(config.timeZone * SECS_PER_HOUR), 0};
                            settimeofday(&tv, &tz);
                            log_d("\nSET GPS Timestamp = %u Year=%d\n", timeGps, year());
                            // firstGpsTime = false;
                            firstGpsTime = false;
                            if (startTime == 0)
                                startTime = timeGps;
                        }
                        // else
                        // {
                        //     startTime = 0;
                        // }
                    }
                }
            }
        }
    }
}

void taskSerial(void *pvParameters)
{
    String raw;
    int c;
    char rawP[500];
    char call[11];
    log_d("Serial task Init");
    nmea_idx = 0;
    if (config.ext_tnc_enable)
    {
        if (config.ext_tnc_channel == 1)
        {

#if ARDUINO_USB_MODE
            Serial.setTimeout(10);
#endif
        }
        else if (config.ext_tnc_channel == 2)
        {
            Serial1.setTimeout(10);
        }
        else if (config.ext_tnc_channel == 3)
        {
            // Serial2.setTimeout(10);
        }
    }
    if (config.wx_en)
    {
        //         if (config.wx_channel == 1)
        //         {
        // #if ARDUINO_USB_CDC_ON_BOOT
        //             Serial0.setTimeout(10);
        // #else
        //             Serial.setTimeout(10);
        // #endif
        //         }
        //         else if (config.wx_channel == 2)
        //         {
        //             Serial1.setTimeout(10);
        //         }
        //         else if (config.wx_channel == 3)
        //         {
        //             // Serial2.setTimeout(10);
        //         }
    }
    for (;;)
    {
        timerSerial = millis() - timerSerial_old;
        vTaskDelay(10 / portTICK_PERIOD_MS);
        timerSerial_old = micros();

        if (config.wx_en)
        {
            //             if (config.wx_channel > 0 && config.wx_channel < 4)
            //             {
            //                 String wx = "";
            //                 if (config.wx_channel == 1)
            //                 {
            // #if ARDUINO_USB_CDC_ON_BOOT
            //                     wx = Serial.readString();
            // #else
            //                     wx = Serial.readString();
            // #endif
            //                 }
            //                 else if (config.wx_channel == 2)
            //                 {
            //                     wx = Serial1.readString();
            //                 }
            //                 else if (config.wx_channel == 3)
            //                 {
            //                     // wx = Serial2.readString();
            //                 }
            //                 // if (wx!="")
            //                 //{
            //                 // while (SerialWX->available())
            //                 //{
            //                 // String wx = SerialWX->readString();
            //                 if (wx != "" && wx.indexOf("DATA:") >= 0)
            //                 {
            //                     log_d("WX Raw >> %d", wx.c_str());
            //                     getCSV2Wx(wx);
            //                 }
            //                 //}
            //                 //}
            //             }
            // else if(config.wx_channel == 4){
            //     bool result=getM702Modbus(modbus);
            // }
        }

        if (config.ext_tnc_enable && (config.ext_tnc_mode > 0 && config.ext_tnc_mode < 5))
        {
            if (config.ext_tnc_mode == 1)
            { // KISS
                // KISS MODE
                do
                {
                    c = -1;
                    if (config.ext_tnc_channel == 1)
                    {
                        if (Serial0.available()) c = Serial0.read();
                    }
                    else if (config.ext_tnc_channel == 2)
                    {
                        if (Serial1.available()) c = Serial1.read();
                    }
#if SOC_UART_NUM > 2
                    else if (config.ext_tnc_channel == 3)
                    {
                        if (Serial2.available()) c = Serial2.read();
                    }
#endif
                    else if (config.ext_tnc_channel == 4)
                    {
                        if (Serial.available()) c = Serial.read();
                    }

                    if (c > -1)
                        kiss_serial((uint8_t)c);
                    else
                        break;
                } while (c > -1);
            }
            else if (config.ext_tnc_mode == 2)
            { // TNC2RAW
                raw.clear();
                if (config.ext_tnc_channel == 1)
                {
                    if (Serial0.available())
                        raw = Serial0.readStringUntil(0x0D);
                }
                else if (config.ext_tnc_channel == 2)
                {
                    if (Serial1.available())
                        raw = Serial1.readStringUntil(0x0D);
                }
#if SOC_UART_NUM > 2
                else if (config.ext_tnc_channel == 3)
                {
                    if (Serial2.available())
                        raw = Serial2.readStringUntil(0x0D);
                }
#endif
                else if (config.ext_tnc_channel == 4)
                {
                    if (Serial.available())
                        raw = Serial.readStringUntil(0x0D);
                }

                log_d("Ext TNC2RAW RX:%s", raw.c_str());
                String src_call = raw.substring(0, raw.indexOf('>'));
                if ((src_call != "") && (src_call.length() < 10) && (raw.length() < sizeof(rawP)))
                {
                    memset(call, 0, sizeof(call));
                    strcpy(call, src_call.c_str());
                    strcpy(rawP, raw.c_str());
                    uint16_t type = pkgType((const char *)rawP);
                    pkgListUpdate(call, rawP, type, 1, -1);
                    if (config.rf2inet && aprsClient.connected())
                    {
                        // RF->INET
                        aprsClient.write(&rawP[0], strlen(rawP)); // Send binary frame packet to APRS-IS (aprsc)
                        aprsClient.write("\r\n");                 // Send CR LF the end frame packet
                        status.rf2inet++;
                        // igateTLM.RF2INET++;
                        // igateTLM.RX++;
                    }
                }
            }
            else if (config.ext_tnc_mode == 3)
            { // YAESU FTM-350,FTM-400
                String info = "";
                if (config.ext_tnc_channel == 1)
                {
                    if (Serial0.available())
                        info = Serial0.readStringUntil(0x0D);
                }
                else if (config.ext_tnc_channel == 2)
                {
                    if (Serial1.available())
                        info = Serial1.readStringUntil(0x0D);
                }
#if SOC_UART_NUM > 2
                else if (config.ext_tnc_channel == 3)
                {
                    if (Serial2.available())
                        info = Serial2.readStringUntil(0x0D);
                }
#endif
                else if (config.ext_tnc_channel == 4)
                {
                    if (Serial.available())
                        info = Serial.readStringUntil(0x0D);
                }

                //  log_d("Ext Yaesu Packet >> %s",info.c_str());
                int ed = info.indexOf(" [");
                if (info != "" && ed > 10)
                {
                    raw.clear();
                    raw = info.substring(0, ed);
                    int st = info.indexOf(">:");
                    if (st > ed)
                    {
                        int idx = 0;
                        st += 2;
                        for (int i = 0; i < 5; i++)
                        {
                            if (info.charAt(st + i) == 0x0A || info.charAt(st + i) == 0x0D)
                            {
                                idx++;
                            }
                            else
                            {
                                break;
                            }
                        }
                        st += idx;
                        ed = info.indexOf(0x0D, st + 1);
                        if (ed > info.length())
                            ed = info.length();
                        if (ed > st)
                        {
                            raw += ":" + info.substring(st, ed);

                            String src_call = raw.substring(0, raw.indexOf('>'));
                            if ((src_call != "") && (src_call.length() < 11) && (raw.length() < sizeof(rawP)))
                            {
                                memset(call, 0, sizeof(call));
                                strcpy(call, src_call.c_str());
                                memset(rawP, 0, sizeof(rawP));
                                strcpy(rawP, raw.c_str());
                                log_d("Yaesu Packet: CallSign:%s RAW:%s", call, rawP);
                                // String hstr="";
                                // for(int i=0;i<raw.length();i++){
                                //     hstr+=" "+String(rawP[i],HEX);
                                // }
                                // log_d("HEX: %s",hstr.c_str());
                                uint16_t type = pkgType((const char *)rawP);
                                pkgListUpdate(call, rawP, type, 1, -1);
                                if (config.rf2inet && aprsClient.connected())
                                {
                                    // RF->INET
                                    aprsClient.write(&rawP[0], strlen(rawP)); // Send binary frame packet to APRS-IS (aprsc)
                                    aprsClient.write("\r\n");                 // Send CR LF the end frame packet
                                    status.rf2inet++;
                                    // igateTLM.RF2INET++;
                                    // igateTLM.RX++;
                                }
                            }
                        }
                    }
                }
            }
            //}
        }

        if (config.at_cmd_uart > 0)
        {
            if (config.at_cmd_uart == 1)
            { // UART0
                if (Serial0.available())
                {
                    String cmd = Serial0.readStringUntil('\n');
                    cmd.trim();
                    String ret = handleATCommand(String((char *)cmd.c_str()));
                    if (ret != "")
                        Serial0.println(ret);
                    log_d("AT-Command response: %s", ret.c_str());
                }
            }
            else if (config.at_cmd_uart == 2)
            { // UART1
                if (Serial1.available())
                {
                    String cmd = Serial1.readStringUntil('\n');
                    cmd.trim();
                    String ret = handleATCommand(String((char *)cmd.c_str()));
                    if (ret != "")
                        Serial1.println(ret);
                    log_d("AT-Command response: %s", ret.c_str());
                }
            }
#if SOC_UART_NUM > 2
            else if (config.at_cmd_uart == 3)
            { // UART2
                if (Serial2.available())
                {
                    String cmd = Serial2.readStringUntil('\n');
                    cmd.trim();
                    String ret = handleATCommand(String((char *)cmd.c_str()));
                    if (ret != "")
                        Serial2.println(ret);
                    log_d("AT-Command response: %s", ret.c_str());
                }
            }
#endif
            else if (config.at_cmd_uart == 4)
            { // USB-CDC
                if (Serial.available())
                {
                    String cmd = Serial.readStringUntil('\n');
                    cmd.trim();
                    String ret = handleATCommand(String((char *)cmd.c_str()));
                    if (ret != "")
                        Serial.println(ret);
                    log_d("AT-Command response: %s", ret.c_str());
                }
            }
        }
    }
}

long timeSlot;
unsigned long iGatetickInterval;
unsigned long WxInterval;
bool initInterval = true;
int trkTlmInvCount = 0;
int igateTlmInvCount = 0;
int digiTlmInvCount = 0;
unsigned long msgInterval = 0;
void taskAPRS(void *pvParameters)
{
    //	long start, stop;
    char sts[50];
    unsigned long tickInterval = 0;
    unsigned long DiGiInterval = 0;

    unsigned long igateSTSInterval = 0;
    unsigned long digiSTSInterval = 0;
    unsigned long trkSTSInterval = 0;

    uint16_t type = 0;
    bool newIGatePkg = false;
    bool newDigiPkg = false;
    uint8_t *buf;
    uint16_t size = 0;
    int8_t peak = 0;
    int8_t valley = 0;
    uint8_t signalLevel = 0;
    uint8_t fixed = 0;
    uint16_t mV = 0;

    // PacketBuffer.clean();
    adcEn = 0;
    dacEn = 0;

    APRS_setCallsign(config.aprs_mycall, config.aprs_ssid);
    sendTimer = millis() - (config.igate_interval * 1000) + 30000;
    igateTLM.TeleTimeout = millis() + 60000; // 1Min

    msgInterval = millis() + 30000;
    timeSlot = millis();
    timeAprs = 0;
    tx_interval = config.trk_interval;
    tx_counter = tx_interval - 10;

    initInterval = true;
    AFSKInitAct = true;
    log_d("Task APRS has been start");
    for (;;)
    {

        if (adcEn == 1)
        {
             AFSK_TimerEnable(true);
             adcEn = 0;
        }
        else if (adcEn == -1)
        {
             AFSK_TimerEnable(false);
             adcEn = 0;
        }

        if (dacEn == 1)
        {
            DAC_TimerEnable(true);
            dacEn = 0;
        }
        else if (dacEn == -1)
        {
            DAC_TimerEnable(false);
            dacEn = 0;
        }
        // Deferred PTT off from ModemTransmitStop() ISR.
        // setPtt() calls LED_Status2() → strip->show() (NeoPixel RMT write)
        // which is NOT safe from ISR context — overflows the ISR stack.
        if (pttOff)
        {
            setPtt(false);
            pttOff = false;
            //log_i("[TX-END] PTT released, fifo=%d frames=%u", fifoSampleCount, frameDecodeCount);
        }
        long now = millis();
        // wdtSensorTimer = now;
        // time_t timeStamp;
        // time(&timeStamp);
        if (initInterval)
        {
            tickInterval = WxInterval = DiGiInterval = igateSTSInterval = iGatetickInterval = digiSTSInterval = trkSTSInterval = millis() + 10000;
            systemTLM.ParmTimeout = millis() + 20000;
            systemTLM.TeleTimeout = millis() + 30000;
            initInterval = false;
            tx_interval = config.trk_interval;
            tx_counter = tx_interval - 10;
        }
        timerAPRS = micros() - timerAPRS_old;
        vTaskDelay(10 / portTICK_PERIOD_MS);
        timerAPRS_old = micros();

        if (now > msgInterval)
        {
            msgInterval = millis() + config.msg_interval;
            sendAPRSMessageRetry();
        }

#ifdef BLUETOOTH
#if !defined(CONFIG_IDF_TARGET_ESP32) || defined(CONFIG_IDF_TARGET_ESP32C6)
        if (NuSerial.isConnected())
        {
            if (NuSerial.available())
            {
                log_d("Bluetooth RX Data: %d Byte", NuSerial.available());
                if (config.bt_mode == 1)
                { // TNC2RAW MODE
                    String rxValue = NuSerial.readString();
                    uint8_t SendMode = TNC_CHANNEL;
                    if (config.igate_loc2rf)
                        SendMode |= RF_CHANNEL;
                    if (config.igate_loc2inet)
                        SendMode |= INET_CHANNEL;
                    pkgTxPush(rxValue.c_str(), rxValue.length(), 1, SendMode);
                }
                else if (config.bt_mode == 2)
                {
                    // KISS MODE
                    size_t num = NuSerial.available();
                    for (int i = 0; i < num; i++)
                    {
                        kiss_serial((uint8_t)NuSerial.read());
                    }
                }
                else if (config.bt_mode == 3)
                { // AT COMMAND
                    String cmd = NuSerial.readStringUntil('\n');
                    cmd.trim();
                    String ret = handleATCommand(String((char *)cmd.c_str()));
                    if (ret != "")
                        NuSerial.println(ret);
                    log_d("AT-Command response: %s", ret.c_str());
                }
            }
        }
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
