nakhonthai/ESP32APRS_Audio/src/webservice.cpp

/*
 Name:		ESP32APRS_Audio
 Created:	13-10-2023 14:27:23
 Author:	HS5TQA/Atten
 Github:	https://github.com/nakhonthai
 Facebook:	https://www.facebook.com/atten
 Support IS: host:aprs.nakhonthai.net port:14580 or aprs.hs5tqa.ampr.org:14580
 Support IS monitor: http://aprs.nakhonthai.net:14501 or http://aprs.hs5tqa.ampr.org:14501
*/
#include <Arduino.h>
#include "webservice.h"
#include "base64.hpp"
#include "wireguard_vpn.h"
#include <LibAPRSesp.h>
#include <parse_aprs.h>
#include "jquery_min_js.h"
#include <ESPCPUTemp.h>
#include "esp_wifi.h"
#include "esp_heap_caps.h"
#include <ArduinoJson.h>

extern SemaphoreHandle_t psramMutex;
extern bool psramLock(TickType_t timeout = portMAX_DELAY);
extern void psramUnlock();

extern int offset;

// Helper function to allocate memory with PSRAM support
char *allocateStringMemory(size_t size)
{
	char *ptr = NULL;
#ifdef BOARD_HAS_PSRAM
	// Try to allocate in PSRAM first
	size*=2; // overallocation to reduce fragmentation
	ptr = (char *)ps_calloc(size, sizeof(char));
	if (ptr != NULL)
	{
		memset(ptr, 0, size); // Initialize memory to zero
		return ptr;
	}
	// If PSRAM allocation fails, fall back to regular heap
#endif
	// Regular heap allocation
	ptr = (char *)calloc(size, sizeof(char));
	memset(ptr, 0, size); // Initialize memory to zero
	return ptr;
}

// Helper function to format integers to string using allocateStringMemory
char *intToString(int value)
{
	char *str = allocateStringMemory(12); // Enough for a 32-bit integer + null terminator
	if (str != NULL)
	{
		sprintf(str, "%d", value);
	}
	return str;
}

// Helper function to format floats to string using allocateStringMemory
char *floatToString(float value, int decimals)
{
	char *str = allocateStringMemory(20); // Enough for most float values
	if (str != NULL)
	{
		switch (decimals)
		{
		case 0:
			sprintf(str, "%.0f", value);
			break;
		case 1:
			sprintf(str, "%.1f", value);
			break;
		case 2:
			sprintf(str, "%.2f", value);
			break;
		case 3:
			sprintf(str, "%.3f", value);
			break;
		default:
			sprintf(str, "%.2f", value);
			break;
		}
	}
	return str;
}

// Helper function to convert Arduino String to char* using allocateStringMemory
char *StringToCharPtr(const String &str)
{
	size_t len = str.length() + 1; // +1 for null terminator
	char *charPtr = allocateStringMemory(len);
	if (charPtr != NULL)
	{
		strcpy(charPtr, str.c_str());
	}
	return charPtr;
}

#ifdef PPPOS
#include <PPP.h>
#endif

#ifdef SH1106
#include <Adafruit_SH1106.h>
#else
#include "Adafruit_SSD1306.h"
#endif // SH1106

#define SCREEN_ADDRESS 0x3C

AsyncWebServer async_server(80);
AsyncWebServer async_websocket(81);
AsyncWebSocket ws("/ws");
AsyncWebSocket ws_gnss("/ws_gnss");

#ifdef MQTT
#include <PubSubClient.h>
extern PubSubClient clientMQTT;
#endif

#ifdef PPPOS
extern pppType pppStatus;
#endif

// Create an Event Source on /events
AsyncEventSource lastheard_events("/eventHeard");
AsyncEventSource message_events("/eventMsg");

char *webString;

extern unsigned long waitISRetry;
extern volatile int8_t adcEn;
extern volatile int8_t dacEn;
extern unsigned long upTimeStamp;
extern double VBat;
extern bool VBat_Flag;

#ifdef OLED
#ifdef SH1106
extern Adafruit_SH1106 display;
#else
extern Adafruit_SSD1306 display;
#endif
#elif defined(GUI_LCD)
extern Adafruit_SH1106 display;
#endif // OLED

bool defaultSetting = false;

void saveConfig(AsyncWebServerRequest *request)
{
	String html;
	if (saveConfiguration("/default.cfg", config))
	{
		html = "Setup completed successfully";
		request->send(200, "text/html", html); // send to someones browser when asked
	}
	else
	{
		html = "Save config failed.";
		request->send(501, "text/html", html); // Not Implemented
	}
	html.clear();
}

void serviceHandle()
{
	// server.handleClient();
}

void notFound(AsyncWebServerRequest *request)
{
	request->send(404, "text/plain", "Not found");
}

void handle_logout(AsyncWebServerRequest *request)
{
	char *webString = allocateStringMemory(64); // Small buffer for "Log out"
	if (!webString)
	{
		return; // Memory allocation failed
	}
	strcpy(webString, "Log out");
	request->send(200, "text/html", webString);
	free(webString); // Free the allocated memory
}

void setMainPage(AsyncWebServerRequest *request)
{
	if (!request->authenticate(config.http_username, config.http_password))
	{
		return request->requestAuthentication();
	}

	// Using dynamic memory allocation instead of String
	char *webString = allocateStringMemory(12000); // Initial buffer size, adjust as needed
	if (!webString)
	{
		return; // Memory allocation failed
	}

	strcpy(webString, "<!DOCTYPE html>\n<html lang=\"en\">\n<head>\n");
	strcat(webString, "<meta name=\"robots\" content=\"index\" />\n");
	strcat(webString, "<meta name=\"robots\" content=\"follow\" />\n");
	strcat(webString, "<meta name=\"language\" content=\"English\" />\n");
	strcat(webString, "<meta http-equiv=\"Content-Type\" content=\"text/html; charset=utf-8\" />\n");
	strcat(webString, "<meta name=\"GENERATOR\" content=\"configure 20230924\" />\n");
	strcat(webString, "<meta name=\"Author\" content=\"Mr.Somkiat Nakhonthai (HS5TQA)\" />\n");
	strcat(webString, "<meta name=\"Description\" content=\"Web Embedded Configuration\" />\n");
	strcat(webString, "<meta name=\"KeyWords\" content=\"ESP32,ESP32C3,AFSK,APRS\" />\n");
	strcat(webString, "<meta http-equiv=\"Cache-Control\" content=\"no-cache, no-store, must-revalidate\" />\n");
	strcat(webString, "<meta http-equiv=\"pragma\" content=\"no-cache\" />\n");
	strcat(webString, "<link rel=\"shortcut icon\" href=\"http://aprs.nakhonthai.net/favicon.ico\" type=\"image/x-icon\" />\n");
	strcat(webString, "<meta http-equiv=\"Expires\" content=\"0\" />\n");

	char temp_buffer[512];
	if (strlen(config.host_name) > 0)
	{
		snprintf(temp_buffer, sizeof(temp_buffer), "<title>%s</title>\n", config.host_name);
		strcat(webString, temp_buffer);
	}
	else
	{
		strcat(webString, "<title>ESP32APRS_Audio</title>\n");
	}

	strcat(webString, "<link rel=\"stylesheet\" type=\"text/css\" href=\"style.css\" />\n");
	strcat(webString, "<script src=\"/jquery-3.7.1.js\"></script>\n");
	strcat(webString, "<script type=\"text/javascript\">\n");
	strcat(webString, "function selectTab(evt, tabName) {\n");
	strcat(webString, "var i, tabcontent, tablinks;\n");
	strcat(webString, "tablinks = document.getElementsByClassName(\"nav-tabs\");\n");
	strcat(webString, "for (i = 0; i < tablinks.length; i++) {\n");
	strcat(webString, "tablinks[i].className = tablinks[i].className.replace(\" active\", \"\");\n");
	strcat(webString, "}\n");
	strcat(webString, "\n");
	strcat(webString, "//document.getElementById(tabName).style.display = \"block\";\n");
	strcat(webString, "if (tabName == 'DashBoard') {\n");
	strcat(webString, "$(\"#contentmain\").load(\"/dashboard\");\n");
	strcat(webString, "} else if (tabName == 'Radio') {\n");
	strcat(webString, "$(\"#contentmain\").load(\"/radio\");\n");
	strcat(webString, "} else if (tabName == 'IGATE') {\n");
	strcat(webString, "$(\"#contentmain\").load(\"/igate\");\n");
	strcat(webString, "} else if (tabName == 'DIGI') {\n");
	strcat(webString, "$(\"#contentmain\").load(\"/digi\");\n");
	strcat(webString, "} else if (tabName == 'TRACKER') {\n");
	strcat(webString, "$(\"#contentmain\").load(\"/tracker\");\n");
	strcat(webString, "} else if (tabName == 'WX') {\n");
	strcat(webString, "$(\"#contentmain\").load(\"/wx\");\n");
	strcat(webString, "} else if (tabName == 'TLM') {\n");
	strcat(webString, "$(\"#contentmain\").load(\"/tlm\");\n");
	strcat(webString, "} else if (tabName == 'SENSOR') {\n");
	strcat(webString, "$(\"#contentmain\").load(\"/sensor\");\n");
	strcat(webString, "} else if (tabName == 'VPN') {\n");
	strcat(webString, "$(\"#contentmain\").load(\"/vpn\");\n");
#ifdef MQTT
	strcat(webString, "} else if (tabName == 'MQTT') {\n");
	strcat(webString, "$(\"#contentmain\").load(\"/mqtt\");\n");
#endif
	strcat(webString, "} else if (tabName == 'MSG') {\n");
	strcat(webString, "$(\"#contentmain\").load(\"/msg\");\n");
	strcat(webString, "} else if (tabName == 'WiFi') {\n");
	strcat(webString, "$(\"#contentmain\").load(\"/wireless\");\n");
	strcat(webString, "} else if (tabName == 'MOD') {\n");
	strcat(webString, "$(\"#contentmain\").load(\"/mod\");\n");
	strcat(webString, "} else if (tabName == 'System') {\n");
	strcat(webString, "$(\"#contentmain\").load(\"/system\");\n");
	strcat(webString, "} else if (tabName == 'File') {\n");
	strcat(webString, "$(\"#contentmain\").load(\"/storage\");\n");
	strcat(webString, "} else if (tabName == 'About') {\n");
	strcat(webString, "$(\"#contentmain\").load(\"/about\");\n");
	strcat(webString, "}\n");
	strcat(webString, "\n");
	strcat(webString, "if (evt != null) evt.currentTarget.className += \" active\";\n");
	strcat(webString, "}\n");
	strcat(webString, "if (!!window.EventSource) {");
	strcat(webString, "var source = new EventSource('/eventHeard');");

	strcat(webString, "source.addEventListener('open', function(e) {");
	strcat(webString, "console.log(\"Events Connected\");");
	strcat(webString, "}, false);");
	strcat(webString, "source.addEventListener('error', function(e) {");
	strcat(webString, "if (e.target.readyState != EventSource.OPEN) {");
	strcat(webString, "console.log(\"Events Disconnected\");");
	strcat(webString, "}\n}, false);");
	strcat(webString, "source.addEventListener('lastHeard', function(e) {");
	// strcat(webString, "console.log(\"lastHeard\", e.data);");
	strcat(webString, "var lh=document.getElementById(\"aprsTable\");");
	strcat(webString, "if(lh != null) {renderTable(e.data);}");
	strcat(webString, "}, false);\n}");
	strcat(webString, "if (!!window.EventSource) {");
	strcat(webString, "var source = new EventSource('/eventMsg');");

	strcat(webString, "source.addEventListener('open', function(e) {");
	strcat(webString, "console.log(\"Events MSG Connected\");");
	strcat(webString, "}, false);");
	strcat(webString, "source.addEventListener('error', function(e) {");
	strcat(webString, "if (e.target.readyState != EventSource.OPEN) {");
	strcat(webString, "console.log(\"Events MSG Disconnected\");");
	strcat(webString, "}\n}, false);");
	strcat(webString, "source.addEventListener('chatMsg', function(e) {");
	// strcat(webString, "console.log(\"lastHeard\", e.data);");
	strcat(webString, "var lh=document.getElementById(\"chatMsg\");");
	strcat(webString, "if(lh != null) {lh.innerHTML = e.data;}");
	strcat(webString, "}, false);\n}\n");
	//strcat(webString, "</script>\n");

	strcat(webString, "let sortDirection = {};\n");
	strcat(webString, "let currentSortKey = \"time\";\n\n");
	strcat(webString, "function renderTable(raw) {\n");
	// strcat(webString, "const tableBody = document.getElementById(\"aprsTableBody\");\n");
	// //strcat(webString, "const tableBody = document.querySelector(\"#aprsTable tbody\");\n");
	// strcat(webString, "if(tableBody == null) {return;}\n");
	strcat(webString, "var data=JSON.parse(raw);\n");	
	strcat(webString, "lastHeardSort(data);\n");
	strcat(webString, "document.querySelectorAll(\"#aprsTable th[data-sort]\")\n");
	strcat(webString, ".forEach(header => {\n\n");
	strcat(webString, "header.addEventListener(\"click\", () => {\n\n");
	strcat(webString, "const key = header.dataset.sort;\n\n");
	strcat(webString, "sortDirection[key] = !sortDirection[key];\n");
	strcat(webString, "currentSortKey = key;\n\n");	
	strcat(webString, "clearArrows();\n\n");
	strcat(webString, "const arrowSpan = header.querySelector(\".arrow\");\n");
	strcat(webString, "arrowSpan.textContent = sortDirection[key] ? \"▲\" : \"▼\";\n\n");
	strcat(webString, "lastHeardSort(data);\n");
	strcat(webString, "printLastHeard(data);\n");
	strcat(webString, "});\n\n");
	strcat(webString, "});\n\n");
	strcat(webString, "printLastHeard(data);\n");
	strcat(webString, "}\n\n");

	strcat(webString, "function printLastHeard(data) {\n");
	strcat(webString, "const tableBody = document.getElementById(\"aprsTableBody\");\n");
	//strcat(webString, "const tableBody = document.querySelector(\"#aprsTable tbody\");\n");
	strcat(webString, "if(tableBody == null) {return;}\n");
	strcat(webString, "tableBody.innerHTML = \"\";\n");
	strcat(webString, "data.forEach(row => {\n");
	strcat(webString, "const tr = document.createElement(\"tr\");\n");
	strcat(webString, "tr.innerHTML = `\n");
	strcat(webString, "<td>${row.time}</td>\n");
	strcat(webString, "<td><img src=\"http://aprs.nakhonthai.net/symbols/icons/${row.icon}\"></td>\n");
	strcat(webString, "<td>${row.callsign}</td>\n");
	strcat(webString, "<td align=\"left\">${row.path}</td>\n");
	strcat(webString, "<td>${row.dx !== null ? row.dx : \"-\"}</td>\n");
	strcat(webString, "<td>${row.packet}</td>\n");
	strcat(webString, "<td style=\"color:green;\">${row.audio !== '-' ? row.audio + \"dBV\" : \"-\"}</td>\n");
	strcat(webString, "`;\n");
	strcat(webString, "tableBody.appendChild(tr);\n");
	strcat(webString, "});\n");
	strcat(webString, "}\n\n");

	strcat(webString, "function clearArrows() {\n");
	strcat(webString, "document.querySelectorAll(\".arrow\").forEach(a => a.textContent = \"\");\n");
	strcat(webString, "}\n\n");
	strcat(webString, "function lastHeardSort(data) {\nvar key=currentSortKey;\n");
	strcat(webString, "data.sort((a, b) => {\n\n");
	strcat(webString, "let valA = a[key];\n");
	strcat(webString, "let valB = b[key];\n\n");
	strcat(webString, "if (key === \"time\") {\n");
	//strcat(webString, "// Parse time in dd hh:mm:ss format\n");
	strcat(webString, "const [dayTime, timePart] = valA.split(' ');\n");
	strcat(webString, "const [hours, minutes, seconds] = timePart.split(':');\n");
	strcat(webString, "valA = parseInt(dayTime) * 86400 + parseInt(hours) * 3600 + parseInt(minutes) * 60 + parseInt(seconds);\n");
	//strcat(webString, "                \n");
	strcat(webString, "const [dayTimeB, timePartB] = valB.split(' ');\n");
	strcat(webString, "const [hoursB, minutesB, secondsB] = timePartB.split(':');\n");
	strcat(webString, "valB = parseInt(dayTimeB) * 86400 + parseInt(hoursB) * 3600 + parseInt(minutesB) * 60 + parseInt(secondsB);\n");
	strcat(webString, "}\n\n");
	strcat(webString, "if (valA === null) return 1;\n");
	strcat(webString, "if (valB === null) return -1;\n\n");
	strcat(webString, "if (valA < valB) return sortDirection[key] ? -1 : 1;\n");
	strcat(webString, "if (valA > valB) return sortDirection[key] ? 1 : -1;\n");
	strcat(webString, "return 0;\n");
	strcat(webString, "});\n\n");
	strcat(webString, "}\n\n");
	strcat(webString, "</script>\n");
	strcat(webString, "</head>\n");
	//strcat(webString, "\n");
	strcat(webString, "<body onload=\"selectTab(event, 'DashBoard')\">\n");
	strcat(webString, "\n");
	strcat(webString, "<div class=\"container\">\n");
	strcat(webString, "<div class=\"header\">\n");
	// strcat(webString, "<div style=\"font-size: 8px; text-align: right; padding-right: 8px;\">ESP32IGate Firmware V" + String(VERSION) + "</div>\n");
	// strcat(webString, "<div style=\"font-size: 8px; text-align: right; padding-right: 8px;\"><a href=\"/logout\">[LOG OUT]</a></div>\n");
	if (strlen(config.host_name) > 0)
	{
		snprintf(temp_buffer, sizeof(temp_buffer), "<h1>%s</h1>\n", config.host_name);
		strcat(webString, temp_buffer);
	}
	else
	{
		strcat(webString, "<h1>ESP32APRS_Audio</h1>\n");
	}
	strcat(webString, "<div style=\"font-size: 8px; text-align: right; padding-right: 8px;\"><a href=\"/logout\">[LOG OUT]</a></div>\n");
	strcat(webString, "<div class=\"row\">\n");
	strcat(webString, "<ul class=\"nav nav-tabs\" style=\"margin: 5px;\">\n");
	strcat(webString, "<button class=\"nav-tabs\" onclick=\"selectTab(event, 'DashBoard')\">DashBoard</button>\n");
	strcat(webString, "<button class=\"nav-tabs\" onclick=\"selectTab(event, 'Radio')\" id=\"btnRadio\">Radio</button>\n");
	strcat(webString, "<button class=\"nav-tabs\" onclick=\"selectTab(event, 'IGATE')\">IGATE</button>\n");
	strcat(webString, "<button class=\"nav-tabs\" onclick=\"selectTab(event, 'DIGI')\">DIGI</button>\n");
	strcat(webString, "<button class=\"nav-tabs\" onclick=\"selectTab(event, 'TRACKER')\">TRACKER</button>\n");
	strcat(webString, "<button class=\"nav-tabs\" onclick=\"selectTab(event, 'WX')\">WX</button>\n");
	strcat(webString, "<button class=\"nav-tabs\" onclick=\"selectTab(event, 'TLM')\">TLM</button>\n");
	strcat(webString, "<button class=\"nav-tabs\" onclick=\"selectTab(event, 'SENSOR')\">SENSOR</button>\n");
	strcat(webString, "<button class=\"nav-tabs\" onclick=\"selectTab(event, 'VPN')\">VPN</button>\n");
#ifdef MQTT
	strcat(webString, "<button class=\"nav-tabs\" onclick=\"selectTab(event, 'MQTT')\">MQTT</button>\n");
#endif
	strcat(webString, "<button class=\"nav-tabs\" onclick=\"selectTab(event, 'MSG')\">MSG</button>\n");
	strcat(webString, "<button class=\"nav-tabs\" onclick=\"selectTab(event, 'WiFi')\">WiFi</button>\n");
	strcat(webString, "<button class=\"nav-tabs\" onclick=\"selectTab(event, 'MOD')\">MOD</button>\n");
	strcat(webString, "<button class=\"nav-tabs\" onclick=\"selectTab(event, 'System')\">System</button>\n");
	strcat(webString, "<button class=\"nav-tabs\" onclick=\"selectTab(event, 'File')\">File</button>\n");
	strcat(webString, "<button class=\"nav-tabs\" onclick=\"selectTab(event, 'About')\">About</button>\n");
	strcat(webString, "</ul>\n");
	strcat(webString, "</div>\n");
	strcat(webString, "</div>\n");
	strcat(webString, "\n");

	strcat(webString, "<div class=\"contentwide\" id=\"contentmain\"  style=\"font-size: 2pt;\">\n");
	strcat(webString, "\n");
	strcat(webString, "</div>\n");
	strcat(webString, "<br />\n");
	strcat(webString, "<div class=\"footer\">\n");
	strcat(webString, "ESP32APRS_Audio Web Configuration<br />Copy right ©2023.\n");
	strcat(webString, "<br />\n");
	strcat(webString, "</div>\n");
	strcat(webString, "</div>\n");
	strcat(webString, "<!-- <script type=\"text/javascript\" src=\"/nice-select.min.js\"></script> -->\n");
	strcat(webString, "<script type=\"text/javascript\">\n");
	strcat(webString, "var selectize = document.querySelectorAll('select')\n");
	strcat(webString, "var options = { searchable: true };\n");
	strcat(webString, "selectize.forEach(function (select) {\n");
	strcat(webString, "if (select.length > 30 && null === select.onchange && !select.name.includes(\"ExtendedId\")) {\n");
	strcat(webString, "select.classList.add(\"small\", \"selectize\");\n");
	strcat(webString, "tabletd = select.closest('td');\n");
	strcat(webString, "tabletd.style.cssText = 'overflow-x:unset';\n");
	strcat(webString, "NiceSelect.bind(select, options);\n");
	strcat(webString, "}\n");
	strcat(webString, "});\n");
	strcat(webString, "</script>\n");
	strcat(webString, "</body>\n");
	strcat(webString, "</html>");


	AsyncWebServerResponse *response = request->beginResponse(200, "text/html", (const char *)webString);
	response->addHeader("Sensor", "content");
	response->addHeader("Cache-Control", "no-cache");
	request->send(response);
	free(webString);
	lastHeardTimeout = 0;
	lastHeard_Flag = true;
}

////////////////////////////////////////////////////////////
// handler for web server request: http://IpAddress/      //
////////////////////////////////////////////////////////////

void handle_css(AsyncWebServerRequest *request)
{
	const char *css = ".container{width:900px;text-align:left;margin:auto;border-radius:10px 10px 10px 10px;-moz-border-radius:10px 10px 10px 10px;-webkit-border-radius:10px 10px 10px 10px;-khtml-border-radius:10px 10px 10px 10px;-ms-border-radius:10px 10px 10px 10px;box-shadow:3px 3px 3px #707070;background:#fff;border-color: #2194ec;padding: 0px;border-width: 5px;border-style:solid;}body,font{font:12px verdana,arial,sans-serif;color:#fff}.header{background:#2194ec;text-decoration:none;color:#fff;font-family:verdana,arial,sans-serif;text-align:left;padding:5px 0;border-radius:10px 10px 0 0;-moz-border-radius:10px 10px 0 0;-webkit-border-radius:10px 10px 0 0;-khtml-border-radius:10px 10px 0 0;-ms-border-radius:10px 10px 0 0}.content{margin:0 0 0 166px;padding:1px 5px 5px;color:#000;background:#fff;text-align:center;font-size: 8pt;}.contentwide{padding:50px 5px 5px;color:#000;background:#fff;text-align:center}.contentwide h2{color:#000;font:1em verdana,arial,sans-serif;text-align:center;font-weight:700;padding:0;margin:0;font-size: 12pt;}.footer{background:#2194ec;text-decoration:none;color:#fff;font-family:verdana,arial,sans-serif;font-size:9px;text-align:center;padding:10px 0;border-radius:0 0 10px 10px;-moz-border-radius:0 0 10px 10px;-webkit-border-radius:0 0 10px 10px;-khtml-border-radius:0 0 10px 10px;-ms-border-radius:0 0 10px 10px;clear:both}#tail{height:450px;width:805px;overflow-y:scroll;overflow-x:scroll;color:#0f0;background:#000}table{vertical-align:middle;text-align:center;empty-cells:show;padding-left:3;padding-right:3;padding-top:3;padding-bottom:3;border-collapse:collapse;border-color:#0f07f2;border-style:solid;border-spacing:0px;border-width:3px;text-decoration:none;color:#fff;background:#000;font-family:verdana,arial,sans-serif;font-size : 12px;width:100%;white-space:nowrap}table th{cursor: pointer;user-select: none;font-size: 10pt;font-family:lucidia console,Monaco,monospace;text-shadow:1px 1px #0e038c;text-decoration:none;background:#0525f7;border:1px solid silver}table tr:nth-child(even){background:#f7f7f7}table tr:nth-child(odd){background:#eeeeee}table td{color:#000;font-family:lucidia console,Monaco,monospace;text-decoration:none;border:1px solid #010369}body{background:#edf0f5;color:#000}a{text-decoration:none}a:link,a:visited{text-decoration:none;color:#0000e0;font-weight:400}th:last-child a.tooltip:hover span{left:auto;right:0}ul{padding:5px;margin:10px 0;list-style:none;float:left}ul li{float:left;display:inline;margin:0 10px}ul li a{text-decoration:none;float:left;color:#999;cursor:pointer;font:900 14px/22px arial,Helvetica,sans-serif}ul li a span{margin:0 10px 0 -10px;padding:1px 8px 5px 18px;position:relative;float:left}h1{text-shadow:2px 2px #303030;text-align:center}.toggle{position:absolute;margin-left:-9999px;visibility:hidden}.toggle+label{display:block;position:relative;cursor:pointer;outline:none}input.toggle-round-flat+label{padding:1px;width:33px;height:18px;background-color:#ddd;border-radius:10px;transition:background .4s}input.toggle-round-flat+label:before,input.toggle-round-flat+label:after{display:block;position:absolute;}input.toggle-round-flat+label:before{top:1px;left:1px;bottom:1px;right:1px;background-color:#fff;border-radius:10px;transition:background .4s}input.toggle-round-flat+label:after{top:2px;left:2px;bottom:2px;width:16px;background-color:#ddd;border-radius:12px;transition:margin .4s,background .4s}input.toggle-round-flat:checked+label{background-color:#dd4b39}input.toggle-round-flat:checked+label:after{margin-left:14px;background-color:#dd4b39}@-moz-document url-prefix(){select,input{margin:0;padding:0;border-width:1px;font:12px verdana,arial,sans-serif}input[type=button],button,input[type=submit]{padding:0 3px;border-radius:3px 3px 3px 3px;-moz-border-radius:3px 3px 3px 3px}}.nice-select.small,.nice-select-dropdown li.option{height:24px!important;min-height:24px!important;line-height:24px!important}.nice-select.small ul li:nth-of-type(2){clear:both}.nav{margin-bottom:0;padding-left:10;list-style:none}.nav>li{position:relative;display:block}.nav>li>a{position:relative;display:block;padding:5px 10px}.nav>li>a:hover,.nav>li>a:focus{text-decoration:none;background-color:#eee}.nav>li.disabled>a{color:#999}.nav>li.disabled>a:hover,.nav>li.disabled>a:focus{color:#999;text-decoration:none;background-color:initial;cursor:not-allowed}.nav .open>a,.nav .open>a:hover,.nav .open>a:focus{background-color:#eee;border-color:#428bca}.nav .nav-divider{height:1px;margin:9px 0;overflow:hidden;background-color:#e5e5e5}.nav>li>a>img{max-width:none}.nav-tabs{border-bottom:1px solid #ddd}.nav-tabs>li{float:left;margin-bottom:-1px}.nav-tabs>li>a{margin-right:0;line-height:1.42857143;border:1px solid #ddd;border-radius:10px 10px 0 0}.nav-tabs>li>a:hover{border-color:#eee #eee #ddd}.nav-tabs>button{margin-right:0;line-height:1.42857143;border:2px solid #ddd;border-radius:10px 10px 0 0}.nav-tabs>button:hover{background-color:#25bbfc;border-color:#428bca;color:#eaf2f9;border-bottom-color:transparent;}.nav-tabs>button.active,.nav-tabs>button.active:hover,.nav-tabs>button.active:focus{color:#f7fdfd;background-color:#1aae0d;border:1px solid #ddd;border-bottom-color:transparent;cursor:default}.nav-tabs>li.active>a,.nav-tabs>li.active>a:hover,.nav-tabs>li.active>a:focus{color:#428bca;background-color:#e5e5e5;border:1px solid #ddd;border-bottom-color:transparent;cursor:default}.nav-tabs.nav-justified{width:100%;border-bottom:0}.nav-tabs.nav-justified>li{float:none}.nav-tabs.nav-justified>li>a{text-align:center;margin-bottom:5px}.nav-tabs.nav-justified>.dropdown .dropdown-menu{top:auto;left:auto}.nav-status{float:left;margin:0;padding:3px;width:160px;font-weight:400;min-height:600}#bar,#prgbar {background-color: #f1f1f1;border-radius: 14px}#bar {background-color: #3498db;width: 0%;height: 14px}.switch{position:relative;display:inline-block;width:34px;height:16px}.switch input{opacity:0;width:0;height:0}.slider{position:absolute;cursor:pointer;top:0;left:0;right:0;bottom:0;background-color:#f55959;-webkit-transition:.4s;transition:.4s}.slider:before{position:absolute;content:\"\";height:12px;width:12px;left:2px;bottom:2px;background-color:#fff;-webkit-transition:.4s;transition:.4s}input:checked+.slider{background-color:#5ca30a}input:focus+.slider{box-shadow:0 0 1px #5ca30a}input:checked+.slider:before{-webkit-transform:translateX(16px);-ms-transform:translateX(16px);transform:translateX(16px)}.slider.round{border-radius:34px}.slider.round:before{border-radius:50%}.button{border:1px solid #06c;background-color:#09c;color:#fff;padding:5px 10px;border-radius: 3px}.button:hover{border:1px solid #09c;background-color:#0ac;color:#fff}.button:disabled,button[disabled]{border:1px solid #999;background-color:#ccc;color:#666}.arrow {margin-left: 5px;font-size: 12px;}\n";
	request->send_P(200, "text/css", css);
}

void handle_jquery(AsyncWebServerRequest *request)
{
#if defined(CONFIG_IDF_TARGET_ESP32)
	adcEn = -1;
	dacEn = -1;
	delay(100);
#endif
	AsyncWebServerResponse *response = request->beginResponse_P(200, "application/javascript", (const uint8_t *)jquery_3_7_1_min_js_gz, jquery_3_7_1_min_js_gz_len);
	response->addHeader("Content-Encoding", "gzip");
	response->addHeader("Cache-Control", "no-cache");
	response->setContentLength(jquery_3_7_1_min_js_gz_len);
	request->send(response);
#if defined(CONFIG_IDF_TARGET_ESP32)
	delay(200);
	adcEn = 1;
	dacEn = 0;
#endif
}

void handle_dashboard(AsyncWebServerRequest *request)
{
	char temp_buffer[200];
	// if (!request->authenticate(config.http_username, config.http_password))
	// {
	// 	return request->requestAuthentication();
	// }
	StandByTick = millis() + (config.pwr_stanby_delay * 1000);

	// Using dynamic memory allocation instead of String
	char *webString = allocateStringMemory(4096); // Initial buffer size, adjust as needed
	if (!webString)
	{
		return; // Memory allocation failed
	}

	strcpy(webString, "<script type=\"text/javascript\">\n");
	strcat(webString, "function reloadSysInfo() {\n");
	strcat(webString, "$(\"#sysInfo\").load(\"/sysinfo\", function () { setTimeout(reloadSysInfo, 60000) });\n");
	strcat(webString, "}\n");
	strcat(webString, "setTimeout(reloadSysInfo(), 100);\n");
	strcat(webString, "function reloadSidebarInfo() {\n");
	strcat(webString, "$(\"#sidebarInfo\").load(\"/sidebarInfo\", function () { setTimeout(reloadSidebarInfo, 10000) });\n");
	strcat(webString, "}\n");
	strcat(webString, "setTimeout(reloadSidebarInfo, 1000);\n");
	strcat(webString, "$(window).trigger('resize');\n");

	strcat(webString, "</script>\n");

	//strcat(webString, "<script>\n");
	// strcat(webString, "let aprsData = [\n");
	// strcat(webString, "  { time: \"21:54:23\", icon: \"91-1.png\", callsign: \"HS5TQA-7\", path: \"RF: WIDE1-1\", dx: 0.0, packet: 2, audio: -19.6 },\n");
	// strcat(webString, "  { time: \"22:13:33\", icon: \"66-1.png\", callsign: \"HS5TQA-3\", path: \"RF: DIRECT\", dx: null, packet: 9, audio: -14.1 }\n");
	// strcat(webString, "];\n\n");
	// strcat(webString, "const tableBody = document.querySelector(\"#aprsTable tbody\");\n");
	// strcat(webString, "let sortDirection = {};\n");
	// strcat(webString, "let currentSortKey = null;\n\n");
	// strcat(webString, "function renderTable(data) {\n");
	// strcat(webString, "    tableBody.innerHTML = \"\";\n");
	// strcat(webString, "    data.forEach(row => {\n");
	// strcat(webString, "        const tr = document.createElement(\"tr\");\n");
	// strcat(webString, "        tr.innerHTML = `\n");
	// strcat(webString, "            <td>${row.time}</td>\n");
	// strcat(webString, "            <td><img src=\\\"http://aprs.nakhonthai.net/symbols/icons/${row.icon}\\\"></td>\n");
	// strcat(webString, "            <td>${row.callsign}</td>\n");
	// strcat(webString, "            <td>${row.path}</td>\n");
	// strcat(webString, "            <td>${row.dx !== null ? row.dx + \\\" km\\\" : \\\"-\\\"}</td>\n");
	// strcat(webString, "            <td>${row.packet}</td>\n");
	// strcat(webString, "            <td style=\\\"color:green;\\\">${row.audio !== null ? row.audio + \\\" dBV\\\" : \\\"-\\\"}</td>\n");
	// strcat(webString, "        `;\n");
	// strcat(webString, "        tableBody.appendChild(tr);\n");
	// strcat(webString, "    });\n");
	// strcat(webString, "}\n\n");
	// strcat(webString, "function clearArrows() {\n");
	// strcat(webString, "    document.querySelectorAll(\\\".arrow\\\").forEach(a => a.textContent = \\\"\\\");\n");
	// strcat(webString, "}\n\n");
	// strcat(webString, "document.querySelectorAll(\\\"#aprsTable th[data-sort]\\\")\n");
	// strcat(webString, ".forEach(header => {\n\n");
	// strcat(webString, "    header.addEventListener(\\\"click\\\", () => {\n\n");
	// strcat(webString, "        const key = header.dataset.sort;\n\n");
	// strcat(webString, "        sortDirection[key] = !sortDirection[key];\n");
	// strcat(webString, "        currentSortKey = key;\n\n");
	// strcat(webString, "        aprsData.sort((a, b) => {\n\n");
	// strcat(webString, "            let valA = a[key];\n");
	// strcat(webString, "            let valB = b[key];\n\n");
	// strcat(webString, "            if (key === \\\"time\\\") {\n");
	// strcat(webString, "                valA = new Date(\\\"1970-01-01T\\\" + valA);\n");
	// strcat(webString, "                valB = new Date(\\\"1970-01-01T\\\" + valB);\n");
	// strcat(webString, "            }\n\n");
	// strcat(webString, "            if (valA === null) return 1;\n");
	// strcat(webString, "            if (valB === null) return -1;\n\n");
	// strcat(webString, "            if (valA < valB) return sortDirection[key] ? -1 : 1;\n");
	// strcat(webString, "            if (valA > valB) return sortDirection[key] ? 1 : -1;\n");
	// strcat(webString, "            return 0;\n");
	// strcat(webString, "        });\n\n");
	// strcat(webString, "        clearArrows();\n\n");
	// strcat(webString, "        const arrowSpan = header.querySelector(\\\".arrow\\\");\n");
	// strcat(webString, "        arrowSpan.textContent = sortDirection[key] ? \\\"▲\\\" : \\\"▼\\\";\n\n");
	// strcat(webString, "        renderTable(aprsData);\n");
	// strcat(webString, "    });\n\n");
	// strcat(webString, "});\n\n");
	// strcat(webString, "renderTable(aprsData);\n");
	// strcat(webString, "</script>\n");


	strcat(webString, "<div id=\"sysInfo\">\n");
	strcat(webString, "</div>\n");

	strcat(webString, "<br />\n");
	strcat(webString, "<div class=\"nav-status\">\n");
	strcat(webString, "<div id=\"sidebarInfo\">\n");
	strcat(webString, "</div>\n");
	strcat(webString, "<br />\n");

	strcat(webString, "<table>\n");
	strcat(webString, "<tr>\n");
	strcat(webString, "<th colspan=\"2\">Radio Info</th>\n");
	strcat(webString, "</tr>\n");
	if (config.rf_en)
	{
		strcat(webString, "<tr>\n");
		strcat(webString, "<td>Freq.TX</td>\n");

		snprintf(temp_buffer, sizeof(temp_buffer), "<td style=\"background: #ffffff;\">%.4f MHz</td>\n", config.freq_tx);
		strcat(webString, temp_buffer);

		strcat(webString, "</tr>\n");
		strcat(webString, "<tr>\n");
		strcat(webString, "<td>Freq.RX</td>\n");

		snprintf(temp_buffer, sizeof(temp_buffer), "<td style=\"background: #ffffff;\">%.4f MHz</td>\n", config.freq_rx);
		strcat(webString, temp_buffer);

		strcat(webString, "</tr>\n");
		strcat(webString, "<tr>\n");
		strcat(webString, "<td>TX PWR</td>\n");
		if (config.rf_power)
			strcat(webString, "<td>HIGH</td>\n");
		else
			strcat(webString, "<td>LOW</td>\n");
		strcat(webString, "</tr>\n");
	}
	strcat(webString, "<tr>\n");
	strcat(webString, "<td>MODEM</td>\n");

	
	snprintf(temp_buffer, sizeof(temp_buffer), "<td style=\"background: #ffffff;\">%s</td>\n", MODEM_TYPE[config.modem_type]);
	strcat(webString, temp_buffer);

	strcat(webString, "</tr>\n");
	strcat(webString, "<tr>\n");
	strcat(webString, "<td>FX.25</td>\n");

	snprintf(temp_buffer, sizeof(temp_buffer), "<td style=\"background: #ffffff;\">%s</td>\n", FX25_MODE[config.fx25_mode]);
	strcat(webString, temp_buffer);

	strcat(webString, "</tr>\n");
	strcat(webString, "</table>\n");
	strcat(webString, "\n");
	if (config.igate_en)
	{
		strcat(webString, "<br />\n");
		strcat(webString, "<table>\n");
		strcat(webString, "<tr>\n");
		strcat(webString, "<th colspan=\"2\">APRS-IS SERVER</th>\n");
		strcat(webString, "</tr>\n");
		strcat(webString, "<tr>\n");
		strcat(webString, "<td>HOST</td>\n");

		snprintf(temp_buffer, sizeof(temp_buffer), "<td style=\"background: #ffffff;\">%s</td>\n", config.aprs_host);
		strcat(webString, temp_buffer);

		strcat(webString, "</tr>\n");
		strcat(webString, "<tr>\n");
		strcat(webString, "<td>PORT</td>\n");

		snprintf(temp_buffer, sizeof(temp_buffer), "<td style=\"background: #ffffff;\">%d</td>\n", config.aprs_port);
		strcat(webString, temp_buffer);

		strcat(webString, "</tr>\n");
		strcat(webString, "</table>\n");
	}
	strcat(webString, "<br />\n");
	strcat(webString, "<table>\n");
	strcat(webString, "<tr>\n");
	strcat(webString, "<th colspan=\"2\">WiFi</th>\n");
	strcat(webString, "</tr>\n");
	strcat(webString, "<tr>\n");
	strcat(webString, "<td>MODE</td>\n");
	const char *strWiFiMode = "OFF";
	if (config.wifi_mode == WIFI_STA_FIX)
	{
		strWiFiMode = "STA";
	}
	else if (config.wifi_mode == WIFI_AP_FIX)
	{
		strWiFiMode = "AP";
	}
	else if (config.wifi_mode == WIFI_AP_STA_FIX)
	{
		strWiFiMode = "AP+STA";
	}

	snprintf(temp_buffer, sizeof(temp_buffer), "<td style=\"background: #ffffff;\">%s</td>\n", strWiFiMode);
	strcat(webString, temp_buffer);

	strcat(webString, "</tr>\n");
	strcat(webString, "<tr>\n");
	strcat(webString, "<td>SSID</td>\n");

	snprintf(temp_buffer, sizeof(temp_buffer), "<td style=\"background: #ffffff;\">%s</td>\n", WiFi.SSID().c_str());
	strcat(webString, temp_buffer);

	strcat(webString, "</tr>\n");
	strcat(webString, "<tr>\n");
	strcat(webString, "<td>RSSI</td>\n");
	if (WiFi.isConnected())
	{
		snprintf(temp_buffer, sizeof(temp_buffer), "<td style=\"background: #ffffff;\">%d dBm</td>\n", WiFi.RSSI());
		strcat(webString, temp_buffer);
	}
	else
		strcat(webString, "<td style=\"background:#606060; color:#b0b0b0;\" aria-disabled=\"true\">Disconnect</td>\n");
	strcat(webString, "</tr>\n");
	strcat(webString, "</table>\n");
	strcat(webString, "<br />\n");
#ifdef BLUETOOTH
	strcat(webString, "<table>\n");
	strcat(webString, "<tr>\n");

	strcat(webString, "<th colspan=\"2\">Bluetooth</th>\n");
	strcat(webString, "</tr>\n");
	strcat(webString, "<td>Master</td>\n");
	if (config.bt_master)
		strcat(webString, "<td style=\"background:#0b0; color:#030; width:50%;\">Enabled</td>\n");
	else
		strcat(webString, "<td style=\"background:#606060; color:#b0b0b0;\" aria-disabled=\"true\">Disabled</td>\n");
	strcat(webString, "</tr>\n");
	strcat(webString, "<tr>\n");
	strcat(webString, "<tr>\n");
	strcat(webString, "<td>NAME</td>\n");

	snprintf(temp_buffer, sizeof(temp_buffer), "<td style=\"background: #ffffff;\">%s</td>\n", config.bt_name);
	strcat(webString, temp_buffer);

	strcat(webString, "</tr>\n");
	strcat(webString, "<tr>\n");
	strcat(webString, "<tr>\n");
	strcat(webString, "<td>MODE</td>\n");
	const char *btMode = "";
	if (config.bt_mode == 1)
	{
		btMode = "TNC2";
	}
	else if (config.bt_mode == 2)
	{
		btMode = "KISS";
	}
	else
	{
		btMode = "NONE";
	}

	snprintf(temp_buffer, sizeof(temp_buffer), "<td style=\"background: #ffffff;\">%s</td>\n", btMode);
	strcat(webString, temp_buffer);

	strcat(webString, "</tr>\n");
	strcat(webString, "<tr>\n");
	strcat(webString, "</table>\n");
#endif
	strcat(webString, "</div>\n");

	strcat(webString, "</div>\n");
	strcat(webString, "\n");
	strcat(webString, "<div class=\"content\">\n");
	strcat(webString, "<div id=\"lastHeard\">\n");
	//String lastHeardString = event_lastHeard(true);
	//strcat(webString, lastHeardString.c_str());
	//lastHeardString.clear();
	strcat(webString, "<table id=\"aprsTable\">\n<thread>\n");
	strcat(webString, "<th colspan=\"7\" style=\"background-color: #070ac2;\">LAST HEARD <a href=\"/tnc2\" target=\"_tnc2\" style=\"color: yellow;font-size:8pt\">[RAW]</a></th>\n");
	strcat(webString, "<tr>\n");
	strcat(webString, "<th data-sort=\"time\" style=\"min-width:10ch\"><span><b>Time (");
	if (config.timeZone >= 0)
		strcat(webString, "+");
	// else
	//	strcat(webString, "-");

	if (config.timeZone == (int)config.timeZone)
	{
		sprintf(temp_buffer, "%d", (int)config.timeZone);
		strcat(webString, temp_buffer);
		strcat(webString, ")</b></span><span class=\"arrow\"></span></th>\n");
	}
	else
	{
		sprintf(temp_buffer, "%.1f", config.timeZone);
		strcat(webString, temp_buffer);
		strcat(webString, ")</b></span><span class=\"arrow\"></span></th>\n");
	}
	strcat(webString, "<th style=\"min-width:16px\">ICON</th>\n");
	strcat(webString, "<th data-sort=\"callsign\" style=\"min-width:10ch\">Callsign<span class=\"arrow\"></span></th>\n");
	strcat(webString, "<th>VIA LAST PATH</th>\n");
	strcat(webString, "<th data-sort=\"dx\" style=\"min-width:5ch\">DX<span class=\"arrow\"></span></th>\n");
	strcat(webString, "<th data-sort=\"packet\" style=\"min-width:5ch\">PACKET<span class=\"arrow\"></span></th>\n");
	strcat(webString, "<th data-sort=\"audio\" style=\"min-width:5ch\">AUDIO<span class=\"arrow\"></span></th>\n");
	strcat(webString, "</tr></thread>\n<tbody id=\"aprsTableBody\"></tbody>\n");
	strcat(webString, "</table>\n");
	strcat(webString, "</div>\n");

	AsyncWebServerResponse *response = request->beginResponse(200, "text/html", (const char *)webString);
	response->addHeader("dashboard", "content");
	response->addHeader("Cache-Control", "no-cache");
	request->send(response);
	free(webString);
	lastHeardTimeout = millis() + 500;
	lastHeard_Flag = true;
}

void handle_sidebar(AsyncWebServerRequest *request)
{
	if (!request->authenticate(config.http_username, config.http_password))
	{
		return request->requestAuthentication();
	}

	// Using dynamic memory allocation instead of String
	char *html = allocateStringMemory(4096); // Initial buffer size, adjust as needed
	if (!html)
	{
		return; // Memory allocation failed
	}

	strcpy(html, "<table style=\"background:white;border-collapse: unset;\">\n");
	strcat(html, "<tr>\n");
	strcat(html, "<th colspan=\"2\">Modes Enabled</th>\n");
	strcat(html, "</tr>\n");
	strcat(html, "<tr>\n");
	if (config.igate_en)
		strcat(html, "<th style=\"background:#0b0; color:#030; width:50%;border-radius: 10px;border: 2px solid white;\">IGATE</th>\n");
	else
		strcat(html, "<th style=\"background:#606060; color:#b0b0b0;border-radius: 10px;border: 2px solid white;\">IGATE</th>\n");

	if (config.digi_en)
		strcat(html, "<th style=\"background:#0b0; color:#030; width:50%;border-radius: 10px;border: 2px solid white;\">DIGI</th>\n");
	else
		strcat(html, "<th style=\"background:#606060; color:#b0b0b0;border-radius: 10px;border: 2px solid white;\">DIGI</th>\n");
	strcat(html, "</tr>\n");
	strcat(html, "<tr>\n");
	if (config.wx_en)
		strcat(html, "<th style=\"background:#0b0; color:#030; width:50%;border-radius: 10px;border: 2px solid white;\">WX</th>\n");
	else
		strcat(html, "<th style=\"background:#606060; color:#b0b0b0;border-radius: 10px;border: 2px solid white;\">WX</th>\n");
	if (config.trk_en)
		strcat(html, "<th style=\"background:#0b0; color:#030; width:50%;border-radius: 10px;border: 2px solid white;\">TRACKER</th>\n");
	else
		strcat(html, "<th style=\"background:#606060; color:#b0b0b0;border-radius: 10px;border: 2px solid white;\">TRACKER</th>\n");
	strcat(html, "</tr>\n");
	strcat(html, "</table>\n");
	strcat(html, "<br />\n");
	strcat(html, "<table style=\"background:white;border-collapse: unset;\">\n");
	strcat(html, "<tr>\n");
	strcat(html, "<th colspan=\"2\">Network Status</th>\n");
	strcat(html, "</tr>\n");
	strcat(html, "<tr>\n");
	if (aprsClient.connected() == true)
		strcat(html, "<th style=\"background:#0b0; color:#030; width:50%;border-radius: 10px;border: 2px solid white;\">APRS-IS</th>\n");
	else
		strcat(html, "<th style=\"background:#606060; color:#b0b0b0;border-radius: 10px;border: 2px solid white;\" aria-disabled=\"true\">APRS-IS</th>\n");
	if (wireguard_active() == true)
		strcat(html, "<th style=\"background:#0b0; color:#030; width:50%;border-radius: 10px;border: 2px solid white;\">VPN</th>\n");
	else
		strcat(html, "<th style=\"background:#606060; color:#b0b0b0;border-radius: 10px;border: 2px solid white;\" aria-disabled=\"true\">VPN</th>\n");
	strcat(html, "</tr>\n");
	strcat(html, "<tr>\n");
// strcat(html, "<th style=\"background:#606060; color:#b0b0b0;border-radius: 10px;border: 2px solid white;\" aria-disabled=\"true\">4G LTE</th>\n");
#ifdef PPPOS
	if (PPP.connected())
		strcat(html, "<th style=\"background:#0b0; color:#030; width:50%;border-radius: 10px;border: 2px solid white;\">PPPoS</th>\n");
	else
#endif
		strcat(html, "<th style=\"background:#606060; color:#b0b0b0;border-radius: 10px;border: 2px solid white;\" aria-disabled=\"true\">PPPoS</th>\n");
#ifdef MQTT
	if (clientMQTT.connected())
		strcat(html, "<th style=\"background:#0b0; color:#030; width:50%;border-radius: 10px;border: 2px solid white;\">MQTT</th>\n");
	else
		strcat(html, "<th style=\"background:#606060; color:#b0b0b0;border-radius: 10px;border: 2px solid white;\" aria-disabled=\"true\">MQTT</th>\n";);
#endif
	if (config.fx25_mode > 0)
		strcat(html, "<th style=\"background:#0b0; color:#030; width:50%;border-radius: 10px;border: 2px solid white;\">FX.25</th>\n");
	else
		strcat(html, "<th style=\"background:#606060; color:#b0b0b0;border-radius: 10px;border: 2px solid white;\" aria-disabled=\"true\">FX.25</th>\n");
	strcat(html, "</tr>\n");
	strcat(html, "</table>\n");
	strcat(html, "<br />\n");
	strcat(html, "<table>\n");
	strcat(html, "<tr>\n");
	strcat(html, "<th colspan=\"2\">STATISTICS</th>\n");
	strcat(html, "</tr>\n");
	strcat(html, "<tr>\n");
	strcat(html, "<td style=\"width: 60px;text-align: right;\">RADIO RX:</td>\n");

	// Convert numeric values to strings using temporary buffers
	char temp_buffer[64];
	snprintf(temp_buffer, sizeof(temp_buffer), "<td style=\"background: #ffffff;\">%lu</td>\n", status.rxCount);
	strcat(html, temp_buffer);

	strcat(html, "</tr>\n");
	strcat(html, "<tr>\n");
	strcat(html, "<td style=\"width: 60px;text-align: right;\">PACKET RX:</td>\n");
	snprintf(temp_buffer, sizeof(temp_buffer), "<td style=\"background: #ffffff;\">%lu</td>\n", status.allCount);
	strcat(html, temp_buffer);

	strcat(html, "</tr>\n");
	strcat(html, "<tr>\n");
	strcat(html, "<td style=\"width: 60px;text-align: right;\">PACKET TX:</td>\n");
	snprintf(temp_buffer, sizeof(temp_buffer), "<td style=\"background: #ffffff;\">%lu</td>\n", status.txCount);
	strcat(html, temp_buffer);

	strcat(html, "</tr>\n");
	strcat(html, "<tr>\n");
	strcat(html, "<td style=\"width: 60px;text-align: right;\">RF2INET:</td>\n");
	snprintf(temp_buffer, sizeof(temp_buffer), "<td style=\"background: #ffffff;\">%lu</td>\n", status.rf2inet);
	strcat(html, temp_buffer);

	strcat(html, "</tr>\n");
	strcat(html, "<tr>\n");
	strcat(html, "<td style=\"width: 60px;text-align: right;\">INET2RF:</td>\n");
	snprintf(temp_buffer, sizeof(temp_buffer), "<td style=\"background: #ffffff;\">%lu</td>\n", status.inet2rf);
	strcat(html, temp_buffer);

	strcat(html, "</tr>\n");
	strcat(html, "<tr>\n");
	strcat(html, "<td style=\"width: 60px;text-align: right;\">DIGI:</td>\n");
	snprintf(temp_buffer, sizeof(temp_buffer), "<td style=\"background: #ffffff;\">%lu</td>\n", status.digiCount);
	strcat(html, temp_buffer);

	strcat(html, "</tr>\n");
	strcat(html, "<tr>\n");
	strcat(html, "<td style=\"width: 60px;text-align: right;\">DROP/ERR:</td>\n");
	snprintf(temp_buffer, sizeof(temp_buffer), "<td style=\"background: #ffffff;\">%lu/", status.dropCount);
	strcat(html, temp_buffer);
	snprintf(temp_buffer, sizeof(temp_buffer), "%lu</td>\n", status.errorCount);
	strcat(html, temp_buffer);

	strcat(html, "</tr>\n");
	strcat(html, "</table>\n");
	strcat(html, "<br />\n");
	if (config.gnss_enable)
	{
		strcat(html, "<table>\n");
		strcat(html, "<tr>\n");
		strcat(html, "<th colspan=\"2\">GPS Info <a href=\"/gnss\" target=\"_gnss\" style=\"color: yellow;font-size:8pt\">[View]</a></th>\n");
		strcat(html, "</tr>\n");
		strcat(html, "<tr>\n");
		strcat(html, "<td>LAT:</td>\n");

		snprintf(temp_buffer, sizeof(temp_buffer), "<td style=\"background: #ffffff;text-align: left;\">%f</td>\n", gps.location.lat());
		strcat(html, temp_buffer);

		strcat(html, "</tr>\n");
		strcat(html, "<tr>\n");
		strcat(html, "<td>LON:</td>\n");

		snprintf(temp_buffer, sizeof(temp_buffer), "<td style=\"background: #ffffff;text-align: left;\">%f</td>\n", gps.location.lng());
		strcat(html, temp_buffer);

		strcat(html, "</tr>\n");
		strcat(html, "<tr>\n");
		strcat(html, "<td>ALT:</td>\n");

		snprintf(temp_buffer, sizeof(temp_buffer), "<td style=\"background: #ffffff;text-align: left;\">%f</td>\n", gps.altitude.meters());
		strcat(html, temp_buffer);

		strcat(html, "</tr>\n");
		strcat(html, "<tr>\n");
		strcat(html, "<td>SAT:</td>\n");

		snprintf(temp_buffer, sizeof(temp_buffer), "<td style=\"background: #ffffff;text-align: left;\">%d</td>\n", gps.satellites.value());
		strcat(html, temp_buffer);

		strcat(html, "</tr>\n");
		strcat(html, "</table>\n");
	}
	strcat(html, "<script>\n");
	strcat(html, "$(window).trigger('resize');\n");
	strcat(html, "</script>\n");

	AsyncWebServerResponse *response = request->beginResponse(200, "text/html", (const char *)html);
	response->addHeader("Sidebar", "content");
	response->addHeader("Cache-Control", "no-cache");
	request->send(response);
	free(html); // Free the allocated memory
}

void handle_symbol(AsyncWebServerRequest *request)
{
	int i;
	int sel = -1;
	for (i = 0; i < request->args(); i++)
	{
		if (request->argName(i) == "sel")
		{
			if (request->arg(i) != "")
			{
				if (isValidNumber(request->arg(i)))
				{
					sel = request->arg(i).toInt();
				}
			}
		}
	}

	char *web = allocateStringMemory(22000); // Initial buffer size, adjust as needed
	if (web)
	{
		strcat(web, "<table border=\"1\" align=\"center\">\n");
		strcat(web, "<tr><th colspan=\"16\">Table '/'</th></tr>\n");
		strcat(web, "<tr>\n");
		char lnk[200];
		for (i = 33; i < 129; i++)
		{
			memset(lnk, 0, sizeof(lnk));
			//<td><img onclick="window.opener.setValue(113,2);" src="http://aprs.nakhonthai.net/symbols/icons/113-2.png"></td>
			if (sel == -1)
				sprintf(lnk, "<td><img onclick=\"window.opener.setValue(%d,1);\" src=\"http://aprs.nakhonthai.net/symbols/icons/%d-1.png\"></td>", i, i);
			else
				sprintf(lnk, "<td><img onclick=\"window.opener.setValue(%d,%d,1);\" src=\"http://aprs.nakhonthai.net/symbols/icons/%d-1.png\"></td>", sel, i, i);
			strcat(web, lnk);

			if (((i % 16) == 0) && (i < 126))
				strcat(web, "</tr>\n<tr>\n");
		}
		strcat(web, "</tr>");
		strcat(web, "</table>\n<br />");
		strcat(web, "<table border=\"1\" align=\"center\">\n");
		strcat(web, "<tr><th colspan=\"16\">Table '\\'</th></tr>\n");
		strcat(web, "<tr>\n");
		for (i = 33; i < 129; i++)
		{
			memset(lnk, 0, sizeof(lnk));
			if (sel == -1)
				sprintf(lnk, "<td><img onclick=\"window.opener.setValue(%d,2);\" src=\"http://aprs.nakhonthai.net/symbols/icons/%d-2.png\"></td>", i, i);
			else
				sprintf(lnk, "<td><img onclick=\"window.opener.setValue(%d,%d,2);\" src=\"http://aprs.nakhonthai.net/symbols/icons/%d-2.png\"></td>", sel, i, i);
			strcat(web, lnk);
			if (((i % 16) == 0) && (i < 126))
				strcat(web, "</tr>\n<tr>\n");
		}
		strcat(web, "</tr>");
		strcat(web, "</table>\n");
		size_t len = strlen(web);
		AsyncWebServerResponse *response = request->beginResponse_P(200, String(F("text/html")), (const uint8_t *)web, len);
		response->addHeader("Symbol", "content");
		response->addHeader("Cache-Control", "no-cache");
		request->send(response);
		free(web);
	}
}

void handle_sysinfo(AsyncWebServerRequest *request)
{
	// Using dynamic memory allocation instead of String
	char *html = allocateStringMemory(1024); // Initial buffer size, adjust as needed
	if (!html)
	{
		return; // Memory allocation failed
	}

	strcpy(html, "<table style=\"table-layout: fixed;border-collapse: unset;border-radius: 10px;border-color: #ee800a;border-style: ridge;border-spacing: 1px;border-width: 4px;background: #ee800a;\">\n");
	strcat(html, "<tr>\n");
	strcat(html, "<th><span><b>Up Time</b></span></th>\n");
	strcat(html, "<th><span>RAM(KByte)</span></th>\n");
#ifdef BOARD_HAS_PSRAM
	strcat(html, "<th><span>PSRAM(KByte)</span></th>\n");
#endif
	strcat(html, "<th><span>SPIFFS(KByte)</span></th>\n");
	if (VBat_Flag)
		strcat(html, "<th><span>VBat(V)</span></th>\n");
	strcat(html, "<th><span>CPU(Mhz)</span></th>\n");
	strcat(html, "<th><span>CPU.Temp(°C)</span></th>\n");

	strcat(html, "</tr>\n");
	strcat(html, "<tr>\n");
	// time_t tn = time(NULL) - systemUptime;
	//  char* uptime = String(day(tn) - 1, DEC) + "D " + String(hour(tn), DEC) + ":" + String(minute(tn), DEC) + ":" + String(second(tn), DEC);
	// String uptime = String(day(tn) - 1, DEC) + "D " + String(hour(tn), DEC) + ":" + String(minute(tn), DEC);
	char strTime[20];
	convertSecondsToDHMS(strTime, (millis() / 1000) - upTimeStamp);

	char temp_buffer[512];
	snprintf(temp_buffer, sizeof(temp_buffer), "<td><b>%s</b></td>\n", strTime);
	strcat(html, temp_buffer);

	snprintf(temp_buffer, sizeof(temp_buffer), "<td><b>%.1f/%.1f</b></td>\n", (float)ESP.getFreeHeap() / 1000, (float)ESP.getHeapSize() / 1000);
	strcat(html, temp_buffer);

#ifdef BOARD_HAS_PSRAM
	snprintf(temp_buffer, sizeof(temp_buffer), "<td><b>%.1f/%.1f</b></td>\n", (float)ESP.getFreePsram() / 1000, (float)ESP.getPsramSize() / 1000);
	strcat(html, temp_buffer);
#endif

	unsigned long cardTotal = LITTLEFS.totalBytes();
	unsigned long cardUsed = LITTLEFS.usedBytes();
	snprintf(temp_buffer, sizeof(temp_buffer), "<td><b>%.1f/%.1f</b></td>\n", (double)cardUsed / 1024, (double)cardTotal / 1024);
	strcat(html, temp_buffer);

	if (VBat_Flag)
	{
		snprintf(temp_buffer, sizeof(temp_buffer), "<td><b>%.2f</b></td>\n", VBat);
		strcat(html, temp_buffer);
	}

	snprintf(temp_buffer, sizeof(temp_buffer), "<td><b>%d</b></td>\n", ESP.getCpuFreqMHz());
	strcat(html, temp_buffer);

	ESPCPUTemp tempSensor;
	if (tempSensor.begin())
	{
		snprintf(temp_buffer, sizeof(temp_buffer), "<td><b>%.1f</b></td>\n", tempSensor.getTemp());
		strcat(html, temp_buffer);
	}
	else
	{
		strcat(html, "<td><b>N/A</b></td>\n");
	}
	// html += "<td style=\"background: #f00\"><b>" + String(ESP.getCycleCount()) + "</b></td>\n";
	strcat(html, "</tr>\n");
	strcat(html, "</table>\n");

	// request->send(200, "text/html", html); // send to someones browser when asked
	AsyncWebServerResponse *response = request->beginResponse(200, "text/html", (const char *)html);
	response->addHeader("Sysinfo", "content");
	response->addHeader("Cache-Control", "no-cache");
	request->send(response);
	free(html); // Free the allocated memory
}

// Copy src into dest escaping characters that would break JSON string syntax
// (", \) and stripping raw control bytes, so text taken from a TNC2 packet
// (callsign, path, object/item name) can be embedded safely inside a JSON string.
static void jsonEscapeCopy(char *dest, size_t destSize, const char *src)
{
	size_t j = 0;
	for (size_t i = 0; src[i] != '\0' && j + 1 < destSize; i++)
	{
		unsigned char c = (unsigned char)src[i];
		if (c == '"' || c == '\\')
		{
			if (j + 2 >= destSize)
				break;
			dest[j++] = '\\';
			dest[j++] = (char)c;
		}
		else if (c < 0x20)
		{
			continue; // strip control bytes
		}
		else
		{
			dest[j++] = (char)c;
		}
	}
	dest[j] = '\0';
}

void event_lastHeard(bool gethtml)
{
	// log_d("Event count: %d",lastheard_events.count());
	// if (lastheard_events.count() == 0)
	//	return;

	struct pbuf_t aprs;
	ParseAPRS aprsParse;
	struct tm tmstruct, tmNow;

	// Using dynamic memory allocation instead of String
	// Sized to fit a fully-escaped path/LPath (up to 256 raw chars -> 512 escaped) plus JSON key/quote overhead
	char temp_html[600];
	char *html = allocateStringMemory(16384); // Initial buffer size, adjust as needed
	if (html==nullptr)
	{
		return; // Memory allocation failed
	}
	time_t timeNow = time(NULL);

	// log_d("Create html last heard");
	localtime_r(&timeNow, &tmNow);
//strcat(webString, "  { time: \"21:54:23\", icon: \"91-1.png\", callsign: \"HS5TQA-7\", path: \"RF: WIDE1-1\", dx: 0.0, packet: 2, audio: -19.6 },\n");
	strcpy(html, "[");
	for (int i = 0; i < PKGLISTSIZE; i++)
	{
		if (i >= PKGLISTSIZE)
			break;
		pkgListType pkg = getPkgList(i);
		if (pkg.time > 0)
		{
			// if (pkg.raw == nullptr || pkg.length == 0)
			// 	continue;
			// bool validText = true;
			// for (size_t ci = 0; ci < pkg.length-1; ci++)
			// {
			// 	//if (!isprint((unsigned char)pkg.raw[ci]))
			// 	if((unsigned char)pkg.raw[ci] < 32 || (unsigned char)pkg.raw[ci] > 126)
			// 	{
			// 		validText = false;
			// 		break;
			// 	}
			// }
			// if (!validText)
			// 	continue;

			int packet = pkg.pkg;
			char *pos_gt = strchr(pkg.raw, '>'); // Find first position of '>'
			char *pos_colon = strchr(pkg.raw, ':');
			if(pos_gt == nullptr || pos_colon == nullptr)
				continue;
			if(pos_colon < pos_gt)
				continue;
			int start_val = pos_gt ? (pos_gt - pkg.raw) : -1;
			if (start_val > 3 && start_val < 10)
			{
				// Extract src_call substring
				char src_call[11];
				strncpy(src_call, pkg.raw, start_val);
				src_call[start_val] = '\0';
				memset(&aprs, 0, sizeof(pbuf_t));
				aprs.buf_len = 300;
				aprs.packet_len = pkg.length;
				strncpy((char *)aprs.data, pkg.raw, aprs.packet_len < sizeof(aprs.data) ? aprs.packet_len : sizeof(aprs.data) - 1);

				//char *pos_colon = strchr(pkg.raw, ':');
				char *pos_comma = strchr(pkg.raw, ',');
				char *pos_gt2 = strstr(pkg.raw + 2, ">"); // Find '>' starting from position 2
				char *pos_dash = pos_gt2 ? strchr(pos_gt2, '-') : NULL;

				int start_info = pos_colon ? (pos_colon - pkg.raw) : -1;
				int end_ssid = pos_comma ? (pos_comma - pkg.raw) : -1;
				int start_dst = pos_gt2 ? (pos_gt2 - pkg.raw) : -1;
				int start_dstssid = pos_dash ? (pos_dash - pkg.raw) : -1;

				char path[256] = "";

				if ((end_ssid > start_dst) && (end_ssid < start_info) && (end_ssid < (int)strlen(pkg.raw)))
				{
					int path_len = start_info - end_ssid - 1;
					strncpy(path, pkg.raw + end_ssid + 1, path_len);
					path[path_len] = '\0';
				}
				if (end_ssid < 5)
					end_ssid = start_info;
				if ((start_dstssid > start_dst) && (start_dstssid < start_dst + 10))
				{
					aprs.dstcall_end_or_ssid = &aprs.data[start_dstssid];
				}
				else
				{
					aprs.dstcall_end_or_ssid = &aprs.data[end_ssid];
				}
				aprs.info_start = &aprs.data[start_info + 1];
				aprs.dstname = &aprs.data[start_dst + 1];
				aprs.dstname_len = end_ssid - start_dst;
				aprs.dstcall_end = &aprs.data[end_ssid];
				aprs.srccall_end = &aprs.data[start_dst];

				// Serial.println(aprs.info_start);
				if (aprsParse.parse_aprs(&aprs))
				{
					pkg.calsign[10] = 0;
					// time_t tm = pkg.time;
					localtime_r(&pkg.time, &tmstruct);
					char strTime[20];
					//if (tmNow.tm_mday == tmstruct.tm_mday)
					//	sprintf(strTime, "%02d:%02d:%02d", tmstruct.tm_hour, tmstruct.tm_min, tmstruct.tm_sec);
					//else
						sprintf(strTime, "%02d %02d:%02d:%02d", tmstruct.tm_mday, tmstruct.tm_hour, tmstruct.tm_min, tmstruct.tm_sec);
					// String str = String(tmstruct.tm_hour, DEC) + ":" + String(tmstruct.tm_min, DEC) + ":" + String(tmstruct.tm_sec, DEC);

					// Append to html
					// strcat(html, "  { time: \"21:54:23\", icon: \"91-1.png\", callsign: \"HS5TQA-7\", path: \"RF: WIDE1-1\", dx: 0.0, packet: 2, rssi: -19.6 },\n");
					
					snprintf(temp_html, sizeof(temp_html), "{\"time\":\"%s\",", strTime);
					strcat(html, temp_html);
					char fileImg[64] = "";
					uint8_t sym = (uint8_t)aprs.symbol[1];
					if (sym > 31 && sym < 127)
					{
						if (aprs.symbol[0] > 64 && aprs.symbol[0] < 91) // table A-Z
						{
							snprintf(fileImg, sizeof(fileImg), "%d", sym);
							// if (aprs.symbol[0] == 92)
							// {
							// 	strcat(fileImg, "-2.png");
							// }
							// else if (aprs.symbol[0] == 47)
							// {
								strcat(fileImg, "-1.png");
							//}

							//snprintf(temp_html, sizeof(temp_html), "<td><b>%c</b></td>", aprs.symbol[0]);
							snprintf(temp_html, sizeof(temp_html), "\"icon\":\"%s\",", fileImg);
							strcat(html, temp_html);
						}
						else
						{
							snprintf(fileImg, sizeof(fileImg), "%d", sym);
							if (aprs.symbol[0] == 92)
							{
								strcat(fileImg, "-2.png");
							}
							else if (aprs.symbol[0] == 47)
							{
								strcat(fileImg, "-1.png");
							}
							else
							{
								strcpy(fileImg, "dot.png");
							}
							//snprintf(temp_html, sizeof(temp_html), "<td><img src=\"http://aprs.nakhonthai.net/symbols/icons/%s\"></td>", fileImg);
							snprintf(temp_html, sizeof(temp_html), "\"icon\":\"%s\",", fileImg);
							strcat(html, temp_html);
						}
					}
					else
					{
						//strcat(html, "<td><img src=\"http://aprs.nakhonthai.net/symbols/icons/dot.png\"></td>");
						strcat(html, "\"icon\":\"dot.png\",");
					}
					
					char src_call_esc[23];
					jsonEscapeCopy(src_call_esc, sizeof(src_call_esc), src_call);
					if (aprs.srcname_len > 0 && aprs.srcname_len < 10) // Get Item/Object
					{
						char itemname[10];
						memset(&itemname, 0, 10);
						memcpy(&itemname, aprs.srcname, aprs.srcname_len);
						char itemname_esc[21];
						jsonEscapeCopy(itemname_esc, sizeof(itemname_esc), itemname);
						snprintf(temp_html, sizeof(temp_html), "\"callsign\":\"%s(%s)\",", itemname_esc, src_call_esc);
						strcat(html, temp_html);
					}else{
						snprintf(temp_html, sizeof(temp_html), "\"callsign\":\"%s\",", src_call_esc);
						strcat(html, temp_html);
					}
					//strcat(html, "</td>");
					if (strlen(path) == 0)
					{
						strcat(html, "\"path\":\"RF: DIRECT\",");
					}
					else
					{
						// Find last occurrence of ','
						char *last_comma = strrchr(path, ',');
						char LPath[256] = "";
						if (last_comma != NULL)
						{
							strncpy(LPath, last_comma + 1, sizeof(LPath) - 1);
							LPath[sizeof(LPath) - 1] = '\0';
						}
						else
						{
							strncpy(LPath, path, sizeof(LPath) - 1);
							LPath[sizeof(LPath) - 1] = '\0';
						}
						char path_esc[513];
						// if(path.indexOf("qAR")>=0 || path.indexOf("qAS")>=0 || path.indexOf("qAC")>=0){ //Via from Internet Server
						if (strstr(path, "qA") != NULL || strstr(path, "TCPIP") != NULL)
						{
							jsonEscapeCopy(path_esc, sizeof(path_esc), LPath);
							snprintf(temp_html, sizeof(temp_html), "\"path\":\"INET:%s\",", path_esc);
							strcat(html, temp_html);
						}
						else
						{
							jsonEscapeCopy(path_esc, sizeof(path_esc), path);
							if (strchr(path, '*') != NULL)
							{
								snprintf(temp_html, sizeof(temp_html), "\"path\":\"DIGI: %s\",", path_esc);
								strcat(html, temp_html);
							}
							else
							{
								snprintf(temp_html, sizeof(temp_html), "\"path\":\"RF: %s\",", path_esc);
								strcat(html, temp_html);
							}
						}
					}
					// html += "<td>" + path + "</td>";
					if (aprs.flags & F_HASPOS)
					{
						double lat, lon;
						if (gps.location.isValid())
						{
							lat = gps.location.lat();
							lon = gps.location.lng();
						}
						else
						{
							lat = config.igate_lat;
							lon = config.igate_lon;
						}
						double dtmp = aprsParse.direction(lon, lat, aprs.lng, aprs.lat);
						double dist = aprsParse.distance(lon, lat, aprs.lng, aprs.lat);
						snprintf(temp_html, sizeof(temp_html), "\"dx\":\"%.1fkm/%.0f°\",", dist, dtmp);
						strcat(html, temp_html);
					}
					else
					{
						strcat(html, "\"dx\":\"-\",");
					}
					snprintf(temp_html, sizeof(temp_html), "\"packet\":\"%d\",", packet);
					strcat(html, temp_html);
					if (pkg.audio_level == 0)
					{
						strcat(html, "\"audio\":\"-\"},");
					}
					else
					{
						double Vrms = (double)pkg.audio_level / 1000;
						double audBV = 20.0F * log10(Vrms);
						// if (audBV < -20.0F)
						// {
						// 	strcat(html, " audio:\"");
						// }
						// else if (audBV > -5.0F)
						// {
						// 	strcat(html, "<td style=\"color: #f00000;\">");
						// }
						// else
						// {
						// 	strcat(html, "<td style=\"color: #008000;\">");
						// }
						snprintf(temp_html, sizeof(temp_html), "\"audio\":\"%.1f\"},", audBV);
						strcat(html, temp_html);
						//strcat(html, "dBV</td></tr>\n");
					}
				}
			}
		}
	}
	html[strlen(html) - 1] = '\0'; // Remove the last comma
	if (html[0] == '[')
	strcat(html, "]");

	size_t len = strlen(html);
	// char *info = (char *)calloc(len + 1, sizeof(char));
	// if (info)
	// {
	// 	strcpy(info, html);
	if (len > 10)
		lastheard_events.send(html, "lastHeard", millis() / 1000, 1000);
	// 	free(info);
	// }

	free(html);
}

String event_chatMessage(bool gethtml)
{
	// log_d("Event count: %d",lastheard_events.count());
	// if (message_events.count() == 0)
	//	return "NO";

	struct tm tmstruct, tmNow;

	// Using dynamic memory allocation instead of String
	char *html = allocateStringMemory(4096); // Initial buffer size, adjust as needed
	if (!html)
	{
		return String(""); // Memory allocation failed
	}

	time_t timen = time(NULL);
	localtime_r(&timen, &tmNow);

	strcpy(html, "<tr>\n");
	strcat(html, "<th style=\"width:60pt\"><span><b>Time (");
	if (config.timeZone >= 0)
		strcat(html, "+");

	// Convert timezone to string
	char temp_buffer[64];
	if (config.timeZone == (int)config.timeZone)
	{
		snprintf(temp_buffer, sizeof(temp_buffer), "%d", (int)config.timeZone);
		strcat(html, temp_buffer);
		strcat(html, ")</b></span></th>\n");
	}
	else
	{
		snprintf(temp_buffer, sizeof(temp_buffer), "%.1f", config.timeZone);
		strcat(html, temp_buffer);
		strcat(html, ")</b></span></th>\n");
	}
	// strcat(html, "<th style=\"min-width:16px\">ICON</th>\n");

	strcat(html, "<th style=\"width:70pt\">Callsign</th>\n");
	strcat(html, "<th>Message</th>\n");
	strcat(html, "<th style=\"width:10pt\">ACK</th>\n");
	strcat(html, "<th style=\"width:20pt\">msgID</th>\n");
	strcat(html, "</tr>\n");

	pkgMsgSort(msgQueue);
	for (int i = 0; i < PKGLISTSIZE; i++)
	{
		if (i >= PKGLISTSIZE)
			break;
		msgType pkg = getMsgList(i);
		if (pkg.time > 0)
		{
			// String line = String(pkg.text); // Not needed anymore

			pkg.callsign[10] = 0;
			// time_t tm = pkg.time;
			localtime_r(&pkg.time, &tmstruct);
			char strTime[10];
			// sprintf(strTime, "%02d:%02d:%02d", tmstruct.tm_hour, tmstruct.tm_min, tmstruct.tm_sec);
			if (tmNow.tm_mday == tmstruct.tm_mday)
				sprintf(strTime, "%02d:%02d:%02d", tmstruct.tm_hour, tmstruct.tm_min, tmstruct.tm_sec);
			else
				sprintf(strTime, "%dd %02d:%02d", tmstruct.tm_mday, tmstruct.tm_hour, tmstruct.tm_min);
			// String str = String(tmstruct.tm_hour, DEC) + ":" + String(tmstruct.tm_min, DEC) + ":" + String(tmstruct.tm_sec, DEC);

			if (pkg.ack > 0)
			{
				strcat(html, "<tr style=\"background-color: #f1697dff;\">\n");
			}
			else if (pkg.ack == -1)
			{
				strcat(html, "<tr style=\"background-color: #7ff1c5ff;\">\n");
			}
			else if (pkg.ack == -2)
			{
				strcat(html, "<tr style=\"background-color: #73caf0ff;\">\n");
			}
			else
			{
				strcat(html, "<tr style=\"background-color: #f55353ff;\">\n");
			}

			strcat(html, "<td>");
			strcat(html, strTime);
			strcat(html, "</td>");

			strcat(html, "<td>");
			strcat(html, pkg.callsign);
			strcat(html, "</td>");

			strcat(html, "<td style=\"text-align: left;\">");
			strcat(html, pkg.text);
			strcat(html, "</td>");

			if (pkg.ack > 0)
			{
				snprintf(temp_buffer, sizeof(temp_buffer), "<td>%d/%d</td>", pkg.ack, config.msg_retry);
				strcat(html, temp_buffer);
			}
			else if (pkg.ack == -1)
			{
				strcat(html, "<td>RX</td>");
			}
			else if (pkg.ack == -2)
			{
				strcat(html, "<td>TX</td>");
			}
			else
			{
				strcat(html, "<td>TF</td>");
			}

			snprintf(temp_buffer, sizeof(temp_buffer), "<td>%d</td></tr>\n", pkg.msgID);
			strcat(html, temp_buffer);
		}
	}

	size_t html_len = strlen(html);
	log_d("HTML Length=%d Byte gethtml:%d event_cnt:%d", html_len, gethtml, message_events.count());

	if (gethtml)
	{
		String result = String(html); // Convert back to String for return
		free(html);					  // Free the allocated memory
		return result;
	}

	if (message_events.count() > 0)
	{
		char *info = (char *)calloc(html_len + 1, sizeof(char)); // +1 for null terminator
		if (info)
		{
			strcpy(info, html);
			message_events.send(info, "chatMsg", time(NULL), 5000);
			free(info);
		}
	}

	free(html); // Free the allocated memory
	return String("");
}

void handle_storage(AsyncWebServerRequest *request)
{
	if (!request->authenticate(config.http_username, config.http_password))
	{
		return request->requestAuthentication();
	}
	adcEn = -1;
	dacEn = -1;
	delay(100);	

	StandByTick = millis() + (config.pwr_stanby_delay * 1000);

	const char *dirname = "/";
	char strTime[100];

	unsigned long cardTotal = LITTLEFS.totalBytes();
	unsigned long cardUsed = LITTLEFS.usedBytes();

	if (request->hasArg("delete"))
	{
		for (uint8_t i = 0; i < request->args(); i++)
		{
			if (request->argName(i) == "FILE")
			{
				String path = request->arg(i);
#ifdef DEBUG
				Serial.println("Deleting file: " + path);
#endif
				if (LITTLEFS.remove("/" + path))
				{
					//html = "File deleted";
#ifdef DEBUG
					Serial.println("File deleted");
#endif
				}
				else
				{
					//html = "Delete failed";
#ifdef DEBUG
					Serial.println("Delete failed");
#endif
				}
				break;
			}
		}
	}else if (request->hasArg("download"))
	{
		for (uint8_t i = 0; i < request->args(); i++)
		{
			if (request->argName(i) == "FILE")
			{
				String path = request->arg(i);
				String dataType = "";
				if (path.endsWith(".src"))
					path = path.substring(0, path.lastIndexOf("."));
				else if (path.endsWith(".htm"))
					dataType = "text/html";
				else if (path.endsWith(".csv"))
					dataType = "text/csv";
				else if (path.endsWith(".css"))
					dataType = "text/css";
				else if (path.endsWith(".xml"))
					dataType = "text/xml";
				else if (path.endsWith(".png"))
					dataType = "image/png";
				else if (path.endsWith(".gif"))
					dataType = "image/gif";
				else if (path.endsWith(".jpg"))
					dataType = "image/jpeg";
				else if (path.endsWith(".ico"))
					dataType = "image/x-icon";
				else if (path.endsWith(".svg"))
					dataType = "image/svg+xml";
				else if (path.endsWith(".ico"))
					dataType = "image/x-icon";
				else if (path.endsWith(".js"))
					dataType = "application/javascript";
				else if (path.endsWith(".pdf"))
					dataType = "application/pdf";
				else if (path.endsWith(".zip"))
					dataType = "application/zip";
				else if (path.endsWith(".cfg"))
					dataType = "plain/text";
				else if (path.endsWith(".json"))
					dataType = "application/json";
				else if (path.endsWith(".gz"))
				{
					if (path.startsWith("/gz/htm"))
						dataType = "text/html";
					else if (path.startsWith("/gz/css"))
						dataType = "text/css";
					else if (path.startsWith("/gz/csv"))
						dataType = "text/csv";
					else if (path.startsWith("/gz/xml"))
						dataType = "text/xml";
					else if (path.startsWith("/gz/js"))
						dataType = "application/javascript";
					else if (path.startsWith("/gz/svg"))
						dataType = "image/svg+xml";
					else
						dataType = "application/x-gzip";
				}else{
					dataType = "application/octet-stream";
					path = path.substring(0, path.lastIndexOf("."));
					//html = "File type not support";
					//request->send_P(404, PSTR("text/plain"), PSTR("File type not support"));
					//break;
				}

				if (path != "" && dataType != "")
				{
					String file = "/" + path;
					//request->send(LITTLEFS, file, dataType, true);
					AsyncWebServerResponse *response = request->beginResponse(LITTLEFS, file, dataType, true);
					//response->addHeader("Content-Disposition","attachment");
					request->send(response);
				}
				else
				{
					if (dataType != "")
						request->send_P(404, PSTR("text/plain"), PSTR("ContentType Not Support"));
					else
						request->send_P(404, PSTR("text/plain"), PSTR("File Not found"));
				}
				return;
			}
		}
	}

	// Using dynamic memory allocation instead of String
	char *webString = allocateStringMemory(8192); // Initial buffer size, adjust as needed
	if (!webString)
	{
		return; // Memory allocation failed
	}

		strcat(webString, "<script type=\"text/javascript\">\n"
					  "function sub(obj){"
					  "var fileName = obj.value.split('\\\\');"
					  "document.getElementById('file-input').innerHTML = '   '+ fileName[fileName.length-1];"
					  "}\n"
					  //"var form = document.getElementById('upload_form');"
					  "$('form').submit(function(e){"
					  "e.preventDefault();"
					  "var data = new FormData(e.currentTarget);\n"
					  
					  "if(e.currentTarget.id === 'upload_form'){ document.getElementById('upload_sumbit').disabled = true;"
					  "var formUp = $('#upload_form')[0];"
					  "var dataUp = new FormData(formUp);"					  
					  //"document.getElementById('upload_sumbit').disabled = true;"
					  "$.ajax({"
					  "url: '/upload',"
					  "type: 'POST',"
					  "data: dataUp,"
					  "contentType: false,"
					  "processData:false,"
					  "xhr: function() {"
					  "var xhr = new window.XMLHttpRequest();"
					  "xhr.upload.addEventListener('progress', function(evt) {"
					  "if (evt.lengthComputable) {"
					  "var per = evt.loaded / evt.total;"
					  "$('#prg').html(Math.round(per*100) + '%');"
					  "$('#bar').css('width',Math.round(per*100) + '%');"
					  "}"
					  "}, false);"
					  "return xhr;"
					  "},"
					  "success:function(d, s) {"
					  "alert('Upload Success');"
					  "$(\"#contentmain\").load(\"/storage\");\n"
					  "},"
					  "error: function (a, b, c) {"
					  "}"
					  "});"
					  //"});"
					  "}else{"					  
					  "$.ajax({"
					  "url: '/storage',"
					  "type: 'POST',"
					  "data: data,"
					  "contentType: false,"
					  "processData:false,"					  
					  "success:function(d, s) {"
					  //"alert('Upload Success');"
					  "if(e.currentTarget.id===\"formDelete\") $(\"#contentmain\").load(\"/storage\");\n"
					  "},"
					  "error: function (a, b, c) {"
					  "}"
					  "});"
					  //"});"
					  "}"
					  "});"
					  "</script>");

	strcat(webString, "<div style=\"font-size: 8pt;text-align:left;\">");
	strcat(webString, "<b>Total space: </b>");

	char temp_buffer[512];
	if (cardTotal > 1000000)
	{
		snprintf(temp_buffer, sizeof(temp_buffer), "%.2f MByte ,", (double)cardTotal / 1048576);
		strcat(webString, temp_buffer);
	}
	else
	{
		snprintf(temp_buffer, sizeof(temp_buffer), "%.2f KByte ,", (double)cardTotal / 1024);
		strcat(webString, temp_buffer);
	}

	strcat(webString, "<b>Used space: </b>");
	snprintf(temp_buffer, sizeof(temp_buffer), "%.2f KByte", (double)cardUsed / 1024);
	strcat(webString, temp_buffer);

	snprintf(temp_buffer, sizeof(temp_buffer), "</br>Listing directory: </b>%s</div>\n", dirname);
	strcat(webString, temp_buffer);

	File root = LITTLEFS.open(dirname);
	if (!root)
	{
		strcat(webString, "Failed to open directory\n");
		// return;
	}
	if (!root.isDirectory())
	{
		strcat(webString, "Not a directory");
		// return;
	}

	File file = root.openNextFile();
	strcat(webString, "<table border=\"1\"><tr align=\"center\" bgcolor=\"#03DDFC\"><th width=\"100\"><b>DIRECTORY</b></th><th><b>FILE NAME</b></th><th width=\"100\"><b>SIZE(Byte)</b></th><th width=\"170\"><b>DATE TIME</b></th><th width=\"50\"><b>DELETE</b></th><th width=\"100\"><b>DOWNLOAD</b></th></tr>");
	while (file)
	{
		if (file.isDirectory())
		{
			// webString += "<tr><td>DIR : ");
			snprintf(temp_buffer, sizeof(temp_buffer), "<tr><td>%s</td>", file.name());
			strcat(webString, temp_buffer);
			time_t t = file.getLastWrite();
			struct tm *tmstruct = localtime(&t);
			sprintf(strTime, "<td></td><td></td><td align=\"right\">%d-%02d-%02d %02d:%02d:%02d</td>", (tmstruct->tm_year) + 1900, (tmstruct->tm_mon) + 1, tmstruct->tm_mday, tmstruct->tm_hour, tmstruct->tm_min, tmstruct->tm_sec);
			strcat(webString, strTime);
			// if (levels) {
			//	listDir(fs, file.name(), levels - 1);
			// }
			strcat(webString, "<td></td></tr>\n");
		}
		else
		{
			/*Serial.print("  FILE: ");
			Serial.print(file.name());*/
			// char *fName = String(file.name()).substring(1).c_str(); // Not needed for full path
			const char *fName = file.name();
			snprintf(temp_buffer, sizeof(temp_buffer), "<tr><td>/</td><td align=\"left\"><a href=\"/download?FILE=%s\" target=\"_blank\">%s</a></td>", fName, fName);
			strcat(webString, temp_buffer);
			// Serial.print("  SIZE: ");
			snprintf(temp_buffer, sizeof(temp_buffer), "<td align=\"right\">%d</td>", file.size());
			strcat(webString, temp_buffer);
			time_t t = file.getLastWrite();
			struct tm *tmstruct = localtime(&t);
			sprintf(strTime, "<td align=\"center\">%d-%02d-%02d %02d:%02d:%02d</td>", (tmstruct->tm_year) + 1900, (tmstruct->tm_mon) + 1, tmstruct->tm_mday, tmstruct->tm_hour, tmstruct->tm_min, tmstruct->tm_sec);
			strcat(webString, strTime);
			snprintf(temp_buffer, sizeof(temp_buffer), "<td align=\"center\"><form accept-charset=\"UTF-8\" action=\"#\" enctype='multipart/form-data' id=\"formDelete\" method=\"post\"><input name=\"delete\" type=\"hidden\" /><input name=\"FILE\" type=\"hidden\" value=\"%s\" /><button name=\"commit\" id=\"btnDelete\" type=\"submit\" style=\"background-color:red;color:white\">X</button></form></td>\n", fName);
			strcat(webString, temp_buffer);
			snprintf(temp_buffer, sizeof(temp_buffer), "<td align=\"center\"><form accept-charset=\"UTF-8\" action=\"#\" enctype='multipart/form-data' id=\"formDownload\" method=\"post\"><input name=\"download\" type=\"hidden\" /><input name=\"FILE\" type=\"hidden\" value=\"%s\" /><button name=\"commit\" id=\"btnDownload\" type=\"submit\" style=\"background-color:green;color:white\">DOWNLOAD</button></form></td></tr>\n", fName);
			strcat(webString, temp_buffer);
		}
		file = root.openNextFile();
	}
	strcat(webString, "</table>\n");
	// strcat(webString, "<form accept-charset=\"UTF-8\" action=\"/format\" class=\"form-horizontal\" id=\"format_form\" method=\"post\">\n");
	// strcat(webString, "<br><div><button class=\"button\" type='submit' id='format_form_sumbit'  name=\"commit\"> FORMAT </button></div>\n");
	// strcat(webString, "</form><br/>\n");

	// UPLOAD CONFIGURATION FILE
	strcat(webString, "<br><form accept-charset=\"UTF-8\" action=\"#\" "
					  "class=\"form-horizontal\" id=\"upload_form\" method=\"post\" "
					  "enctype=\"multipart/form-data\">\n");

	strcat(webString, "<table border=\"1\" style=\"margin-top:10px;width:100%;\">\n");
	strcat(webString, "<tr align=\"center\" bgcolor=\"#03DDFC\">"
					  "<th colspan=\"3\"><b>UPLOAD FILE</b></th>"
					  "</tr>\n");

	strcat(webString, "<tr align=\"center\">"
					  "<td width=\"60\" align=\"right\"><b>File:</b></td>"
					  "<td align=\"left\"><input type=\"file\" name=\"data\" required></td>"
					  "<td width=\"120\"><button class=\"button\" type='submit' id='upload_sumbit'>UPLOAD</button></td>"
					  "</tr>\n");

	strcat(webString, "</table>\n");
	strcat(webString, "</form><br/>\n");

	strcat(webString, "</body>\n</html>\n");

	AsyncWebServerResponse *response = request->beginResponse(200, "text/html", (const char *)webString);
	response->addHeader("Sensor", "content");
	response->addHeader("Cache-Control", "no-cache");
	request->send(response);
	free(webString); // Free the allocated memory
	adcEn = 1;
	dacEn = 0;
}

void handle_download(AsyncWebServerRequest *request)
{
	if (!request->authenticate(config.http_username, config.http_password))
	{
		return request->requestAuthentication();
	}
	String dataType = "";
	String path = "";

	if (request->args() > 0)
	{
		for (uint8_t i = 0; i < request->args(); i++)
		{
			if (request->argName(i) == "FILE")
			{
				path = request->arg(i);
				break;
			}
		}
	}

	if (path.endsWith(".src"))
		path = path.substring(0, path.lastIndexOf("."));
	else if (path.endsWith(".htm"))
		dataType = "text/html";
	else if (path.endsWith(".csv"))
		dataType = "text/csv";
	else if (path.endsWith(".css"))
		dataType = "text/css";
	else if (path.endsWith(".xml"))
		dataType = "text/xml";
	else if (path.endsWith(".png"))
		dataType = "image/png";
	else if (path.endsWith(".gif"))
		dataType = "image/gif";
	else if (path.endsWith(".jpg"))
		dataType = "image/jpeg";
	else if (path.endsWith(".ico"))
		dataType = "image/x-icon";
	else if (path.endsWith(".svg"))
		dataType = "image/svg+xml";
	else if (path.endsWith(".ico"))
		dataType = "image/x-icon";
	else if (path.endsWith(".js"))
		dataType = "application/javascript";
	else if (path.endsWith(".pdf"))
		dataType = "application/pdf";
	else if (path.endsWith(".zip"))
		dataType = "application/zip";
	else if (path.endsWith(".cfg"))
		dataType = "text/html";
	else if (path.endsWith(".json"))
		dataType = "application/json";
	else if (path.endsWith(".gz"))
	{
		if (path.startsWith("/gz/htm"))
			dataType = "text/html";
		else if (path.startsWith("/gz/css"))
			dataType = "text/css";
		else if (path.startsWith("/gz/csv"))
			dataType = "text/csv";
		else if (path.startsWith("/gz/xml"))
			dataType = "text/xml";
		else if (path.startsWith("/gz/js"))
			dataType = "application/javascript";
		else if (path.startsWith("/gz/svg"))
			dataType = "image/svg+xml";
		else
			dataType = "application/x-gzip";
	}

	if (path != "" && dataType != "")
	{
		String file = "/" + path;
		request->send(LITTLEFS, file, dataType, true);
		// AsyncWebServerResponse *response = request->beginResponse(LITTLEFS, file, dataType, true);
		// response->addHeader("Content-Disposition","attachment");
		// request->send(response);
	}
	else
	{
		if (dataType != "")
			request->send_P(404, PSTR("text/plain"), PSTR("ContentType Not Support"));
		else
			request->send_P(404, PSTR("text/plain"), PSTR("File Not found"));
	}
}

void handle_delete(AsyncWebServerRequest *request)
{
	if (!request->authenticate(config.http_username, config.http_password))
	{
		return request->requestAuthentication();
	}
	String html = "FAIL";
	String dataType = "text/plain";
	String path;
	if (request->args() > 0)
	{
		for (uint8_t i = 0; i < request->args(); i++)
		{
			if (request->argName(i) == "FILE")
			{
				path = request->arg(i);
#ifdef DEBUG
				Serial.println("Deleting file: " + path);
#endif
				if (LITTLEFS.remove("/" + path))
				{
					html = "File deleted";
#ifdef DEBUG
					Serial.println("File deleted");
#endif
				}
				else
				{
					html = "Delete failed";
#ifdef DEBUG
					Serial.println("Delete failed");
#endif
				}
				break;
			}
		}
	}
	request->send(200, "text/html", html); // send to someones browser when asked
}

void handle_format(AsyncWebServerRequest *request)
{
	if (!request->authenticate(config.http_username, config.http_password))
	{
		return request->requestAuthentication();
	}
	String html = "FAIL";
	if (request->args() > 0)
	{
		for (uint8_t i = 0; i < request->args(); i++)
		{
			if (request->argName(i) == "commit")
			{
				if (request->arg(i) == "FORMAT")
				{
					LITTLEFS.format();
					html = "OK";
					break;
				}
			}
		}
	}

	request->send(200, "text/html", html); // send to someones browser when asked
}

void handle_radio(AsyncWebServerRequest *request)
{
	if (!request->authenticate(config.http_username, config.http_password))
	{
		return request->requestAuthentication();
	}
	// bool noiseEn=false;
	bool radioEnable = false;
	if (request->hasArg("commitRadio"))
	{
		for (uint8_t i = 0; i < request->args(); i++)
		{
			// Serial.print("SERVER ARGS ");
			// Serial.print(request->argName(i));
			// Serial.print("=");
			// Serial.println(request->arg(i));
			if (request->argName(i) == "radioEnable")
			{
				if (request->arg(i) != "")
				{
					// Compare the argument directly without converting to String
					if (strcmp(request->arg(i).c_str(), "OK") == 0)
					{
						radioEnable = true;
					}
				}
			}

			if (request->argName(i) == "nw_band")
			{
				if (request->arg(i) != "")
				{
					if (isValidNumber(request->arg(i)))
					{
						config.band = request->arg(i).toInt();
						// if (request->arg(i).toInt())
						// 	config.band = 1;
						// else
						// 	config.band = 0;
					}
				}
			}

			if (request->argName(i) == "volume")
			{
				if (request->arg(i) != "")
				{
					if (isValidNumber(request->arg(i)))
						config.volume = request->arg(i).toInt();
				}
			}

			if (request->argName(i) == "rf_power")
			{
				if (request->arg(i) != "")
				{
					if (isValidNumber(request->arg(i)))
					{
						if (request->arg(i).toInt())
							config.rf_power = true;
						else
							config.rf_power = false;
					}
				}
			}

			if (request->argName(i) == "sql_level")
			{
				if (request->arg(i) != "")
				{
					if (isValidNumber(request->arg(i)))
						config.sql_level = request->arg(i).toInt();
				}
			}

			if (request->argName(i) == "tx_freq")
			{
				if (request->arg(i) != "")
				{
					if (isValidNumber(request->arg(i)))
						config.freq_tx = request->arg(i).toFloat();
				}
			}
			if (request->argName(i) == "rx_freq")
			{
				if (request->arg(i) != "")
				{
					if (isValidNumber(request->arg(i)))
						config.freq_rx = request->arg(i).toFloat();
				}
			}

			if (request->argName(i) == "tx_offset")
			{
				if (request->arg(i) != "")
				{
					if (isValidNumber(request->arg(i)))
						config.offset_tx = request->arg(i).toInt();
				}
			}
			if (request->argName(i) == "rx_offset")
			{
				if (request->arg(i) != "")
				{
					if (isValidNumber(request->arg(i)))
						config.offset_rx = request->arg(i).toInt();
				}
			}

			if (request->argName(i) == "tx_ctcss")
			{
				if (request->arg(i) != "")
				{
					if (isValidNumber(request->arg(i)))
						config.tone_tx = request->arg(i).toInt();
				}
			}
			if (request->argName(i) == "rx_ctcss")
			{
				if (request->arg(i) != "")
				{
					if (isValidNumber(request->arg(i)))
						config.tone_rx = request->arg(i).toInt();
				}
			}
			if (request->argName(i) == "rf_type")
			{
				if (request->arg(i) != "")
				{
					if (isValidNumber(request->arg(i)))
						config.rf_type = request->arg(i).toInt();
				}
			}
		}
		// config.noise=noiseEn;
		// config.agc=agcEn;
		config.rf_en = radioEnable;
		// Using dynamic memory allocation instead of String
		char *html = allocateStringMemory(64); // Small buffer for "OK"
		if (html)
		{
			strcpy(html, "OK");
			request->send(200, "text/html", html); // send to someones browser when asked
			free(html);							   // Free the allocated memory
		}
		saveConfiguration("/default.cfg", config);
		delay(500);
		RF_MODULE(false);
	}
	else if (request->hasArg("commitTNC"))
	{
		bool hpf = 0;
		bool lpf = 0;
		for (uint8_t i = 0; i < request->args(); i++)
		{
			if (request->argName(i) == "HPF")
			{
				if (request->arg(i) != "")
				{
					if (strcmp(request->arg(i).c_str(), "OK") == 0)
					{
						hpf = true;
					}
				}
			}
			if (request->argName(i) == "LPF")
			{
				if (request->arg(i) != "")
				{
					if (strcmp(request->arg(i).c_str(), "OK") == 0)
					{
						lpf = true;
					}
				}
			}
			if (request->argName(i) == "timeSlot")
			{
				if (request->arg(i) != "")
				{
					if (isValidNumber(request->arg(i)))
					{
						config.tx_timeslot = request->arg(i).toInt();
					}
				}
			}
			if (request->argName(i) == "preamble")
			{
				if (request->arg(i) != "")
				{
					if (isValidNumber(request->arg(i)))
					{
						config.preamble = request->arg(i).toInt();
					}
				}
			}
			if (request->argName(i) == "modem_type")
			{
				if (request->arg(i) != "")
				{
					if (isValidNumber(request->arg(i)))
						config.modem_type = request->arg(i).toInt();
				}
			}
			if (request->argName(i) == "fx25_mode")
			{
				if (request->arg(i) != "")
				{
					if (isValidNumber(request->arg(i)))
						config.fx25_mode = request->arg(i).toInt();
				}
			}
		}
		config.audio_hpf = hpf;
		config.audio_lpf = lpf;
		// Using dynamic memory allocation instead of String
		char *html = allocateStringMemory(64); // Small buffer for "OK"
		if (html)
		{
			strcpy(html, "OK");
			request->send(200, "text/html", html); // send to someones browser when asked
			free(html);							   // Free the allocated memory
		}
		saveConfiguration("/default.cfg", config);
		afskSetModem(config.modem_type, config.audio_lpf, config.tx_timeslot, config.preamble * 100, config.fx25_mode);
	}
	else
	{
		// Using dynamic memory allocation instead of String
		char *html = allocateStringMemory(12000); // Initial buffer size, adjust as needed
		if (!html)
		{
			return; // Memory allocation failed
		}

		strcpy(html, "<script type=\"text/javascript\">\n");
		strcat(html, "var sliderVol = document.getElementById(\"sliderVolume\");\n");
		strcat(html, "var outputVol = document.getElementById(\"volShow\");\n");
		strcat(html, "var sliderSql = document.getElementById(\"sliderSql\");\n");
		strcat(html, "var outputSql = document.getElementById(\"sqlShow\");\n");
		strcat(html, "outputVol.innerHTML = sliderVol.value;\n");
		strcat(html, "outputSql.innerHTML = sliderSql.value;\n");
		strcat(html, "\n");
		strcat(html, "sliderVol.oninput = function () {\n");
		strcat(html, "outputVol.innerHTML = this.value;\n");
		strcat(html, "}\n");
		strcat(html, "sliderSql.oninput = function () {\n");
		strcat(html, "outputSql.innerHTML = this.value;\n");
		strcat(html, "}\n");
		strcat(html, "\n");
		strcat(html, "$('form').submit(function (e) {\n");
		strcat(html, "e.preventDefault();\n");
		strcat(html, "var data = new FormData(e.currentTarget);\n");
		strcat(html, "if(e.currentTarget.id===\"formRadio\") document.getElementById(\"submitRadio\").disabled=true;\n");
		strcat(html, "if(e.currentTarget.id===\"formTNC\") document.getElementById(\"submitTNC\").disabled=true;\n");
		strcat(html, "$.ajax({\n");
		strcat(html, "url: '/radio',\n");
		strcat(html, "type: 'POST',\n");
		strcat(html, "data: data,\n");
		strcat(html, "contentType: false,\n");
		strcat(html, "processData: false,\n");
		strcat(html, "success: function (data) {\n");
		strcat(html, "alert(\"Submited Successfully\");\n");
		strcat(html, "},\n");
		strcat(html, "error: function (data) {\n");
		strcat(html, "alert(\"An error occurred.\");\n");
		strcat(html, "}\n");
		strcat(html, "});\n");
		strcat(html, "});\n");
		strcat(html, "function rfType(){\n");
		strcat(html, "var type = document.getElementById(\"rf_type\").value;\n");
		strcat(html, "if(type==1||type==4||type==7){document.getElementById(\"tx_freq\").setAttribute(\"max\",174);document.getElementById(\"rx_freq\").setAttribute(\"max\",174);};\n");
		strcat(html, "if(type==1){document.getElementById(\"tx_freq\").setAttribute(\"min\",134);document.getElementById(\"rx_freq\").setAttribute(\"min\",134);};\n");
		strcat(html, "if(type==4||type==7){document.getElementById(\"tx_freq\").setAttribute(\"min\",136);document.getElementById(\"rx_freq\").setAttribute(\"min\",136);};\n");
		strcat(html, "if(type==2||type==5||type==8){document.getElementById(\"tx_freq\").setAttribute(\"max\",470);document.getElementById(\"rx_freq\").setAttribute(\"max\",470);};\n");
		strcat(html, "if(type==2||type==5||type==8){document.getElementById(\"tx_freq\").setAttribute(\"min\",400);document.getElementById(\"rx_freq\").setAttribute(\"min\",400);};\n");
		strcat(html, "if(type==3){document.getElementById(\"tx_freq\").setAttribute(\"min\",320);document.getElementById(\"rx_freq\").setAttribute(\"min\",320);};\n");
		strcat(html, "if(type==3){document.getElementById(\"tx_freq\").setAttribute(\"max\",400);document.getElementById(\"rx_freq\").setAttribute(\"max\",400);};\n");
		strcat(html, "if(type==6){document.getElementById(\"tx_freq\").setAttribute(\"min\",350);document.getElementById(\"rx_freq\").setAttribute(\"min\",350);};\n");
		strcat(html, "if(type==6){document.getElementById(\"tx_freq\").setAttribute(\"max\",390);document.getElementById(\"rx_freq\").setAttribute(\"max\",390);};\n");
		strcat(html, "if(type==1||type==4||type==7){document.getElementById(\"tx_freq\").setAttribute(\"value\",144.390);document.getElementById(\"rx_freq\").setAttribute(\"value\",144.390);};\n");
		strcat(html, "if(type==2||type==5||type==8){document.getElementById(\"tx_freq\").setAttribute(\"value\",432.5);document.getElementById(\"rx_freq\").setAttribute(\"value\",432.5);};\n");
		strcat(html, "\n");
		strcat(html, "}\n");
		strcat(html, "</script>\n");
		strcat(html, "<form id='formRadio' method=\"POST\" action='#' enctype='multipart/form-data'>\n");
		strcat(html, "<table>\n");
		strcat(html, "<th colspan=\"2\"><span><b>RF Analog Module</b></span></th>\n");
		strcat(html, "<tr>\n");
		strcat(html, "<td align=\"right\"><b>Enable:</b></td>\n");

		// Handle radio enable flag
		char temp_buffer[256];
		if (config.rf_en)
		{
			strcat(html, "<td style=\"text-align: left;\"><label class=\"switch\"><input type=\"checkbox\" name=\"radioEnable\" value=\"OK\" checked><span class=\"slider round\"></span></label></td>\n");
		}
		else
		{
			strcat(html, "<td style=\"text-align: left;\"><label class=\"switch\"><input type=\"checkbox\" name=\"radioEnable\" value=\"OK\" ><span class=\"slider round\"></span></label></td>\n");
		}
		strcat(html, "</tr>\n");
		strcat(html, "<tr>\n");
		strcat(html, "<td align=\"right\"><b>Module Type:</b></td>\n");
		strcat(html, "<td style=\"text-align: left;\">\n");
		strcat(html, "<select name=\"rf_type\" id=\"rf_type\" onchange=\"rfType()\">\n");
		for (int i = 0; i < 9; i++)
		{
			snprintf(temp_buffer, sizeof(temp_buffer), "<option value=\"%d\" ", i);
			strcat(html, temp_buffer);
			if (config.rf_type == i)
			{
				strcat(html, "selected>");
			}
			else
			{
				strcat(html, ">");
			}
			snprintf(temp_buffer, sizeof(temp_buffer), "%s</option>\n", RF_TYPE[i]);
			strcat(html, temp_buffer);
		}
		strcat(html, "</select>\n");
		strcat(html, "</td>\n");
		float freqMin = 0;
		float freqMax = 0;
		switch (config.rf_type)
		{
		case RF_SA868_VHF:
			freqMin = 134.0F;
			freqMax = 174.0F;
			break;
		case RF_SR_1WV:
		case RF_SR_2WVS:
			freqMin = 136.0F;
			freqMax = 174.0F;
			break;
		case RF_SA868_350:
			freqMin = 320.0F;
			freqMax = 400.0F;
			break;
		case RF_SR_1W350:
			freqMin = 350.0F;
			freqMax = 390.0F;
			break;
		case RF_SA868_UHF:
		case RF_SR_1WU:
		case RF_SR_2WUS:
			freqMin = 400.0F;
			freqMax = 470.0F;
			break;
		default:
			freqMin = 134.0F;
			freqMax = 500.0F;
			break;
		}
		strcat(html, "<tr>\n");
		strcat(html, "<td align=\"right\"><b>TX Frequency:</b></td>\n");

		snprintf(temp_buffer, sizeof(temp_buffer), "<td style=\"text-align: left;\"><input type=\"number\" id=\"tx_freq\" name=\"tx_freq\" min=\"%.4f\" max=\"%.4f\"\n", freqMin, freqMax);
		strcat(html, temp_buffer);
		snprintf(temp_buffer, sizeof(temp_buffer), "step=\"0.0001\" value=\"%.4f\" /> MHz</td>\n", config.freq_tx);
		strcat(html, temp_buffer);

		strcat(html, "</tr>\n");
		strcat(html, "<tr>\n");
		strcat(html, "<td align=\"right\"><b>RX Frequency:</b></td>\n");

		snprintf(temp_buffer, sizeof(temp_buffer), "<td style=\"text-align: left;\"><input type=\"number\" id=\"rx_freq\" name=\"rx_freq\" min=\"%.4f\" max=\"%.4f\"\n", freqMin, freqMax);
		strcat(html, temp_buffer);
		snprintf(temp_buffer, sizeof(temp_buffer), "step=\"0.0001\" value=\"%.4f\" /> Mhz</td>\n", config.freq_rx);
		strcat(html, temp_buffer);

		strcat(html, "</tr>\n");
		strcat(html, "<tr>\n");
		strcat(html, "<td align=\"right\"><b>TX CTCSS:</b></td>\n");
		strcat(html, "<td style=\"text-align: left;\">\n");
		strcat(html, "<select name=\"tx_ctcss\" id=\"tx_ctcss\">\n");
		for (int i = 0; i < 39; i++)
		{
			snprintf(temp_buffer, sizeof(temp_buffer), "<option value=\"%d\" ", i);
			strcat(html, temp_buffer);
			if (config.tone_tx == i)
			{
				strcat(html, "selected>");
			}
			else
			{
				strcat(html, ">");
			}
			snprintf(temp_buffer, sizeof(temp_buffer), "%.1f</option>\n", ctcss[i]);
			strcat(html, temp_buffer);
		}
		strcat(html, "</select> Hz\n");
		strcat(html, "</td>\n");
		strcat(html, "</tr>\n");
		strcat(html, "<tr>\n");
		strcat(html, "<td align=\"right\"><b>RX CTCSS:</b></td>\n");
		strcat(html, "<td style=\"text-align: left;\">\n");
		strcat(html, "<select name=\"rx_ctcss\" id=\"rx_ctcss\">\n");
		strcat(html, "<option value=\"0\" selected>0.0</option>\n");
		for (int i = 0; i < 39; i++)
		{
			snprintf(temp_buffer, sizeof(temp_buffer), "<option value=\"%d\" ", i);
			strcat(html, temp_buffer);
			if (config.tone_rx == i)
			{
				strcat(html, "selected>");
			}
			else
			{
				strcat(html, ">");
			}
			snprintf(temp_buffer, sizeof(temp_buffer), "%.1f</option>\n", ctcss[i]);
			strcat(html, temp_buffer);
		}
		strcat(html, "</select> Hz\n");
		strcat(html, "</td>\n");
		strcat(html, "</tr>\n");
		strcat(html, "<tr>\n");
		strcat(html, "<td align=\"right\"><b>Narrow/Wide:</b></td>\n");
		strcat(html, "<td style=\"text-align: left;\">\n");
		strcat(html, "<select name=\"nw_band\" id=\"nw_band\">\n");

		if (config.band)
		{
			strcat(html, "<option value=\"0\" >12.5KHz</option>\n");
			strcat(html, "<option value=\"1\" selected>25.0KHz</option>\n");
		}
		else
		{
			strcat(html, "<option value=\"0\" selected>12.5KHz</option>\n");
			strcat(html, "<option value=\"1\" >25.0KHz</option>\n");
		}
		strcat(html, "</select>\n");
		strcat(html, "</td>\n");
		strcat(html, "</tr>\n");
		strcat(html, "<tr>\n");
		strcat(html, "<td align=\"right\"><b>TX Power:</b></td>\n");
		strcat(html, "<td style=\"text-align: left;\">\n");
		strcat(html, "<select name=\"rf_power\" id=\"rf_power\">\n");

		if (config.rf_power)
		{
			strcat(html, "<option value=\"1\" selected>HIGH</option>\n");
			strcat(html, "<option value=\"0\" >LOW</option>\n");
		}
		else
		{
			strcat(html, "<option value=\"1\" >HIGH</option>\n");
			strcat(html, "<option value=\"0\" selected>LOW</option>\n");
		}
		strcat(html, "</select>\n");
		strcat(html, "</td>\n");
		strcat(html, "</tr>\n");
		strcat(html, "<tr>\n");
		strcat(html, "<td align=\"right\"><b>VOLUME:</b></td>\n");

		snprintf(temp_buffer, sizeof(temp_buffer), "<td style=\"text-align: left;\"><input id=\"sliderVolume\" name=\"volume\" type=\"range\"\nmin=\"1\" max=\"8\" value=\"%d\" /><b><span style=\"font-size: 14pt;\" id=\"volShow\">%d</span></b></td>\n", config.volume, config.volume);
		strcat(html, temp_buffer);

		strcat(html, "</tr>\n");
		strcat(html, "<tr>\n");
		strcat(html, "<td align=\"right\"><b>SQL Level:</b></td>\n");

		snprintf(temp_buffer, sizeof(temp_buffer), "<td style=\"text-align: left;\"><input id=\"sliderSql\" name=\"sql_level\" type=\"range\"\nmin=\"0\" max=\"8\" value=\"%d\" /><b><span style=\"font-size: 14pt;\" id=\"sqlShow\">%d</span></b></td>\n", config.sql_level, config.sql_level);
		strcat(html, temp_buffer);

		strcat(html, "</tr>\n");
		strcat(html, "<tr><td colspan=\"2\" align=\"right\">\n");
		strcat(html, "<div><button class=\"button\" type='submit' id='submitRadio'  name=\"commitRadio\"> Apply Change </button></div>\n");
		strcat(html, "<input type=\"hidden\" name=\"commitRadio\"/>\n");
		strcat(html, "</td></tr></table><br />\n");
		strcat(html, "</form>");

		// AFSK,TNC Configuration
		strcat(html, "<form id='formTNC' method=\"POST\" action='#' enctype='multipart/form-data'>\n");
		strcat(html, "<table>\n");
		strcat(html, "<th colspan=\"2\"><span><b>AFSK/TNC Configuration</b></span></th>\n");
		strcat(html, "<tr>\n");
		strcat(html, "<td align=\"right\"><b>Modem Type:</b></td>\n");
		strcat(html, "<td style=\"text-align: left;\">\n");
		strcat(html, "<select name=\"modem_type\" id=\"modem_type\" \">\n");
		#ifdef CONFIG_IDF_TARGET_ESP32S3
		for (int i = 0; i < 4; i++)
		#else 
		for (int i = 0; i < 3; i++)
		#endif
		{
			snprintf(temp_buffer, sizeof(temp_buffer), "<option value=\"%d\" ", i);
			strcat(html, temp_buffer);
			if (config.modem_type == i)
			{
				strcat(html, "selected>");
			}
			else
			{
				strcat(html, ">");
			}
			snprintf(temp_buffer, sizeof(temp_buffer), "%s</option>\n", MODEM_TYPE[i]);
			strcat(html, temp_buffer);
		}
		strcat(html, "</select>\n");
		strcat(html, "</td>\n");
		strcat(html, "<tr>\n");
		strcat(html, "<td align=\"right\"><b>FX.25 Mode:</b></td>\n");
		strcat(html, "<td style=\"text-align: left;\">\n");
		strcat(html, "<select name=\"fx25_mode\" id=\"fx25_mode\" \">\n");
		for (int i = 0; i < 3; i++)
		{
			snprintf(temp_buffer, sizeof(temp_buffer), "<option value=\"%d\" ", i);
			strcat(html, temp_buffer);
			if (config.fx25_mode == i)
			{
				strcat(html, "selected>");
			}
			else
			{
				strcat(html, ">");
			}
			snprintf(temp_buffer, sizeof(temp_buffer), "%s</option>\n", FX25_MODE[i]);
			strcat(html, temp_buffer);
		}
		strcat(html, "</select>  (FX.25 = AX.25 + FEC)\n");
		strcat(html, "</td>\n");
		strcat(html, "<tr>\n");
		// strcat(html, "<td align=\"right\"><b>Audio HPF:</b></td>\n");
		// char strFlag[32] = "";
		// if (config.audio_hpf)
		// 	strcpy(strFlag, "checked");
		// snprintf(temp_buffer, sizeof(temp_buffer), "<td style=\"text-align: left;\"><label class=\"switch\"><input type=\"checkbox\" name=\"HPF\" value=\"OK\" %s><span class=\"slider round\"></span></label><label style=\"vertical-align: bottom;font-size: 8pt;\"><i> *Audio high pass filter >1KHz cutoff 10Khz</i></label></td>\n", strFlag);
		// strcat(html, temp_buffer);
		// strcat(html, "</tr>\n");
		strcat(html, "<tr>\n");
		strcat(html, "<td align=\"right\"><b>Deemphasis Audio:</b></td>\n");
		if (config.audio_lpf)
		{
			strcat(html, "<td style=\"text-align: left;\"><label class=\"switch\"><input type=\"checkbox\" name=\"LPF\" value=\"OK\" checked><span class=\"slider round\"></span></label><label style=\"vertical-align: bottom;font-size: 8pt;\"><i> *Audio low pass filter 1hz-2.5KHz</i></label></td>\n");
		}
		else
		{
			strcat(html, "<td style=\"text-align: left;\"><label class=\"switch\"><input type=\"checkbox\" name=\"LPF\" value=\"OK\" ><span class=\"slider round\"></span></label><label style=\"vertical-align: bottom;font-size: 8pt;\"><i> *Audio low pass filter 1hz-2.5KHz</i></label></td>\n");
		}
		strcat(html, "</tr>\n");
		strcat(html, "<tr>\n");
		strcat(html, "<td align=\"right\"><b>TX Time Slot:</b></td>\n");

		snprintf(temp_buffer, sizeof(temp_buffer), "<td style=\"text-align: left;\"><input type=\"number\" name=\"timeSlot\" min=\"0\" max=\"99999\"\nstep=\"100\" value=\"%d\" /> mSec.</td>\n", config.tx_timeslot);
		strcat(html, temp_buffer);

		strcat(html, "</tr>\n");
		strcat(html, "<tr>\n");
		strcat(html, "<td align=\"right\"><b>Preamble:</b></td>\n");
		strcat(html, "<td style=\"text-align: left;\">\n");
		strcat(html, "<select name=\"preamble\">\n");
		for (int i = 1; i < 11; i++)
		{
			snprintf(temp_buffer, sizeof(temp_buffer), "<option value=\"%d\" ", i);
			strcat(html, temp_buffer);
			if (config.preamble == i)
			{
				strcat(html, "selected>");
			}
			else
			{
				strcat(html, ">");
			}
			snprintf(temp_buffer, sizeof(temp_buffer), "%d</option>\n", i * 100);
			strcat(html, temp_buffer);
		}
		strcat(html, "</select> mSec.\n");
		strcat(html, "</td>\n");
		strcat(html, "</tr>\n");
		strcat(html, "<tr><td colspan=\"2\" align=\"right\">\n");
		strcat(html, "<div><button class=\"button\" type='submit' id='submitTNC'  name=\"commitTNC\"> Apply Change </button></div>\n");
		strcat(html, "<input type=\"hidden\" name=\"commitTNC\"/>\n");
		strcat(html, "</td></tr></table><br />\n");
		strcat(html, "</form>");
		// request->send(200, "text/html", html); // send to someones browser when asked
		//request->send_P(200, "text/html", html);

		AsyncWebServerResponse *response = request->beginResponse(200, "text/html", (const char *)html);
		response->addHeader("Sysinfo", "content");
		response->addHeader("Cache-Control", "no-cache");
		request->send(response);
		free(html); // Free the allocated memory
	}
}

void handle_vpn(AsyncWebServerRequest *request)
{
	if (!request->authenticate(config.http_username, config.http_password))
	{
		return request->requestAuthentication();
	}
	StandByTick = millis() + (config.pwr_stanby_delay * 1000);

	if (request->hasArg("commitVPN"))
	{
		bool vpnEn = false;
		for (uint8_t i = 0; i < request->args(); i++)
		{
			// Serial.print("SERVER ARGS ");
			// Serial.print(request->argName(i));
			// Serial.print("=");
			// Serial.println(request->arg(i));

			if (request->argName(i) == "vpnEnable")
			{
				if (request->arg(i) != "")
				{
					// if (isValidNumber(request->arg(i)))
					if (strcmp(request->arg(i).c_str(), "OK") == 0)
						vpnEn = true;
				}
			}

			// if (request->argName(i) == "taretime") {
			//	if (request->arg(i) != "")
			//	{
			//		//if (isValidNumber(request->arg(i)))
			//		if (strcmp(request->arg(i).c_str(), "OK") == 0)
			//			taretime = true;
			//	}
			// }
			if (request->argName(i) == "wg_port")
			{
				if (request->arg(i) != "")
				{
					config.wg_port = request->arg(i).toInt();
				}
			}

			if (request->argName(i) == "wg_public_key")
			{
				if (request->arg(i) != "")
				{
					strcpy(config.wg_public_key, request->arg(i).c_str());
					config.wg_public_key[44] = 0;
				}
			}

			if (request->argName(i) == "wg_private_key")
			{
				if (request->arg(i) != "")
				{
					strcpy(config.wg_private_key, request->arg(i).c_str());
					config.wg_private_key[44] = 0;
				}
			}

			if (request->argName(i) == "wg_peer_address")
			{
				if (request->arg(i) != "")
				{
					strcpy(config.wg_peer_address, request->arg(i).c_str());
				}
			}

			if (request->argName(i) == "wg_local_address")
			{
				if (request->arg(i) != "")
				{
					strcpy(config.wg_local_address, request->arg(i).c_str());
				}
			}

			if (request->argName(i) == "wg_netmask_address")
			{
				if (request->arg(i) != "")
				{
					strcpy(config.wg_netmask_address, request->arg(i).c_str());
				}
			}

			if (request->argName(i) == "wg_gw_address")
			{
				if (request->arg(i) != "")
				{
					strcpy(config.wg_gw_address, request->arg(i).c_str());
				}
			}
		}

		config.vpn = vpnEn;
		saveConfig(request);
	}
	else
	{
		// Using dynamic memory allocation instead of String
		char *html = allocateStringMemory(8192); // Initial buffer size, adjust as needed
		if (!html)
		{
			return; // Memory allocation failed
		}

		strcpy(html, "<script type=\"text/javascript\">\n");
		strcat(html, "$('form').submit(function (e) {\n");
		strcat(html, "e.preventDefault();\n");
		strcat(html, "var data = new FormData(e.currentTarget);\n");
		strcat(html, "if(e.currentTarget.id===\"formVPN\") document.getElementById(\"submitVPN\").disabled=true;\n");
		strcat(html, "$.ajax({\n");
		strcat(html, "url: '/vpn',\n");
		strcat(html, "type: 'POST',\n");
		strcat(html, "data: data,\n");
		strcat(html, "contentType: false,\n");
		strcat(html, "processData: false,\n");
		strcat(html, "success: function (data) {\n");
		strcat(html, "alert(\"Submited Successfully\");\n");
		strcat(html, "},\n");
		strcat(html, "error: function (data) {\n");
		strcat(html, "alert(\"An error occurred.\");\n");
		strcat(html, "}\n");
		strcat(html, "});\n");
		strcat(html, "});\n");

		// Get MAC address and remove colons
		String ESP32_ID = WiFi.macAddress();
		ESP32_ID.replace(":", "");
		char temp_buffer[512];
		snprintf(temp_buffer, sizeof(temp_buffer), "function loadVPNConfig() {\nconst url = \"http://hs1.hs5tqa.ampr.org:81/wg/create\";\nconst espID = {'name': '%s'};\n", ESP32_ID.c_str());
		strcat(html, temp_buffer);
		strcat(html, "fetch(url,{\n");
		strcat(html, "method: 'POST',\n");
		strcat(html, "body: JSON.stringify(espID),\n");
		strcat(html, "headers: { 'Content-Type': 'application/json', 'Access-Control-Allow-Headers': 'Content-Type', 'Access-Control-Allow-Origin': '*','Access-Control-Allow-Methods': 'POST,GET,OPTIONS'}\n");
		strcat(html, "})\n");
		strcat(html, ".then(response => response.json())\n");
		strcat(html, ".then(data => {\n");
		strcat(html, "console.log(\"VPN Data:\", data);\n");
		strcat(html, "document.getElementById(\"wg_enable\").checked = true;\n");
		strcat(html, "document.getElementById(\"wg_peer_address\").value = data.Enpoint.split(\":\")[0];\n");
		strcat(html, "document.getElementById(\"wg_port\").value = data.Enpoint.split(\":\")[1];\n");
		strcat(html, "document.getElementById(\"wg_local_address\").value = data.Address;\n");
		strcat(html, "document.getElementById(\"wg_netmask_address\").value = \"255.255.255.0\";\n");
		strcat(html, "document.getElementById(\"wg_gw_address\").value = data.Gateway;\n");
		strcat(html, "document.getElementById(\"wg_public_key\").value = data.PublicKey;\n");
		strcat(html, "document.getElementById(\"wg_private_key\").value = data.PrivateKey;\n");
		strcat(html, "})\n");
		strcat(html, ".catch(err => console.error(\"VPN API Error:\", err));\n}\n");
		strcat(html, "</script>\n");
		// ===== JavaScript AJAX =====
		// strcat(html, "<script>\n");
		// strcat(html, "function loadVPNConfig() {\n");
		// strcat(html, "  $.ajax({\n");
		// strcat(html, "    url: '/api/vpnreq',\n");
		// strcat(html, "    method: 'GET',\n");
		// strcat(html, "    dataType: 'json',\n");
		// strcat(html, "    success: function(data) {\n");
		// strcat(html, "       console.log(data);\n");
		// strcat(html, "       let ep = data.Enpoint.split(':');\n");
		// strcat(html, "       $('#wg_peer_address').val(ep[0]);\n");
		// strcat(html, "       $('#wg_port').val(ep[1]);\n");
		// strcat(html, "       $('#wg_local_address').val(data.Address);\n");
		// strcat(html, "       $('#wg_public_key').val(data.PublicKey);\n");
		// strcat(html, "       $('#wg_private_key').val(data.PrivateKey);\n");
		// strcat(html, "    },\n");
		// strcat(html, "    error: function(e) {\n");
		// strcat(html, "       alert('โหลดข้อมูล VPN ไม่สำเร็จ');\n");
		// strcat(html, "       console.log(e);\n");
		// strcat(html, "    }\n");
		// strcat(html, "  });\n");
		// strcat(html, "}\n");
		// strcat(html, "</script>");

		// strcat(html, "<h2>System Setting</h2>\n");
		strcat(html, "<form accept-charset=\"UTF-8\" action=\"#\" class=\"form-horizontal\" id=\"fromVPN\" method=\"post\">\n");
		strcat(html, "<table>\n");
		strcat(html, "<th colspan=\"2\"><span><b>Wireguard Configuration</b></span></th>\n");
		strcat(html, "<tr>");

		// Handle sync flag
		if (config.vpn)
		{
			strcat(html, "<td align=\"right\"><b>Enable</b></td>\n");
			strcat(html, "<td style=\"text-align: left;\"><label class=\"switch\"><input type=\"checkbox\" id=\"wg_enable\" name=\"vpnEnable\" value=\"OK\" checked><span class=\"slider round\"></span></label></td>\n");
		}
		else
		{
			strcat(html, "<td align=\"right\"><b>Enable</b></td>\n");
			strcat(html, "<td style=\"text-align: left;\"><label class=\"switch\"><input type=\"checkbox\" id=\"wg_enable\" name=\"vpnEnable\" value=\"OK\" ><span class=\"slider round\"></span></label></td>\n");
		}
		strcat(html, "</tr>\n");

		strcat(html, "<tr>\n");
		strcat(html, "<td align=\"right\"><b>Server Address</b></td>\n");
		snprintf(temp_buffer, sizeof(temp_buffer), "<td style=\"text-align: left;\"><input  size=\"20\" maxlength=\"32\" id=\"wg_peer_address\" name=\"wg_peer_address\" type=\"text\" value=\"%s\" /></td>\n", config.wg_peer_address);
		strcat(html, temp_buffer);
		strcat(html, "</tr>\n");

		strcat(html, "<tr>\n");
		strcat(html, "<td align=\"right\"><b>Server Port</b></td>\n");
		snprintf(temp_buffer, sizeof(temp_buffer), "<td style=\"text-align: left;\"><input id=\"wg_port\" size=\"5\" name=\"wg_port\" type=\"number\" value=\"%d\" /></td>\n", config.wg_port);
		strcat(html, temp_buffer);
		strcat(html, "</tr>\n");

		strcat(html, "<tr>\n");
		strcat(html, "<td align=\"right\"><b>Local Address</b></td>\n");
		snprintf(temp_buffer, sizeof(temp_buffer), "<td style=\"text-align: left;\"><input id=\"wg_local_address\" name=\"wg_local_address\" type=\"text\" value=\"%s\" /></td>\n", config.wg_local_address);
		strcat(html, temp_buffer);
		strcat(html, "</tr>\n");

		strcat(html, "<tr>\n");
		strcat(html, "<td align=\"right\"><b>Netmask</b></td>\n");
		snprintf(temp_buffer, sizeof(temp_buffer), "<td style=\"text-align: left;\"><input id=\"wg_netmask_address\" name=\"wg_netmask_address\" type=\"text\" value=\"%s\" /></td>\n", config.wg_netmask_address);
		strcat(html, temp_buffer);
		strcat(html, "</tr>\n");

		strcat(html, "<tr>\n");
		strcat(html, "<td align=\"right\"><b>Gateway</b></td>\n");
		snprintf(temp_buffer, sizeof(temp_buffer), "<td style=\"text-align: left;\"><input id=\"wg_gw_address\" name=\"wg_gw_address\" type=\"text\" value=\"%s\" /></td>\n", config.wg_gw_address);
		strcat(html, temp_buffer);
		strcat(html, "</tr>\n");

		strcat(html, "<tr>\n");
		strcat(html, "<td align=\"right\"><b>Public Server Key</b></td>\n");
		snprintf(temp_buffer, sizeof(temp_buffer), "<td style=\"text-align: left;\"><input size=\"50\" maxlength=\"44\" id=\"wg_public_key\" name=\"wg_public_key\" type=\"text\" value=\"%s\" /></td>\n", config.wg_public_key);
		strcat(html, temp_buffer);
		strcat(html, "</tr>\n");

		strcat(html, "<tr>\n");
		strcat(html, "<td align=\"right\"><b>Private Client Key</b></td>\n");
		snprintf(temp_buffer, sizeof(temp_buffer), "<td style=\"text-align: left;\"><input size=\"50\" maxlength=\"44\" id=\"wg_private_key\" name=\"wg_private_key\" type=\"text\" value=\"%s\" /></td>\n", config.wg_private_key);
		strcat(html, temp_buffer);
		strcat(html, "</tr>\n");

		strcat(html, "<tr><td colspan=\"2\" align=\"right\">\n");
		strcat(html, "<div><button class=\"button\" type='submit' id='submitVPN'  name=\"commitVPN\"> Apply Change </button></div>\n");
		strcat(html, "<input type=\"hidden\" name=\"commitVPN\"/>\n");
		strcat(html, "</td></tr></table><br />\n");
		strcat(html, "</form><br /><br />");

		strcat(html, "<form accept-charset=\"UTF-8\" action=\"#\" class=\"form-horizontal\" id=\"fromGetVPN\" method=\"post\">\n");
		strcat(html, "<table>\n");
		strcat(html, "<th colspan=\"2\"><span><b>Helper: Free VPN Wireguard for Web Service</b></span></th>\n");
		strcat(html, "<tr><td align=\"left\">1. Click New Register button to get VPN config from web service.</td></tr>\n");
		strcat(html, "<tr><td align=\"left\">2. The VPN config will fill in the form automatically.</td></tr>\n");
		strcat(html, "<tr><td align=\"left\">3. Click Apply Change and reboot again.</td></tr>\n");
		strcat(html, "<tr><td align=\"left\">4. Enjoy your free VPN service!</td></tr>\n");

		// Check if local address starts with "10.44."
		String wg_local_addr = String(config.wg_local_address);
		if (wg_local_addr.startsWith("10.44."))
		{
			int lastoct = wg_local_addr.substring(wg_local_addr.lastIndexOf('.') + 1).toInt();
			// String url="http://"+String(config.wg_peer_address)+":"+String(8000+lastoct);
			// strcat(html, "<tr><td>Your External Host IP: <a href=\"");
			// snprintf(temp_buffer, sizeof(temp_buffer), "%s\">%s</a></td></tr>\n", url.c_str(), url.c_str());
			// strcat(html, temp_buffer);
			int thirdoct = wg_local_addr.substring(wg_local_addr.indexOf('.', wg_local_addr.indexOf('.') + 1) + 1, wg_local_addr.lastIndexOf('.')).toInt();
			String url_base = "http://hs" + String(thirdoct) + ".hs5tqa.ampr.org:" + String((thirdoct * 10000) + 8000 + lastoct);
			snprintf(temp_buffer, sizeof(temp_buffer), "<tr><td>Your External by AMPR URL: <a href=\"%s\" target=\"_blank\">%s</a></td></tr>\n", url_base.c_str(), url_base.c_str());
			strcat(html, temp_buffer);
			url_base = "http://vpn.nakhonthai.net:" + String((thirdoct * 10000) + 8000 + lastoct);
			snprintf(temp_buffer, sizeof(temp_buffer), "<tr><td>Fast Direct URL: <a href=\"%s\" target=\"_blank\">%s</a></td></tr>\n", url_base.c_str(), url_base.c_str());
			strcat(html, temp_buffer);
		}
		strcat(html, "<tr><td><button type=\"button\" onclick=\"loadVPNConfig()\">New Register</button></td></tr>\n");
		strcat(html, "</table><br />\n");
		strcat(html, "</form>");

		// request->send(200, "text/html", html); // send to someones browser when asked
		AsyncWebServerResponse *response = request->beginResponse(200, "text/html", (const char *)html);
		response->addHeader("VPN", "content");
		response->addHeader("Cache-Control", "no-cache");
		request->send(response);
		free(html); // Free the allocated memory
	}
}
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
