nakhonthai/ESP32APRS_Audio/src/handleATCommand.cpp

#include <Arduino.h>
#include "handleATCommand.h"
#include "config.h"
#include <WiFi.h>

extern Configuration config;

String handleATCommand(String cmd)
{
    cmd.trim();
    if (!cmd.startsWith("AT"))
        return "";
    if (cmd == "AT")
        return "OK";

    if (cmd == "AT+RESET" || cmd == "AT+RESTART")
    {
        log_d("CMD Reset System");
        delay(3000);
        esp_restart();
    }

    // if(cmd == "AT+VERSION?")
    // {
    //     String ver = "Firmware Version: " + String(FIRMWARE_VERSION);
    //     ver += ", SDK Version: " + String(ESP.getSdkVersion());
    //     ver += ", Core Version: " + String(ARDUINO_ESP32_RELEASE);
    //     return ver;
    // }

    if (cmd == "AT+CHIPID?")
    {
        uint64_t chipid = ESP.getEfuseMac();
        String id = String((uint16_t)(chipid >> 32), HEX) + String((uint32_t)chipid, HEX);
        id.toUpperCase();
        return id;
    }

    if (cmd == "AT+SAVECONFIG")
    {
        if (saveConfiguration("/default.cfg", config))
        {
            return "Configuration Saved";
        }
        else
        {
            return "Failed to Save Configuration";
        }
    }

    if (cmd == "LOADCONFIG")
    {
        if (loadConfiguration("/default.cfg", config))
        {
            return "Configuration Loaded";
        }
        else
        {
            return "Failed to Load Configuration";
        }
    }

    if (cmd == "AT+WIFI_DISCONNECT")
    {
        WiFi.disconnect(true);
        return "WiFi Disconnected";
    }

    if (cmd == "AT+WIFI_CONNECT")
    {
        WiFi.reconnect();
        return "WiFi Reconnecting";
    }

    if (cmd == "AT+WIFI_STATUS?")
    {
        String status = "WiFi Status: ";
        if (WiFi.status() == WL_CONNECTED)
        {
            status += "Connected";
        }
        else
        {
            status += "Disconnected";
        }
        return status;
    }

    if (cmd == "AT+WIFI_SCAN")
    {
        int16_t n = WiFi.scanNetworks();
        String scanResult = "Scan Complete: " + String(n) + " networks found.\n";
        for (int i = 0; i < n; ++i)
        {
            scanResult += String(i + 1) + ": ";
            scanResult += WiFi.SSID(i);
            scanResult += ", RSSI: " + String(WiFi.RSSI(i)) + "dBm";
            scanResult += ", BSSID: " + WiFi.BSSIDstr(i);
            scanResult += ", Channel: " + String(WiFi.channel(i));
            scanResult += ", Encryption: " + String((int)WiFi.encryptionType(i)) + "\n";
        }
        WiFi.scanDelete();
        return scanResult;
    }

    if (cmd == "AT+WIFI?")
    {
        String mode = "";
        if (config.wifi_mode == WIFI_AP)
            mode = "AP";
        else if (config.wifi_mode == WIFI_STA)
            mode = "STA";
        else if (config.wifi_mode == WIFI_AP_STA)
            mode = "AP+STA";
        else
            mode = "OFF";
        mode = "Mode:" + mode + ",SSID:" + String(WiFi.SSID()) + ",RSSI:" + String(WiFi.RSSI()) + "dBm";
        return mode;
    }

    if (cmd == "AT+MODE?")
    {
        String mode = "MODE: ";
        if (config.igate_en)
            mode += "IGATE";
        if (config.digi_en)
            mode += ",DIGI";
        if (config.trk_en)
            mode += ",TRK";
        if (config.wx_en)
            mode += ",WX";
        if (config.tlm0_en)
            mode += ",TLM0";
        return mode;
    }

    if (cmd == "AT+TIME?")
    {
        struct tm tmstruct;
        char strTime[20];
        tmstruct.tm_year = 0;
        getLocalTime(&tmstruct, 100);
        sprintf(strTime, "%d-%02d-%02d %02d:%02d:%02d", (tmstruct.tm_year) + 1900, (tmstruct.tm_mon) + 1, tmstruct.tm_mday, tmstruct.tm_hour, tmstruct.tm_min, tmstruct.tm_sec);
        return String(strTime);
    }
    else if (cmd.startsWith("AT+TIME="))
    {
        cmd.remove(0, 8);
        cmd.replace("\"", "");
        char strTime[20];
        strncpy(strTime, cmd.c_str(), sizeof(strTime));
        String date = getValue(strTime, ' ', 0);
        String time = getValue(strTime, ' ', 1);
        int yyyy = getValue(date, '-', 0).toInt();
        int mm = getValue(date, '-', 1).toInt();
        int dd = getValue(date, '-', 2).toInt();
        int hh = getValue(time, ':', 0).toInt();
        int ii = getValue(time, ':', 1).toInt();
        int ss = getValue(time, ':', 2).toInt();
        // int ss = 0;

        tmElements_t timeinfo;
        timeinfo.Year = yyyy - 1970;
        timeinfo.Month = mm;
        timeinfo.Day = dd;
        timeinfo.Hour = hh;
        timeinfo.Minute = ii;
        timeinfo.Second = ss;
        time_t timeStamp = makeTime(timeinfo);
        time_t rtc = timeStamp - (config.timeZone * 3600);
        timeval tv = {rtc, 0};
        timezone tz = {(0) + DST_MN, 0};
        settimeofday(&tv, &tz);
        log_d("Set Time: %s", strTime);
        return "Set Time: " + String(strTime);
    }

    // Generate AT-Command from script python

    if (cmd == "AT+TIMEZONE?")
        return String(config.timeZone, 6);
    else if (cmd.startsWith("AT+TIMEZONE="))
    {
        config.timeZone = cmd.substring(12).toFloat();
        return "OK";
    }

    if (cmd == "AT+SYNCTIME?")
        return String(config.synctime ? "1" : "0");
    else if (cmd == "AT+SYNCTIME=1")
    {
        config.synctime = true;
        return "OK";
    }
    else if (cmd == "AT+SYNCTIME=0")
    {
        config.synctime = false;
        return "OK";
    }

    if (cmd == "AT+TITLE?")
        return String(config.title ? "1" : "0");
    else if (cmd == "AT+TITLE=1")
    {
        config.title = true;
        return "OK";
    }
    else if (cmd == "AT+TITLE=0")
    {
        config.title = false;
        return "OK";
    }

    if (cmd == "AT+WIFI_MODE?")
        return String(config.wifi_mode);
    else if (cmd.startsWith("AT+WIFI_MODE="))
    {
        config.wifi_mode = cmd.substring(13).toInt();
        return "OK";
    }

    if (cmd == "AT+WIFI_POWER?")
        return String(config.wifi_power);
    else if (cmd.startsWith("AT+WIFI_POWER="))
    {
        config.wifi_power = cmd.substring(14).toInt();
        return "OK";
    }

    // ---- WiFi STA 0 ----
    if (cmd == "AT+WIFI0EN?")
        return String(config.wifi_sta[0].enable ? "1" : "0");
    else if (cmd == "AT+WIFI0EN=1")
    {
        config.wifi_sta[0].enable = true;
        return "OK";
    }
    else if (cmd == "AT+WIFI0EN=0")
    {
        config.wifi_sta[0].enable = false;
        return "OK";
    }
    else if (cmd == "AT+WIFI0SSID?")
        return String(config.wifi_sta[0].wifi_ssid);
    else if (cmd.startsWith("AT+WIFI0SSID="))
    {
        cmd.remove(0, 13 + String(0).length());
        cmd.replace("\"", "");
        strncpy(config.wifi_sta[0].wifi_ssid, cmd.c_str(), sizeof(config.wifi_sta[0].wifi_ssid));
        return "OK";
    }
    else if (cmd == "AT+WIFI0PASS?")
        return String(config.wifi_sta[0].wifi_pass);
    else if (cmd.startsWith("AT+WIFI0PASS="))
    {
        cmd.remove(0, 13 + String(0).length());
        cmd.replace("\"", "");
        strncpy(config.wifi_sta[0].wifi_pass, cmd.c_str(), sizeof(config.wifi_sta[0].wifi_pass));
        return "OK";
    }

    // ---- WiFi STA 1 ----
    if (cmd == "AT+WIFI1EN?")
        return String(config.wifi_sta[1].enable ? "1" : "0");
    else if (cmd == "AT+WIFI1EN=1")
    {
        config.wifi_sta[1].enable = true;
        return "OK";
    }
    else if (cmd == "AT+WIFI1EN=0")
    {
        config.wifi_sta[1].enable = false;
        return "OK";
    }
    else if (cmd == "AT+WIFI1SSID?")
        return String(config.wifi_sta[1].wifi_ssid);
    else if (cmd.startsWith("AT+WIFI1SSID="))
    {
        cmd.remove(0, 13 + String(1).length());
        cmd.replace("\"", "");
        strncpy(config.wifi_sta[1].wifi_ssid, cmd.c_str(), sizeof(config.wifi_sta[1].wifi_ssid));
        return "OK";
    }
    else if (cmd == "AT+WIFI1PASS?")
        return String(config.wifi_sta[1].wifi_pass);
    else if (cmd.startsWith("AT+WIFI1PASS="))
    {
        cmd.remove(0, 13 + String(1).length());
        cmd.replace("\"", "");
        strncpy(config.wifi_sta[1].wifi_pass, cmd.c_str(), sizeof(config.wifi_sta[1].wifi_pass));
        return "OK";
    }

    // ---- WiFi STA 2 ----
    if (cmd == "AT+WIFI2EN?")
        return String(config.wifi_sta[2].enable ? "1" : "0");
    else if (cmd == "AT+WIFI2EN=1")
    {
        config.wifi_sta[2].enable = true;
        return "OK";
    }
    else if (cmd == "AT+WIFI2EN=0")
    {
        config.wifi_sta[2].enable = false;
        return "OK";
    }
    else if (cmd == "AT+WIFI2SSID?")
        return String(config.wifi_sta[2].wifi_ssid);
    else if (cmd.startsWith("AT+WIFI2SSID="))
    {
        cmd.remove(0, 13 + String(2).length());
        cmd.replace("\"", "");
        strncpy(config.wifi_sta[2].wifi_ssid, cmd.c_str(), sizeof(config.wifi_sta[2].wifi_ssid));
        return "OK";
    }
    else if (cmd == "AT+WIFI2PASS?")
        return String(config.wifi_sta[2].wifi_pass);
    else if (cmd.startsWith("AT+WIFI2PASS="))
    {
        cmd.remove(0, 13 + String(2).length());
        cmd.replace("\"", "");
        strncpy(config.wifi_sta[2].wifi_pass, cmd.c_str(), sizeof(config.wifi_sta[2].wifi_pass));
        return "OK";
    }

    // ---- WiFi STA 3 ----
    if (cmd == "AT+WIFI3EN?")
        return String(config.wifi_sta[3].enable ? "1" : "0");
    else if (cmd == "AT+WIFI3EN=1")
    {
        config.wifi_sta[3].enable = true;
        return "OK";
    }
    else if (cmd == "AT+WIFI3EN=0")
    {
        config.wifi_sta[3].enable = false;
        return "OK";
    }
    else if (cmd == "AT+WIFI3SSID?")
        return String(config.wifi_sta[3].wifi_ssid);
    else if (cmd.startsWith("AT+WIFI3SSID="))
    {
        cmd.remove(0, 13 + String(3).length());
        cmd.replace("\"", "");
        strncpy(config.wifi_sta[3].wifi_ssid, cmd.c_str(), sizeof(config.wifi_sta[3].wifi_ssid));
        return "OK";
    }
    else if (cmd == "AT+WIFI3PASS?")
        return String(config.wifi_sta[3].wifi_pass);
    else if (cmd.startsWith("AT+WIFI3PASS="))
    {
        cmd.remove(0, 13 + String(3).length());
        cmd.replace("\"", "");
        strncpy(config.wifi_sta[3].wifi_pass, cmd.c_str(), sizeof(config.wifi_sta[3].wifi_pass));
        return "OK";
    }

    // ---- WiFi STA 4 ----
    if (cmd == "AT+WIFI4EN?")
        return String(config.wifi_sta[4].enable ? "1" : "0");
    else if (cmd == "AT+WIFI4EN=1")
    {
        config.wifi_sta[4].enable = true;
        return "OK";
    }
    else if (cmd == "AT+WIFI4EN=0")
    {
        config.wifi_sta[4].enable = false;
        return "OK";
    }
    else if (cmd == "AT+WIFI4SSID?")
        return String(config.wifi_sta[4].wifi_ssid);
    else if (cmd.startsWith("AT+WIFI4SSID="))
    {
        cmd.remove(0, 13 + String(4).length());
        cmd.replace("\"", "");
        strncpy(config.wifi_sta[4].wifi_ssid, cmd.c_str(), sizeof(config.wifi_sta[4].wifi_ssid));
        return "OK";
    }
    else if (cmd == "AT+WIFI4PASS?")
        return String(config.wifi_sta[4].wifi_pass);
    else if (cmd.startsWith("AT+WIFI4PASS="))
    {
        cmd.remove(0, 13 + String(4).length());
        cmd.replace("\"", "");
        strncpy(config.wifi_sta[4].wifi_pass, cmd.c_str(), sizeof(config.wifi_sta[4].wifi_pass));
        return "OK";
    }

    if (cmd == "AT+WIFI_AP_CH?")
        return String(config.wifi_ap_ch);
    else if (cmd.startsWith("AT+WIFI_AP_CH="))
    {
        config.wifi_ap_ch = cmd.substring(14).toInt();
        return "OK";
    }

    if (cmd == "AT+WIFI_AP_SSID?")
        return String(config.wifi_ap_ssid);
    else if (cmd.startsWith("AT+WIFI_AP_SSID="))
    {
        cmd.remove(0, 16);
        cmd.replace("\"", "");
        strncpy(config.wifi_ap_ssid, cmd.c_str(), sizeof(config.wifi_ap_ssid));
        return "OK";
    }

    if (cmd == "AT+WIFI_AP_PASS?")
        return String(config.wifi_ap_pass);
    else if (cmd.startsWith("AT+WIFI_AP_PASS="))
    {
        cmd.remove(0, 16);
        cmd.replace("\"", "");
        strncpy(config.wifi_ap_pass, cmd.c_str(), sizeof(config.wifi_ap_pass));
        return "OK";
    }

    if (cmd == "AT+BT_SLAVE?")
        return String(config.bt_slave ? "1" : "0");
    else if (cmd == "AT+BT_SLAVE=1")
    {
        config.bt_slave = true;
        return "OK";
    }
    else if (cmd == "AT+BT_SLAVE=0")
    {
        config.bt_slave = false;
        return "OK";
    }

    if (cmd == "AT+BT_MASTER?")
        return String(config.bt_master ? "1" : "0");
    else if (cmd == "AT+BT_MASTER=1")
    {
        config.bt_master = true;
        return "OK";
    }
    else if (cmd == "AT+BT_MASTER=0")
    {
        config.bt_master = false;
        return "OK";
    }

    if (cmd == "AT+BT_MODE?")
        return String(config.bt_mode);
    else if (cmd.startsWith("AT+BT_MODE="))
    {
        config.bt_mode = cmd.substring(11).toInt();
        return "OK";
    }

    if (cmd == "AT+BT_UUID?")
        return String(config.bt_uuid);
    else if (cmd.startsWith("AT+BT_UUID="))
    {
        cmd.remove(0, 11);
        cmd.replace("\"", "");
        strncpy(config.bt_uuid, cmd.c_str(), sizeof(config.bt_uuid));
        return "OK";
    }

    if (cmd == "AT+BT_UUID_RX?")
        return String(config.bt_uuid_rx);
    else if (cmd.startsWith("AT+BT_UUID_RX="))
    {
        cmd.remove(0, 14);
        cmd.replace("\"", "");
        strncpy(config.bt_uuid_rx, cmd.c_str(), sizeof(config.bt_uuid_rx));
        return "OK";
    }

    if (cmd == "AT+BT_UUID_TX?")
        return String(config.bt_uuid_tx);
    else if (cmd.startsWith("AT+BT_UUID_TX="))
    {
        cmd.remove(0, 14);
        cmd.replace("\"", "");
        strncpy(config.bt_uuid_tx, cmd.c_str(), sizeof(config.bt_uuid_tx));
        return "OK";
    }

    if (cmd == "AT+BT_NAME?")
        return String(config.bt_name);
    else if (cmd.startsWith("AT+BT_NAME="))
    {
        cmd.remove(0, 11);
        cmd.replace("\"", "");
        strncpy(config.bt_name, cmd.c_str(), sizeof(config.bt_name));
        return "OK";
    }

    if (cmd == "AT+BT_PIN?")
        return String(config.bt_pin);
    else if (cmd.startsWith("AT+BT_PIN="))
    {
        config.bt_pin = cmd.substring(10).toInt();
        return "OK";
    }

    if (cmd == "AT+BT_POWER?")
        return String(config.bt_power);
    else if (cmd.startsWith("AT+BT_POWER="))
    {
        config.bt_power = cmd.substring(12).toInt();
        return "OK";
    }

    if (cmd == "AT+RF_EN?")
        return String(config.rf_en ? "1" : "0");
    else if (cmd == "AT+RF_EN=1")
    {
        config.rf_en = true;
        return "OK";
    }
    else if (cmd == "AT+RF_EN=0")
    {
        config.rf_en = false;
        return "OK";
    }

    if (cmd == "AT+RF_TYPE?")
        return String(config.rf_type);
    else if (cmd.startsWith("AT+RF_TYPE="))
    {
        config.rf_type = cmd.substring(11).toInt();
        return "OK";
    }

    if (cmd == "AT+FREQ_RX?")
        return String(config.freq_rx, 6);
    else if (cmd.startsWith("AT+FREQ_RX="))
    {
        config.freq_rx = cmd.substring(11).toFloat();
        return "OK";
    }

    if (cmd == "AT+FREQ_TX?")
        return String(config.freq_tx, 6);
    else if (cmd.startsWith("AT+FREQ_TX="))
    {
        config.freq_tx = cmd.substring(11).toFloat();
        return "OK";
    }

    if (cmd == "AT+OFFSET_RX?")
        return String(config.offset_rx);
    else if (cmd.startsWith("AT+OFFSET_RX="))
    {
        config.offset_rx = cmd.substring(13).toInt();
        return "OK";
    }

    if (cmd == "AT+OFFSET_TX?")
        return String(config.offset_tx);
    else if (cmd.startsWith("AT+OFFSET_TX="))
    {
        config.offset_tx = cmd.substring(13).toInt();
        return "OK";
    }

    if (cmd == "AT+TONE_RX?")
        return String(config.tone_rx);
    else if (cmd.startsWith("AT+TONE_RX="))
    {
        config.tone_rx = cmd.substring(11).toInt();
        return "OK";
    }

    if (cmd == "AT+TONE_TX?")
        return String(config.tone_tx);
    else if (cmd.startsWith("AT+TONE_TX="))
    {
        config.tone_tx = cmd.substring(11).toInt();
        return "OK";
    }

    if (cmd == "AT+BAND?")
        return String(config.band);
    else if (cmd.startsWith("AT+BAND="))
    {
        config.band = cmd.substring(8).toInt();
        return "OK";
    }

    if (cmd == "AT+SQL_LEVEL?")
        return String(config.sql_level);
    else if (cmd.startsWith("AT+SQL_LEVEL="))
    {
        config.sql_level = cmd.substring(13).toInt();
        return "OK";
    }

    if (cmd == "AT+RF_POWER?")
        return String(config.rf_power ? "1" : "0");
    else if (cmd == "AT+RF_POWER=1")
    {
        config.rf_power = true;
        return "OK";
    }
    else if (cmd == "AT+RF_POWER=0")
    {
        config.rf_power = false;
        return "OK";
    }

    if (cmd == "AT+VOLUME?")
        return String(config.volume);
    else if (cmd.startsWith("AT+VOLUME="))
    {
        config.volume = cmd.substring(10).toInt();
        return "OK";
    }

    if (cmd == "AT+MIC?")
        return String(config.mic);
    else if (cmd.startsWith("AT+MIC="))
    {
        config.mic = cmd.substring(7).toInt();
        return "OK";
    }

    if (cmd == "AT+IGATE_EN?")
        return String(config.igate_en ? "1" : "0");
    else if (cmd == "AT+IGATE_EN=1")
    {
        config.igate_en = true;
        return "OK";
    }
    else if (cmd == "AT+IGATE_EN=0")
    {
        config.igate_en = false;
        return "OK";
    }

    if (cmd == "AT+RF2INET?")
        return String(config.rf2inet ? "1" : "0");
    else if (cmd == "AT+RF2INET=1")
    {
        config.rf2inet = true;
        return "OK";
    }
    else if (cmd == "AT+RF2INET=0")
    {
        config.rf2inet = false;
        return "OK";
    }

    if (cmd == "AT+INET2RF?")
        return String(config.inet2rf ? "1" : "0");
    else if (cmd == "AT+INET2RF=1")
    {
        config.inet2rf = true;
        return "OK";
    }
    else if (cmd == "AT+INET2RF=0")
    {
        config.inet2rf = false;
        return "OK";
    }

    if (cmd == "AT+IGATE_LOC2RF?")
        return String(config.igate_loc2rf ? "1" : "0");
    else if (cmd == "AT+IGATE_LOC2RF=1")
    {
        config.igate_loc2rf = true;
        return "OK";
    }
    else if (cmd == "AT+IGATE_LOC2RF=0")
    {
        config.igate_loc2rf = false;
        return "OK";
    }

    if (cmd == "AT+IGATE_LOC2INET?")
        return String(config.igate_loc2inet ? "1" : "0");
    else if (cmd == "AT+IGATE_LOC2INET=1")
    {
        config.igate_loc2inet = true;
        return "OK";
    }
    else if (cmd == "AT+IGATE_LOC2INET=0")
    {
        config.igate_loc2inet = false;
        return "OK";
    }

    if (cmd == "AT+RF2INETFILTER?")
        return String(config.rf2inetFilter);
    else if (cmd.startsWith("AT+RF2INETFILTER="))
    {
        config.rf2inetFilter = cmd.substring(17).toInt();
        return "OK";
    }

    if (cmd == "AT+INET2RFFILTER?")
        return String(config.inet2rfFilter);
    else if (cmd.startsWith("AT+INET2RFFILTER="))
    {
        config.inet2rfFilter = cmd.substring(17).toInt();
        return "OK";
    }

    if (cmd == "AT+APRS_SSID?")
        return String(config.aprs_ssid);
    else if (cmd.startsWith("AT+APRS_SSID="))
    {
        config.aprs_ssid = cmd.substring(13).toInt();
        return "OK";
    }

    if (cmd == "AT+APRS_PORT?")
        return String(config.aprs_port);
    else if (cmd.startsWith("AT+APRS_PORT="))
    {
        config.aprs_port = cmd.substring(13).toInt();
        return "OK";
    }

    if (cmd == "AT+APRS_MYCALL?")
        return String(config.aprs_mycall);
    else if (cmd.startsWith("AT+APRS_MYCALL="))
    {
        cmd.remove(0, 15);
        cmd.replace("\"", "");
        strncpy(config.aprs_mycall, cmd.c_str(), sizeof(config.aprs_mycall));
        return "OK";
    }

    if (cmd == "AT+APRS_HOST?")
        return String(config.aprs_host);
    else if (cmd.startsWith("AT+APRS_HOST="))
    {
        cmd.remove(0, 13);
        cmd.replace("\"", "");
        strncpy(config.aprs_host, cmd.c_str(), sizeof(config.aprs_host));
        return "OK";
    }

    if (cmd == "AT+APRS_PASSCODE?")
        return String(config.aprs_passcode);
    else if (cmd.startsWith("AT+APRS_PASSCODE="))
    {
        cmd.remove(0, 17);
        cmd.replace("\"", "");
        strncpy(config.aprs_passcode, cmd.c_str(), sizeof(config.aprs_passcode));
        return "OK";
    }

    if (cmd == "AT+APRS_MONICALL?")
        return String(config.aprs_moniCall);
    else if (cmd.startsWith("AT+APRS_MONICALL="))
    {
        cmd.remove(0, 17);
        cmd.replace("\"", "");
        strncpy(config.aprs_moniCall, cmd.c_str(), sizeof(config.aprs_moniCall));
        return "OK";
    }

    if (cmd == "AT+APRS_FILTER?")
        return String(config.aprs_filter);
    else if (cmd.startsWith("AT+APRS_FILTER="))
    {
        cmd.remove(0, 15);
        cmd.replace("\"", "");
        strncpy(config.aprs_filter, cmd.c_str(), sizeof(config.aprs_filter));
        return "OK";
    }

    if (cmd == "AT+IGATE_BCN?")
        return String(config.igate_bcn ? "1" : "0");
    else if (cmd == "AT+IGATE_BCN=1")
    {
        config.igate_bcn = true;
        return "OK";
    }
    else if (cmd == "AT+IGATE_BCN=0")
    {
        config.igate_bcn = false;
        return "OK";
    }

    if (cmd == "AT+IGATE_GPS?")
        return String(config.igate_gps ? "1" : "0");
    else if (cmd == "AT+IGATE_GPS=1")
    {
        config.igate_gps = true;
        return "OK";
    }
    else if (cmd == "AT+IGATE_GPS=0")
    {
        config.igate_gps = false;
        return "OK";
    }

    if (cmd == "AT+IGATE_TIMESTAMP?")
        return String(config.igate_timestamp ? "1" : "0");
    else if (cmd == "AT+IGATE_TIMESTAMP=1")
    {
        config.igate_timestamp = true;
        return "OK";
    }
    else if (cmd == "AT+IGATE_TIMESTAMP=0")
    {
        config.igate_timestamp = false;
        return "OK";
    }

    if (cmd == "AT+IGATE_LAT?")
        return String(config.igate_lat, 6);
    else if (cmd.startsWith("AT+IGATE_LAT="))
    {
        config.igate_lat = cmd.substring(13).toFloat();
        return "OK";
    }

    if (cmd == "AT+IGATE_LON?")
        return String(config.igate_lon, 6);
    else if (cmd.startsWith("AT+IGATE_LON="))
    {
        config.igate_lon = cmd.substring(13).toFloat();
        return "OK";
    }

    if (cmd == "AT+IGATE_ALT?")
        return String(config.igate_alt, 6);
    else if (cmd.startsWith("AT+IGATE_ALT="))
    {
        config.igate_alt = cmd.substring(13).toFloat();
        return "OK";
    }

    if (cmd == "AT+IGATE_INTERVAL?")
        return String(config.igate_interval);
    else if (cmd.startsWith("AT+IGATE_INTERVAL="))
    {
        config.igate_interval = cmd.substring(18).toInt();
        return "OK";
    }

    if (cmd == "AT+IGATE_SYMBOL?")
        return String(config.igate_symbol);
    else if (cmd.startsWith("AT+IGATE_SYMBOL="))
    {
        cmd.remove(0, 16);
        cmd.replace("\"", "");
        strncpy(config.igate_symbol, cmd.c_str(), sizeof(config.igate_symbol));
        return "OK";
    }

    if (cmd == "AT+IGATE_OBJECT?")
        return String(config.igate_object);
    else if (cmd.startsWith("AT+IGATE_OBJECT="))
    {
        cmd.remove(0, 16);
        cmd.replace("\"", "");
        strncpy(config.igate_object, cmd.c_str(), sizeof(config.igate_object));
        return "OK";
    }

    if (cmd == "AT+IGATE_PHG?")
        return String(config.igate_phg);
    else if (cmd.startsWith("AT+IGATE_PHG="))
    {
        cmd.remove(0, 13);
        cmd.replace("\"", "");
        strncpy(config.igate_phg, cmd.c_str(), sizeof(config.igate_phg));
        return "OK";
    }

    if (cmd == "AT+IGATE_PATH?")
        return String(config.igate_path);
    else if (cmd.startsWith("AT+IGATE_PATH="))
    {
        config.igate_path = cmd.substring(14).toInt();
        return "OK";
    }

    if (cmd == "AT+IGATE_COMMENT?")
        return String(config.igate_comment);
    else if (cmd.startsWith("AT+IGATE_COMMENT="))
    {
        cmd.remove(0, 17);
        cmd.replace("\"", "");
        strncpy(config.igate_comment, cmd.c_str(), sizeof(config.igate_comment));
        return "OK";
    }

    if (cmd == "AT+IGATE_STS_INTERVAL?")
        return String(config.igate_sts_interval);
    else if (cmd.startsWith("AT+IGATE_STS_INTERVAL="))
    {
        config.igate_sts_interval = cmd.substring(22).toInt();
        return "OK";
    }

    if (cmd == "AT+IGATE_STATUS?")
        return String(config.igate_status);
    else if (cmd.startsWith("AT+IGATE_STATUS="))
    {
        cmd.remove(0, 16);
        cmd.replace("\"", "");
        strncpy(config.igate_status, cmd.c_str(), sizeof(config.igate_status));
        return "OK";
    }

    if (cmd == "AT+DIGI_EN?")
        return String(config.digi_en ? "1" : "0");
    else if (cmd == "AT+DIGI_EN=1")
    {
        config.digi_en = true;
        return "OK";
    }
    else if (cmd == "AT+DIGI_EN=0")
    {
        config.digi_en = false;
        return "OK";
    }

    if (cmd == "AT+DIGI_AUTO?")
        return String(config.digi_auto ? "1" : "0");
    else if (cmd == "AT+DIGI_AUTO=1")
    {
        config.digi_auto = true;
        return "OK";
    }
    else if (cmd == "AT+DIGI_AUTO=0")
    {
        config.digi_auto = false;
        return "OK";
    }

    if (cmd == "AT+DIGI_LOC2RF?")
        return String(config.digi_loc2rf ? "1" : "0");
    else if (cmd == "AT+DIGI_LOC2RF=1")
    {
        config.digi_loc2rf = true;
        return "OK";
    }
    else if (cmd == "AT+DIGI_LOC2RF=0")
    {
        config.digi_loc2rf = false;
        return "OK";
    }

    if (cmd == "AT+DIGI_LOC2INET?")
        return String(config.digi_loc2inet ? "1" : "0");
    else if (cmd == "AT+DIGI_LOC2INET=1")
    {
        config.digi_loc2inet = true;
        return "OK";
    }
    else if (cmd == "AT+DIGI_LOC2INET=0")
    {
        config.digi_loc2inet = false;
        return "OK";
    }

    if (cmd == "AT+DIGI_TIMESTAMP?")
        return String(config.digi_timestamp ? "1" : "0");
    else if (cmd == "AT+DIGI_TIMESTAMP=1")
    {
        config.digi_timestamp = true;
        return "OK";
    }
    else if (cmd == "AT+DIGI_TIMESTAMP=0")
    {
        config.digi_timestamp = false;
        return "OK";
    }

    if (cmd == "AT+DIGI_SSID?")
        return String(config.digi_ssid);
    else if (cmd.startsWith("AT+DIGI_SSID="))
    {
        config.digi_ssid = cmd.substring(13).toInt();
        return "OK";
    }

    if (cmd == "AT+DIGI_MYCALL?")
        return String(config.digi_mycall);
    else if (cmd.startsWith("AT+DIGI_MYCALL="))
    {
        cmd.remove(0, 15);
        cmd.replace("\"", "");
        strncpy(config.digi_mycall, cmd.c_str(), sizeof(config.digi_mycall));
        return "OK";
    }

    if (cmd == "AT+DIGI_PATH?")
        return String(config.digi_path);
    else if (cmd.startsWith("AT+DIGI_PATH="))
    {
        config.digi_path = cmd.substring(13).toInt();
        return "OK";
    }

    if (cmd == "AT+DIGI_DELAY?")
        return String(config.digi_delay);
    else if (cmd.startsWith("AT+DIGI_DELAY="))
    {
        config.digi_delay = cmd.substring(14).toInt();
        return "OK";
    }

    if (cmd == "AT+DIGIFILTER?")
        return String(config.digiFilter);
    else if (cmd.startsWith("AT+DIGIFILTER="))
    {
        config.digiFilter = cmd.substring(14).toInt();
        return "OK";
    }

    if (cmd == "AT+DIGI_BCN?")
        return String(config.digi_bcn ? "1" : "0");
    else if (cmd == "AT+DIGI_BCN=1")
    {
        config.digi_bcn = true;
        return "OK";
    }
    else if (cmd == "AT+DIGI_BCN=0")
    {
        config.digi_bcn = false;
        return "OK";
    }

    if (cmd == "AT+DIGI_GPS?")
        return String(config.digi_gps ? "1" : "0");
    else if (cmd == "AT+DIGI_GPS=1")
    {
        config.digi_gps = true;
        return "OK";
    }
    else if (cmd == "AT+DIGI_GPS=0")
    {
        config.digi_gps = false;
        return "OK";
    }

    if (cmd == "AT+DIGI_LAT?")
        return String(config.digi_lat, 6);
    else if (cmd.startsWith("AT+DIGI_LAT="))
    {
        config.digi_lat = cmd.substring(12).toFloat();
        return "OK";
    }
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
