nakhonthai/ESP32APRS_Audio/(commit log)

2025-03-17 Update new version 1.4a testing
    [flash_16MB.csv, flash_8MB.csv]
2025-08-23 Add ADC Read sample for ESP32 Rev.1
2025-09-08 Fix heap memory reboot after TX on RF
    [config.cpp, main.cpp, main.h, webservice.cpp]
2025-11-22 Fix web socket service
    [main.cpp, webservice.cpp, webservice.h]
2025-11-22 Add auto reset timer
    [config.cpp, config.h, main.cpp, webservice.cpp]
2025-11-23 Fix message & network
    [main.cpp, wireguard_vpn.cpp, wireguard_vpn.h]
2025-11-24 Fix get host from dns for wireguard
    [main.cpp, webservice.cpp, wireguard_vpn.cpp]
2025-11-25 Add CPU Temperature
2025-11-26 Fix auto digirepeater bcn
    [config.cpp, config.h, main.cpp]
2025-11-28 Fix use VPN1 service
    [webservice.cpp]
2025-11-30 Fix README
    [flash_NOOTA.csv]
2025-12-02 Fix Serial & GPS
    [main.cpp, main.h, webservice.cpp]
2025-12-03 Fix system telemetry use object of tracker
    [main.cpp]
2025-12-07 Fix digi beacon interval
    [main.cpp]
2026-02-28 Fix ESP32-S3 RX freeze after TX and CSMA collisions
    [config.cpp, main.cpp, webservice.cpp]
2026-02-28 Fix to use psram protect by Semaphore
    [main.cpp, message.cpp, webservice.cpp]
2026-03-04 Fix use local memory in webservice
    [main.h, webservice.cpp, webservice.h]
2026-04-16 Fix critical FX.25 buffer management and add duplicate packet detection
    This commit addresses multiple critical issues in FX.25 reception that were
    causing packet loss, duplicates, and buffer overflow in iGate mode:
    1. **Critical Reed-Solomon Bug Fix** (lib/lwfec/gf.cpp)
    - Fixed polynomial addition bug: p2[2] → p2[i]
    - This bug corrupted error locator polynomial calculations
    - Made FX.25 error correction unreliable or impossible
    2. **FX.25 Buffer Management Fix** (lib/LibAPRS_ESP32/AX25.cpp)
    - Fixed parseFx25Frame() incrementing rxFrameHead before validation
    - Now only increments after successful CRC validation
    - Added proper cleanup when FX.25 parsing fails
    - Fixed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
    [igate.cpp, igate.h, main.h]
2026-04-16 Fix WiFi STA reconnection to prevent unnecessary AP roaming
    This commit addresses critical WiFi stability issues in iGate mode where
    WiFi would disconnect and roam to different APs instead of reconnecting
    to the original AP, causing connection instability and APRS-IS drops.
    **Problems Fixed:**
    1. wifiMulti.run() was being used for reconnection, which is designed
    for roaming between APs, not stable reconnection to the same AP
    2. No tracking of currently connected AP for targeted reconnection
    3. Slow reconnection (waiting for 30 disconnects before action)
    4. Immediate roaming to other APs on any disconnect
    **Changes Made:**
    1. **Current AP Tracking** (src/main.cpp)
    - Added currentAPSS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
    [main.cpp]
2026-04-24 Fix critical memory leaks in ESP32APRS iGate system
    This commit addresses critical memory leak issues that cause continuous
    heap degradation even when all major features (IGATE, DIGI, WX, TRACKER,
    VPN, PPPoS, APRS-IS) are disabled and there's no AFSK signal input.
    **Root Causes Fixed:**
    1. **Sensor Object Memory Leaks** (CRITICAL - ~500+ bytes per event)
    - Added cleanupSensors() function to properly free dynamically allocated sensor objects
    - Previously: bme, bmp280, Si7021, ccs, sht objects created with 'new' but never deleted
    - Fixed: All sensor objects now properly deleted when no longer needed
    - Called automatically during WiFi reconnection to prevent accumulation
    2. **Str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
    [igate.cpp, main.cpp, sensor.cpp, sensor.h]
2026-04-26 Fix critical ADC memory leaks and compilation errors
    This commit addresses critical memory leaks in the ADC subsystem and resolves
    compilation errors that prevented the project from building.
    ADC Memory Leak Fixes (~1.5-2.5 KB per cycle):
    - Added AFSK_deinit() function to properly cleanup ADC resources
    - Properly stop and delete adc_continuous_handle (AdcHandle)
    - Delete adc_cali_handle (AdcCaliHandle) using correct API
    - Free audio_buffer memory that was allocated with calloc
    - Call AFSK_deinit() during WiFi reconnection to prevent accumulated leaks
    Compilation Error Fixes:
    - Remove conflicting 'String header' declaration in igateProcess()
    - Add missing 'currentLength' member to pkgListTy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
    [igate.cpp, main.cpp, main.h]
2026-04-26 Fix ADC API function name - use adc_continuous_deinit instead of adc_continuous_delete
    Corrected ESP-IDF API function name for proper ADC continuous handle cleanup.
    The correct function is adc_continuous_deinit(), not adc_continuous_delete().
2026-07-03 Fix Mic-E bug lat<10,Lon<100
    [main.cpp]
2026-07-03 Add Filter Igate all package
2026-07-11 Fix AX.25/FX.25 RX buffer corruption and ADC FIFO race causing RX stalls
    - parseFx25Frame() failures were cleaned up twice (once internally, once
    by the Ax25BitParse caller), rewinding rxBufferHead past the previous,
    still-unread frame and corrupting/losing it whenever an FX.25 block
    failed CRC or hit an illegal bit pattern.
    - removeLastFrameFromRxBuffer() targeted rxFrameHead-1 instead of
    rxFrameHead, a leftover from before rxFrameHead was changed to only
    advance on successful validation.
    - The HDLC 7-ones abort check was compiled out entirely whenever
    ENABLE_FX25 was defined (always, per platformio.ini), instead of just
    while parsing an actual FX.25 block; restored it for nor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
2026-07-11 Move gui_lcd sources into include/src, adjust build config
    - Relocate lib_extra/gui_lcd/src/{gui_lcd.cpp,gui_lcd.h} to src/ and
    include/ so they're picked up without the lib_extra include path.
    - platformio.ini: default_envs and build_flags tweaks for TTGO-TWR.
    - sensor.cpp: battery voltage reporting was gated on
    TTGO_T_Beam_S3_SUPREME_V3 instead of TTGO_TWR.
    - webservice.cpp: /about board-name string tweaks.
    - main.cpp/main.h: move AsyncTCP include, bump telemetry TX retry
    delay.
